SimeonSimeonovIvanov/DC-Servo/README.md

# DC-Servo

![Screen Shot](https://lh3.googleusercontent.com/Xv3BVXqilZLEP8sdvjcjL_cJQlbgq7jir3yXWfOCIcPaj5MP4WAdabvjKhuMbhHNSys4aJBLH0ocGfEHUz21YXoTrse0sBRuv8U6clvefDdncbCatKfYfFrh_Kx5vuFFZ4D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)<br>
![Screen Shot](https://lh3.googleusercontent.com/8H75xgIba8NfEHbxRjB1vH5L4gFnyypGXjzJJ4FnqissgkqRR1jED1oAVVKYW1irBBSW7dX9zWwABgqFDOacOuICHrz5z6lwR_7vQ9Z6tNkFcHOUY45h3Q94_kpth4GqoXR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)<br>
[DC Servo - Pulse Testing](https://www.youtube.com/watch?v=2nZXUcoeyds)<br>
[Images](https://photos.google.com/share/AF1QipMzZ-ynxjgMDZ_RqFM_1IZ0rQbRRlL92HL_IAoDkJfIh321sr6dbftCyruxnr1hNQ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)<br>

http://mcu-bg.com/mcu_site/viewtopic.php?p=176662#p176662:<br>
"Здравейте,

Покрай РОБКО 01 започнах разработка на аналогово DC Servo или по-точно серво усилвател управляващ постояннотоков мотор по скорост. Следващата стъпка е добавяне на Motion Controler. За момента преправям готов код но ще мине доста време до първите тестове.

Сервото се състой от два отделни модула (платки):

1) Токов регулатор (Power Stage.sch) – поддържа тока (въртящия момента) на мотора постоянен спрямо заданието от скоростния регулатор. Предпочетох да избегна аналоговия PI регулатор с по-добрия (според мене) токов ШИМ - на практика P регулатор с голям коефициент на усилване.

2) Скоростен регулатор (Speed Reg.sch) – поддържа ъгловата скорост на мотора постоянна спрямо аналогово задание от ±10V. Самия регулатор има Ramp генератор определящ времето за развъртане на двигателя, цифров вход за реверс удобен при свързване с контролер с еднополярен DAC. Заданието за ток е положително, а посоката се задава от скоростния регулатор през схема генерираща мъртво време за отделните рамена на H-моста. Рзбира и един от най-важните възли – токоограничение. Подходящ в приложения изискващи регулиране на максималния въртящ момент.

Прикачам архив съдържащ две версии на сервото:
1) v.0.0.0 – по нея е изработен прототипа но има множество забележки.
2) v.0.0.1 – в схемата са отстранени голяма част грешките / пропуските от v.0.0.0 но не са довършени платките.

Актуални са EAGLE 5.11 файловете и PDF съдържащи схемите. Архива съдържа и CircuitMaker 2000 симулации на отделните възли.

В показаният playlist се вижда преходната характеристика на скоростния регулатор при различни задания:

DC Servo - Playlist

При проектирането съм ползвал схемни решения от тиристорни регулатори КЕМТОР, КЕМРОС и други. Дължа благодарности на работодателите ми от ЕЛСИ ООД за споделения опит в областта на тиристорните задвижвания.

Поздрави,
Симеон Иванов

РУСЕ,
2014г."

http://mcu-bg.com/mcu_site/viewtopic.php?p=281388#p281388:

"Малко симулации направени по време на разработката / Git: DC-Servo /:
Analog Current PI Loop, FB signal:"

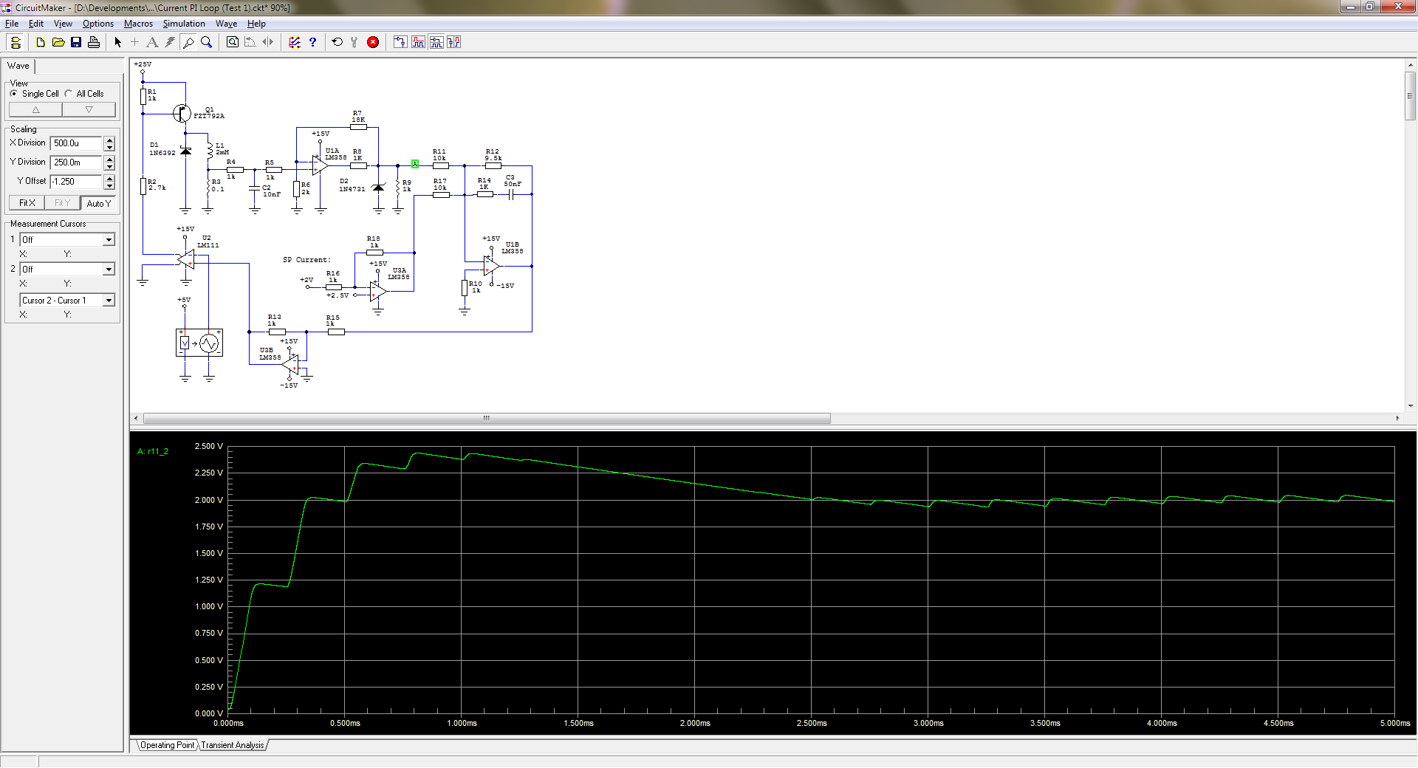
[picture p1: Work/Simulation/Current PI Loop/Current PI Loop (Test 1) - FB.png]
<br>

Current PWM (Digital):
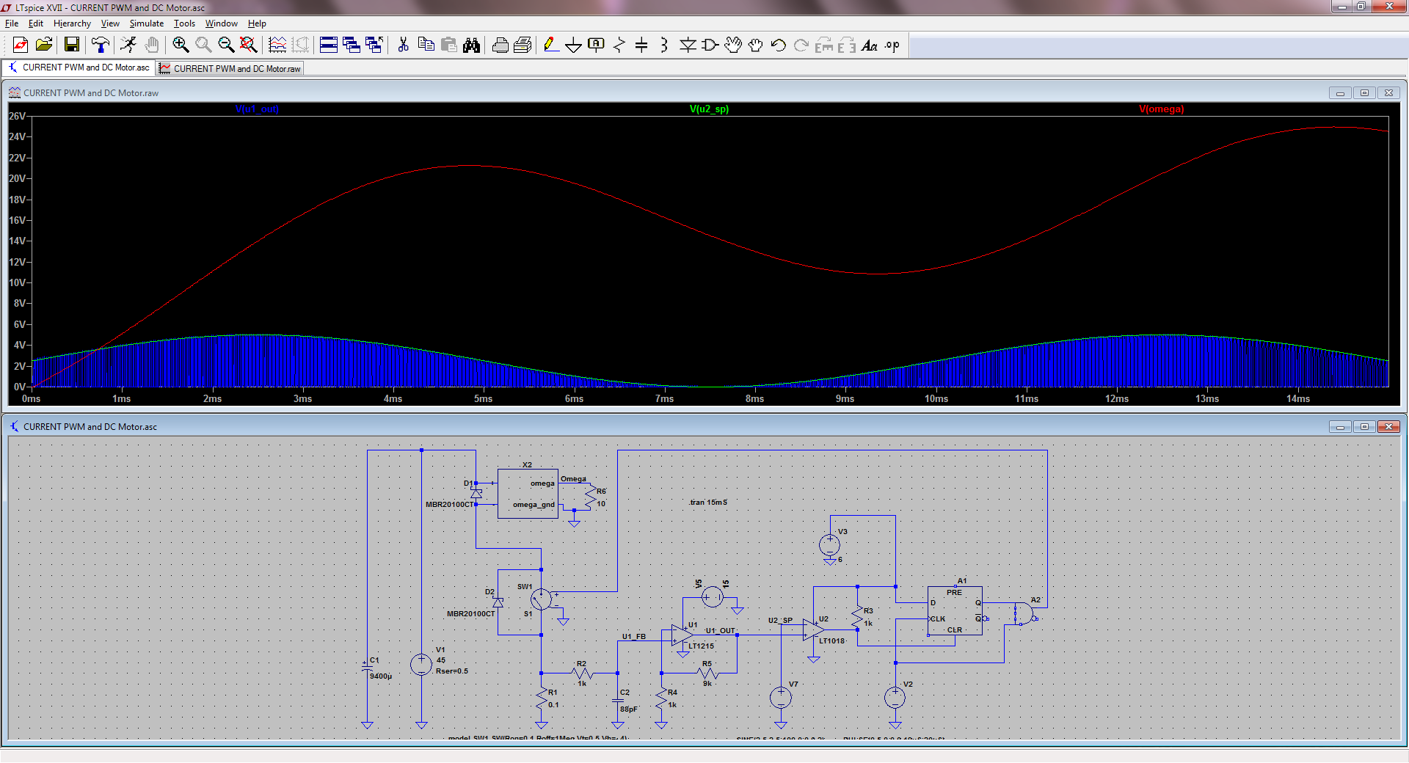
[picture p2: Work/Simulation/CURRENT PWM/CURRENT PWM and DC Motor.png]
<br>
