SimeonSimeonovIvanov/DC-Servo/doc/DC Servo (Power Point)/DC Servo (04.04.2015).pdf

ПРИЛОЖЕН СЕМИНАР ПО ЕЛЕКТРОНИКА И СОФТУЕР
РУСЕНСКИ УНИВЕРСИТЕТ „АНГЕЛ КЪНЧЕВ” 2015 г.

### Серво усилвател и позиционен контролер за DC мотор

гр.Русе, 2015

автор: Симеон Иванов

## Цел

- Управление на постоянотоков мотор по зададен момент, скорост и позиция

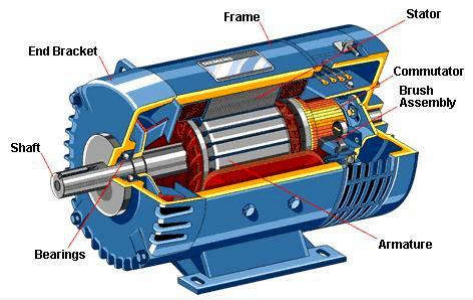
[picture p3: figure]

### Постоянотокови мотор

- Постоянотоковите мотори (DC Motors) се делят на две големи групи:
1. Четкови
2. Безчеткови (BLDC)
- При четковите мотори комутацията на тока през намотките се осъществява механично
- Безчетковите мотори ползват електронен комутатор

### Базов модел на DC motor

- Момента на мотор M [Nm] е пропорционален на тока през мотора I !

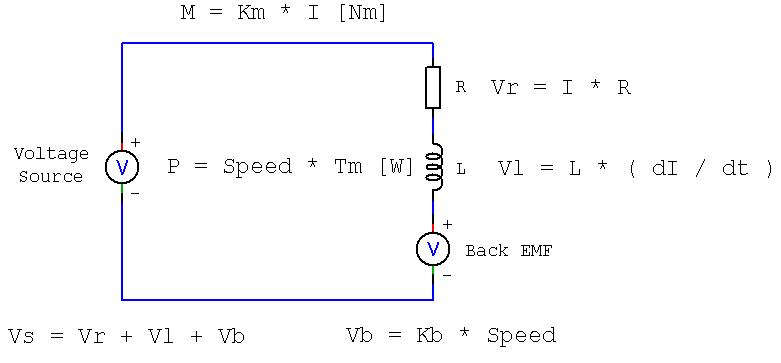
[picture p4: figure]

### Блокова схема на серво усилвател

- Система за автоматично регулиране изградена с два затворени контура (Closed-loop)

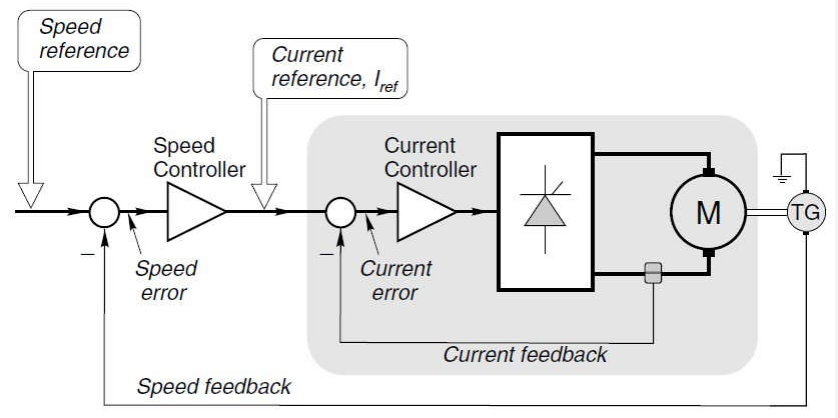
[picture p5: figure]

### Токов регулатор Класически метод

- Пропорционално - интегрален (PI) регулатор
- Напреженов ШИМ (PWM)

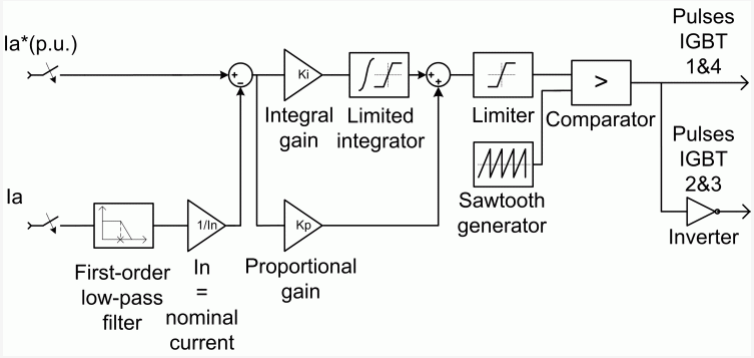
[picture p6: figure]

### Токов регулатор реализиран с токов ШИМ

- Ползва се ШИМ ограничаващ запълването си във всеки период

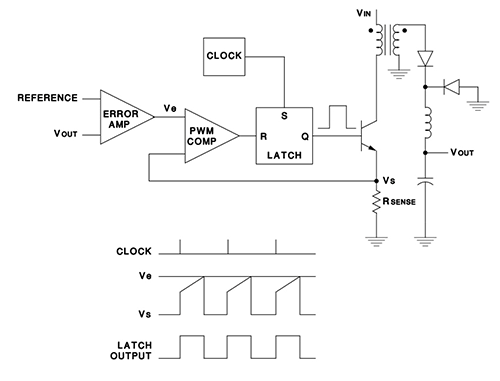
[picture p7: figure]

## Силова част – общ изглед

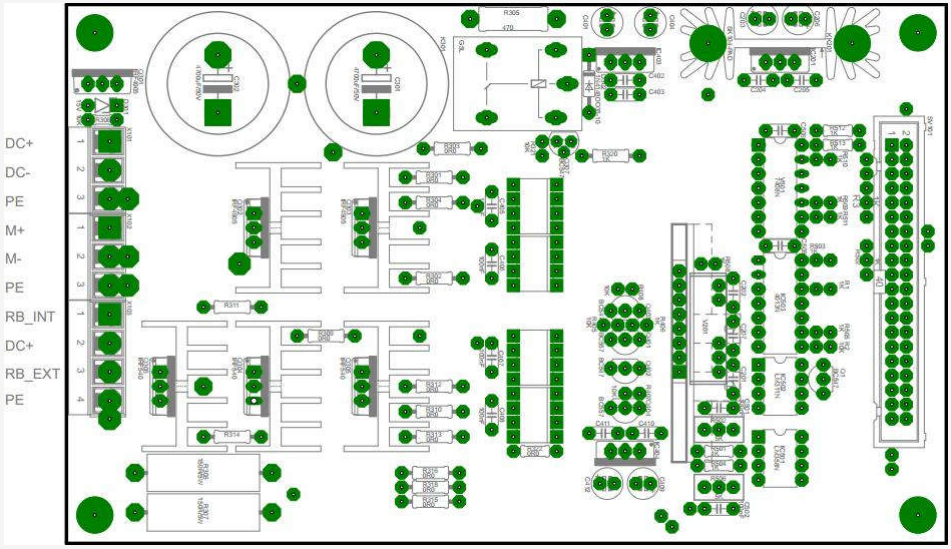
[picture p8: figure]

### Скоростен регулатор

- Аналогов пропорционално - интегрален регулатор

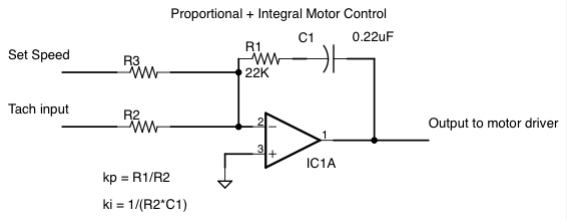
[picture p9: figure]

### Управляваща платка - общ изглед

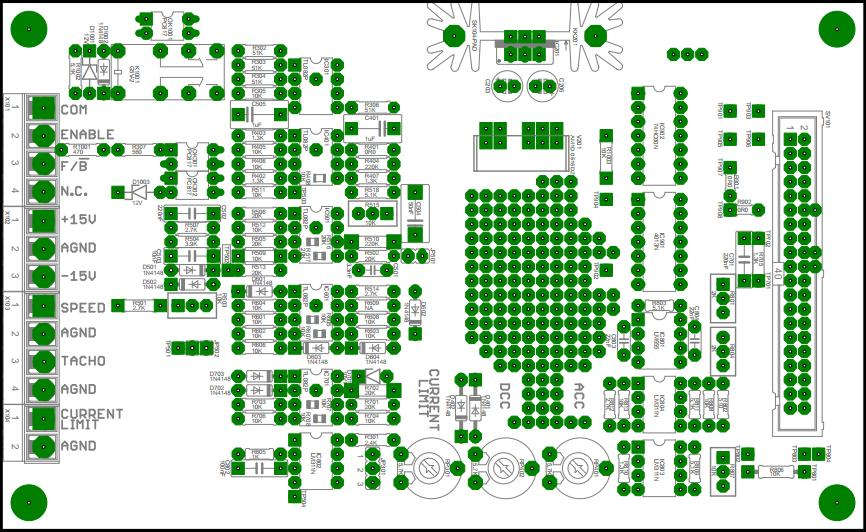
[picture p10: figure]

### Аналогов контрол на позиция

- Добавя се трети управляващ контур – позиционен регулатор

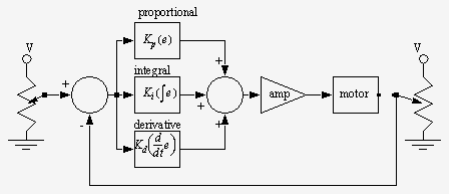
[picture p11: figure]

### Цифров позиционен регулатор

- Замяна на аналоговия PID с цифров регулатор
- Системата става много по-универсална и лесна за настройка
- Добавя се комуникация осигоряваща връзка с други устроиства

### Контролер на движението Motion Controller

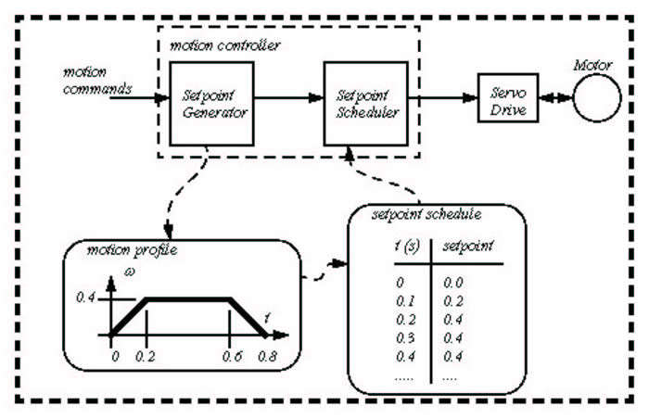
[picture p12: figure]
