SimeonSimeonovIvanov/DC-Servo/Work/Simulation/Brake.pdf

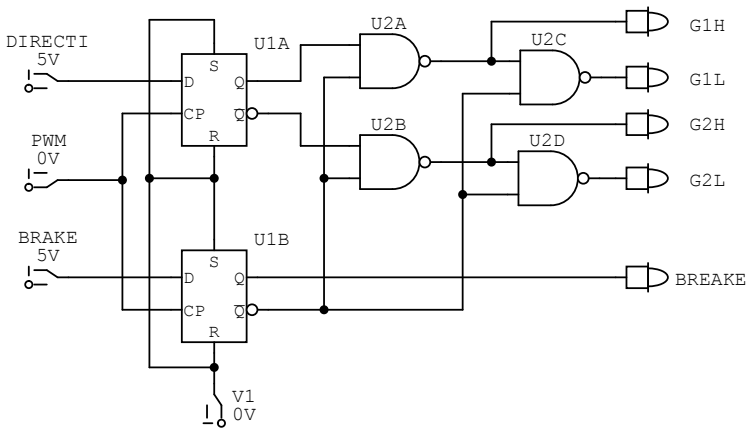
[picture p13: figure]
DIRECTI 5V; PWM 0V; BRAKE 5V; BREAKE
