SimeonSimeonovIvanov/DC-Servo/Work/Simulation/Dead Time.pdf

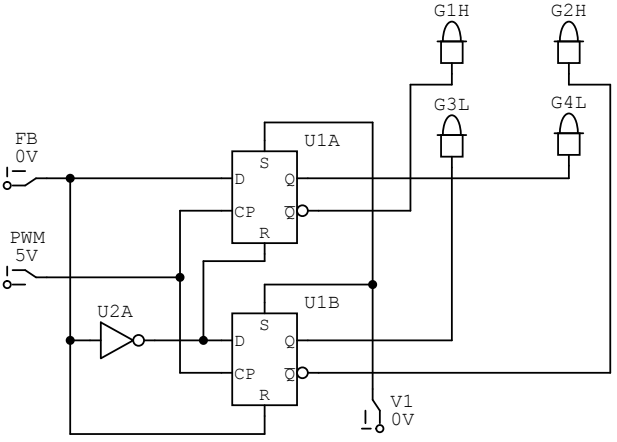
[picture p14: figure]
PWM 5V
