SimeonSimeonovIvanov/DC-Servo/Scheme and Board/v.0.0.1/Speed Reg/Simulation/Dead Time.pdf

PWM 5V
