SimeonSimeonovIvanov/DC-Servo/doc/DC Servo (Power Point)/img/001.JPG

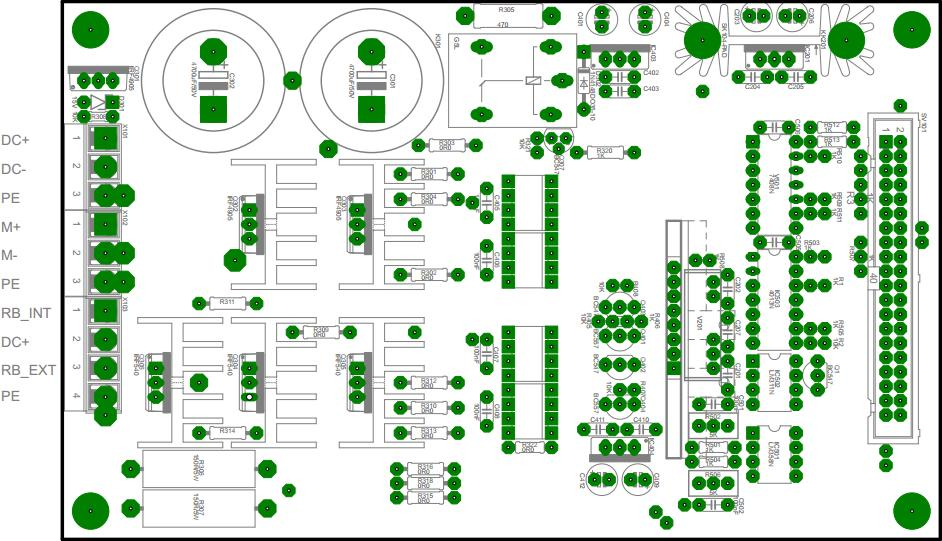
doc/DC Servo (Power Point)/img/001.JPG
