SimeonSimeonovIvanov/DC-Servo/doc/DC Servo (Power Point)/img/CURRENT PWM 2.ckt.JPG

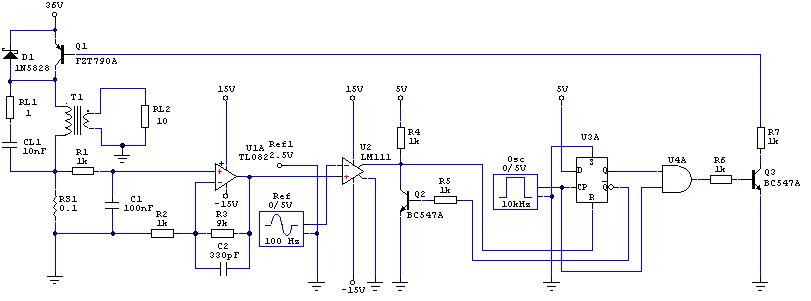
doc/DC Servo (Power Point)/img/CURRENT PWM 2.ckt.JPG
