SimeonSimeonovIvanov/DC-Servo/doc/DC Servo (Power Point)/img/dc_motor_drives_fig4.11.jpg

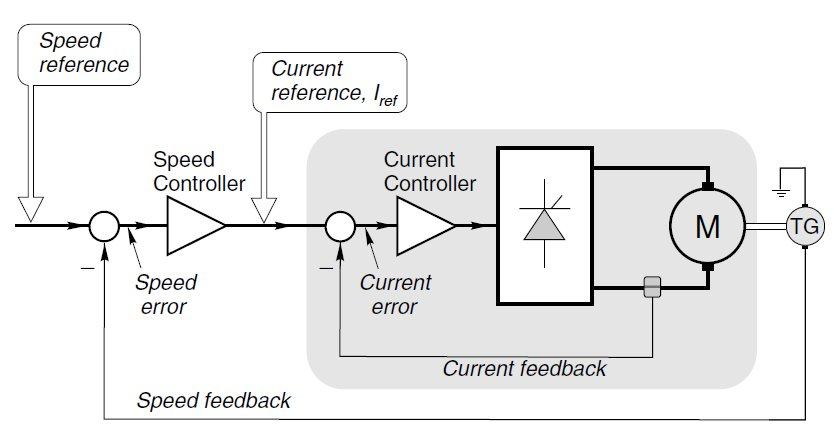
doc/DC Servo (Power Point)/img/dc_motor_drives_fig4.11.jpg
