SimeonSimeonovIvanov/DC-Servo/doc/DC Servo (Power Point)/img/engineeronadisk-56.gif

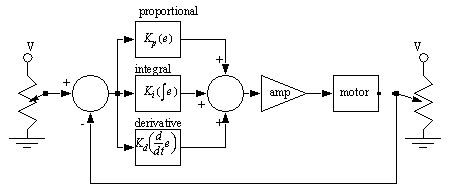
doc/DC Servo (Power Point)/img/engineeronadisk-56.gif
