SimeonSimeonovIvanov/DC-Servo/doc/DC Servo (Power Point)/img/f36f957f72a093559175396d0ab32c18.jpg

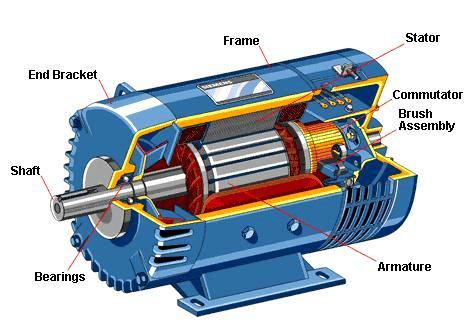
doc/DC Servo (Power Point)/img/f36f957f72a093559175396d0ab32c18.jpg
