SimeonSimeonovIvanov/DC-Servo/Work/Simulation/Current Limit.png

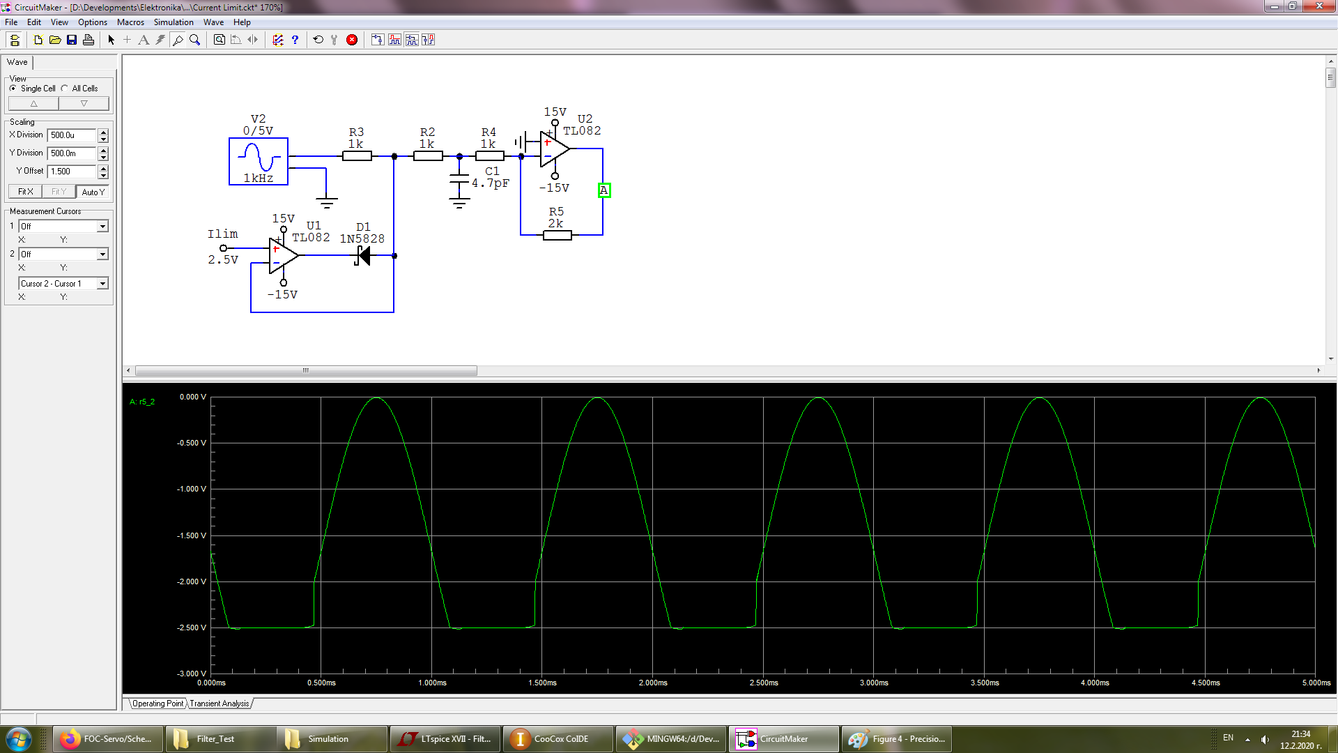
Work/Simulation/Current Limit.png
