SimeonSimeonovIvanov/DC-Servo/Work/Simulation/CURRENT PWM/CURRENT PWM 1.png

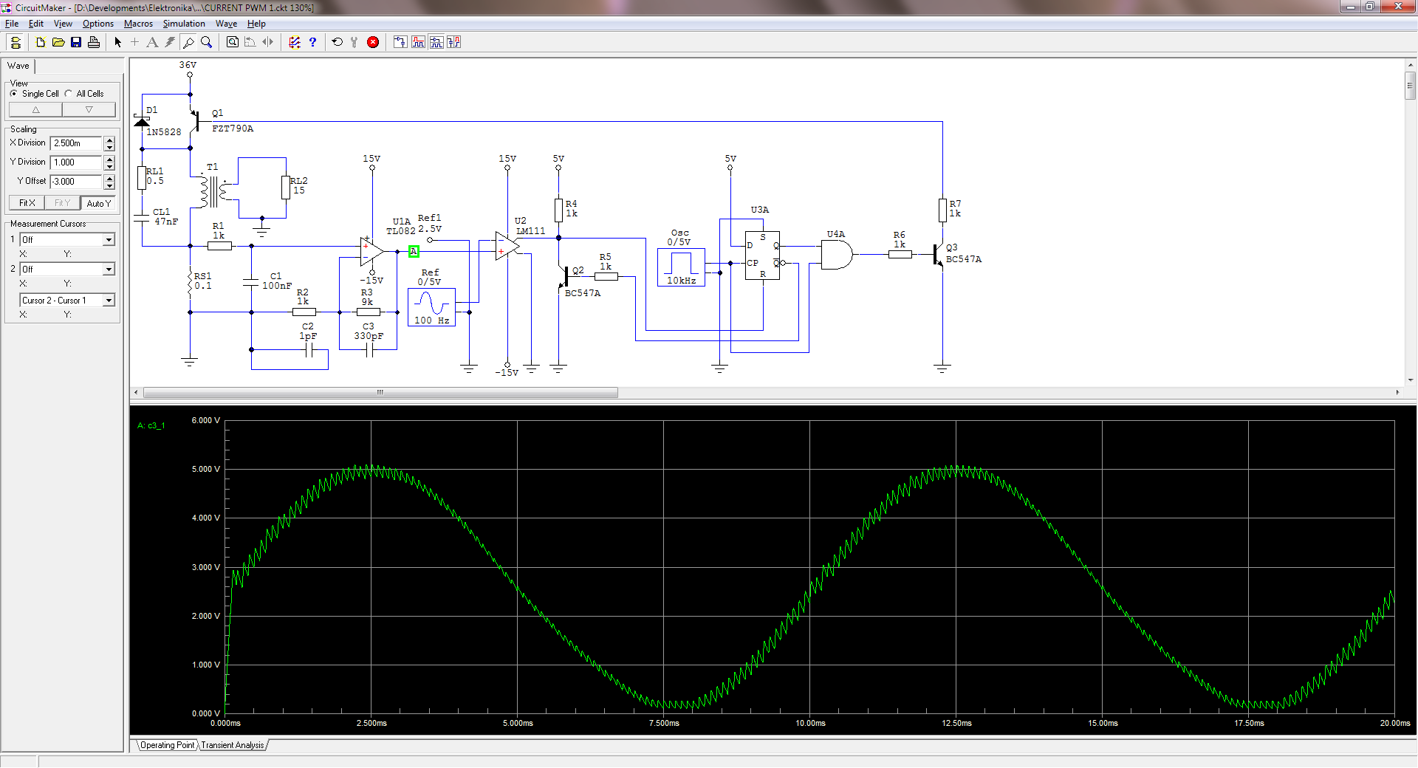
Work/Simulation/CURRENT PWM/CURRENT PWM 1.png
