SimeonSimeonovIvanov/DC-Servo/Work/Simulation/CURRENT PWM/CURRENT PWM 2.png

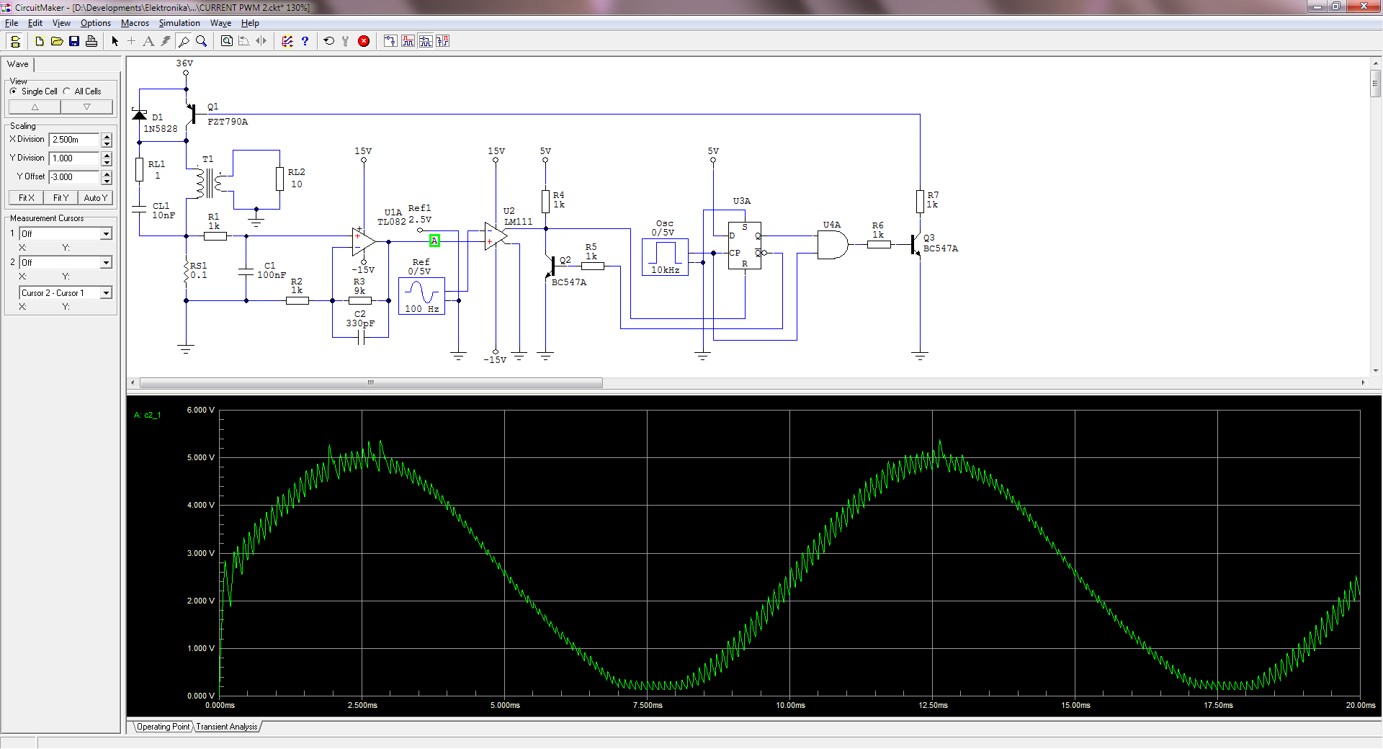
Work/Simulation/CURRENT PWM/CURRENT PWM 2.png
