SimeonSimeonovIvanov/DC-Servo/Work/Simulation/CURRENT PWM/DC_Motor.asc.png

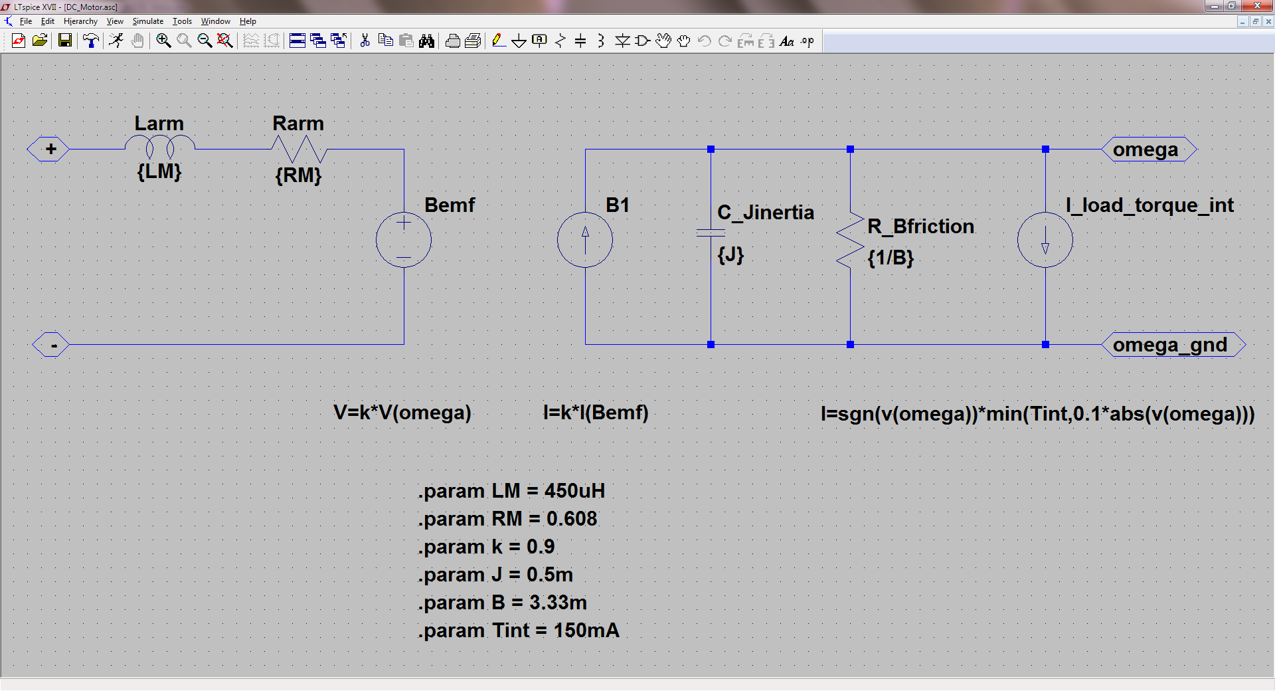
Work/Simulation/CURRENT PWM/DC_Motor.asc.png
