SimeonSimeonovIvanov/DC-Servo/Work/Simulation/Figure 4 - Precision Full Wave Rectifier.png

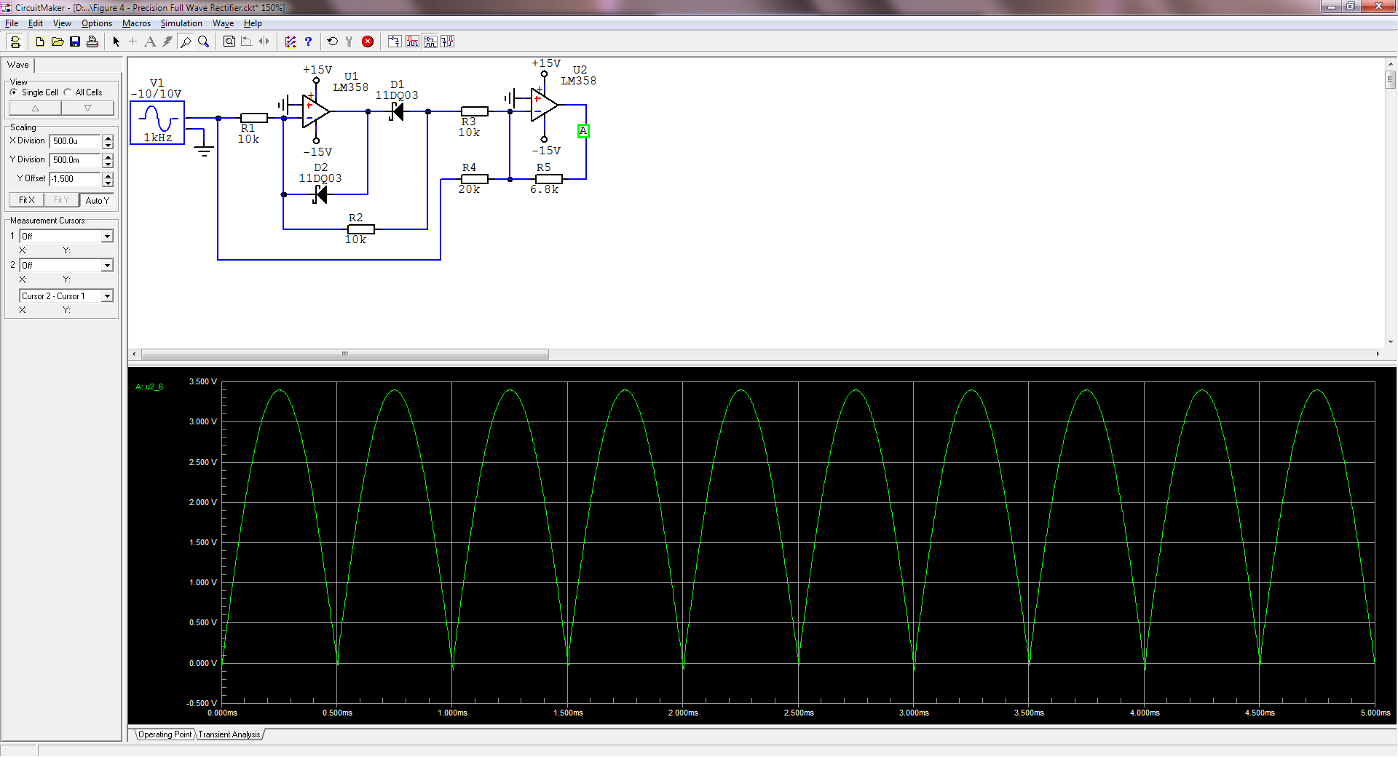
Work/Simulation/Figure 4 - Precision Full Wave Rectifier.png
