SimeonSimeonovIvanov/DC-Servo/Work/Simulation/Forward - Backward.png

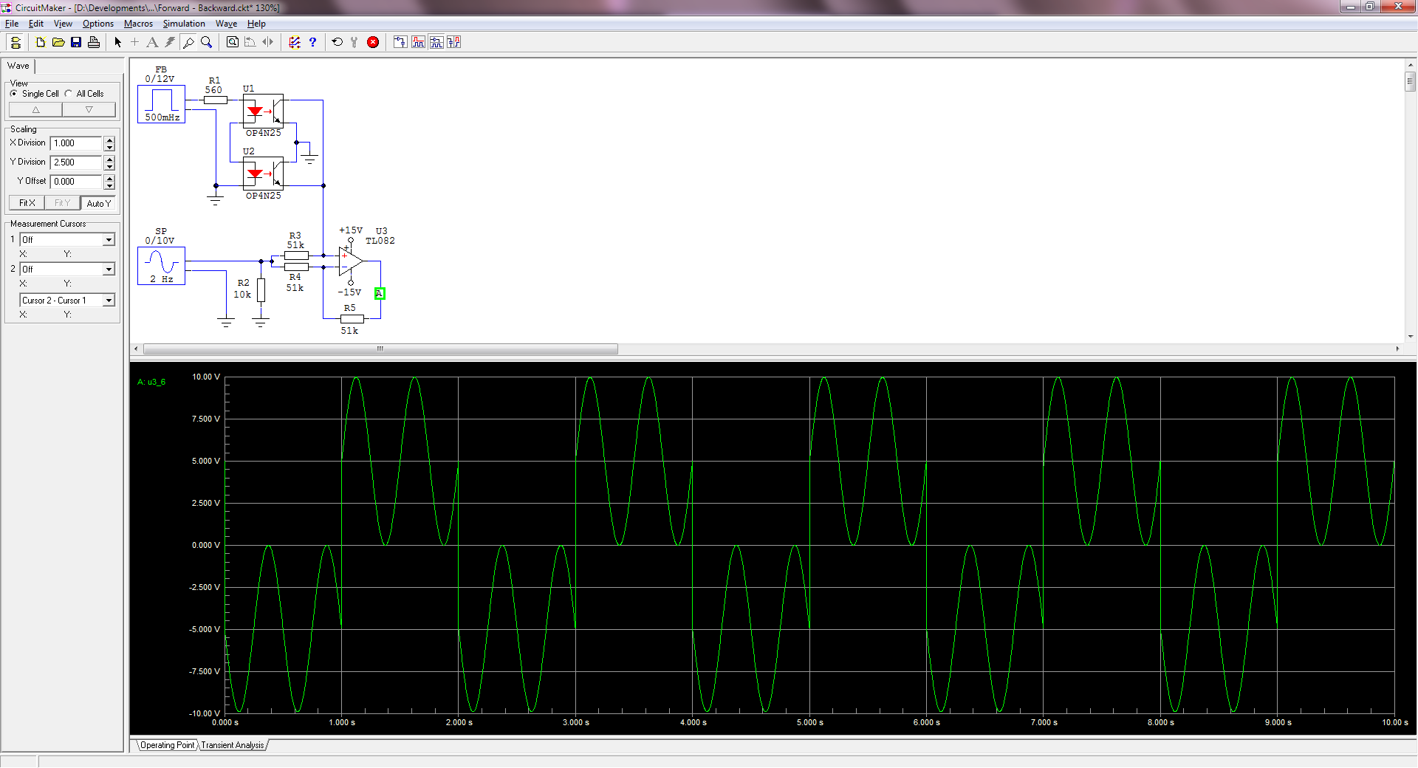
Work/Simulation/Forward - Backward.png
