SimeonSimeonovIvanov/DC-Servo/Work/Simulation/Level Limiter (ELEKTROINVENT).png

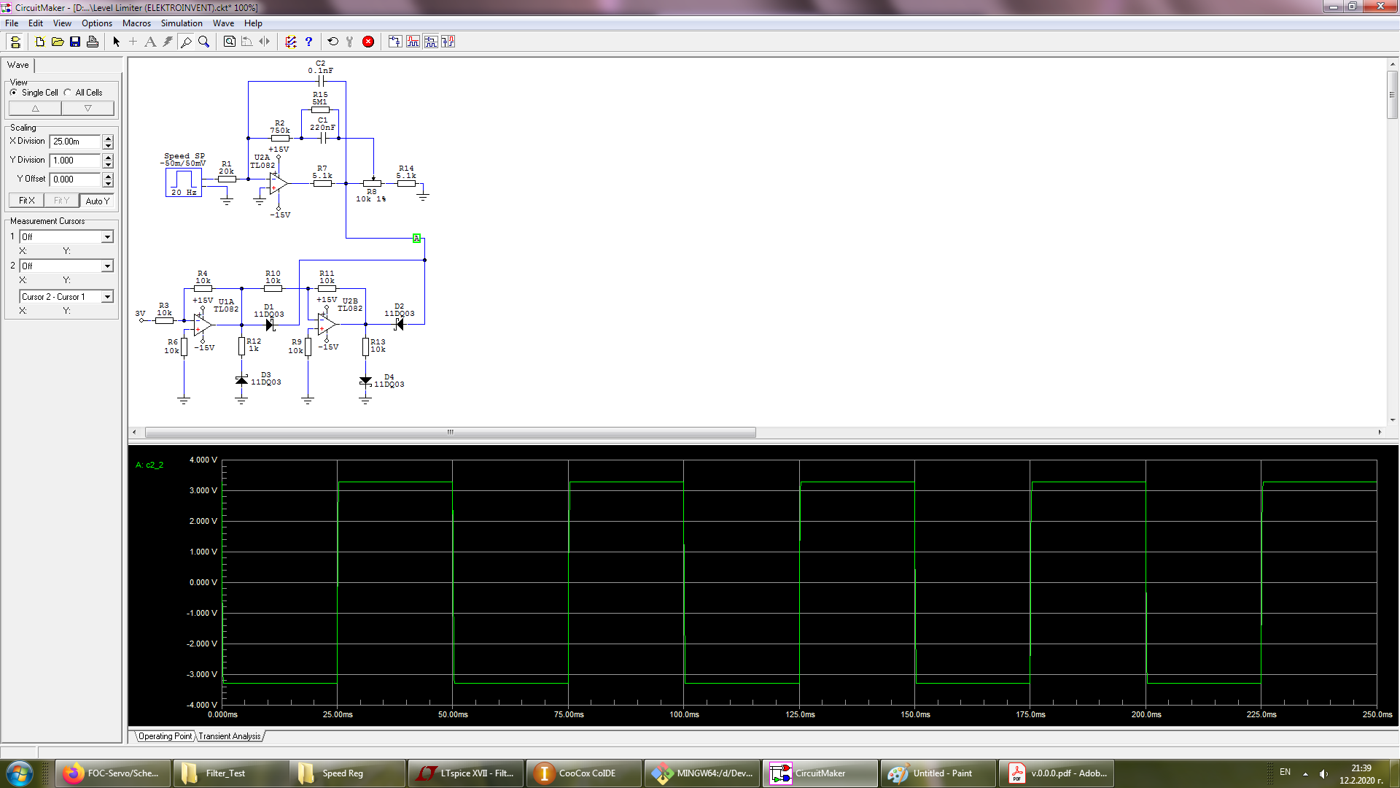
Work/Simulation/Level Limiter (ELEKTROINVENT).png
