SimeonSimeonovIvanov/DC-Servo/Work/Simulation/Ramp Generator.png

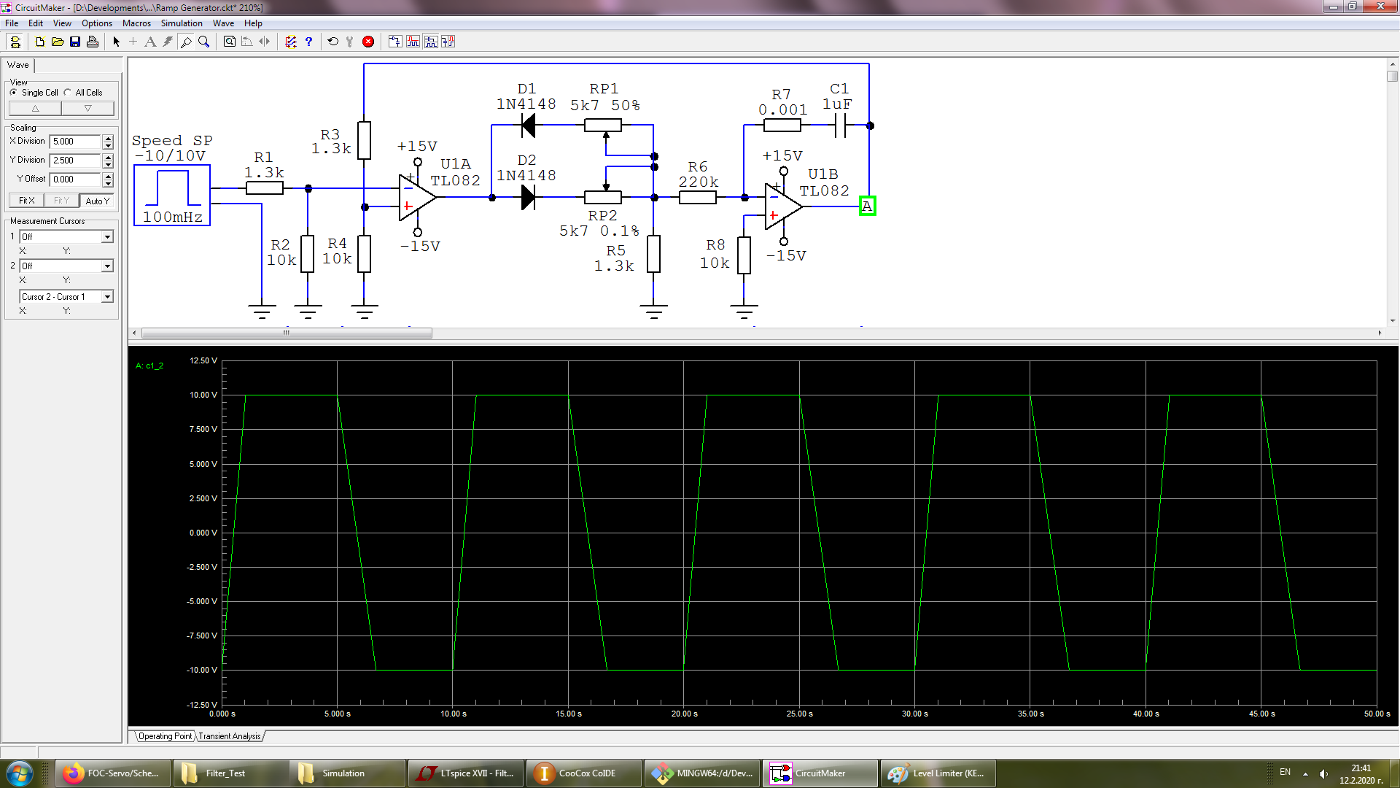
Work/Simulation/Ramp Generator.png
