SimeonSimeonovIvanov/DC-Servo/Work/Simulation/Speed Reg (PI).png

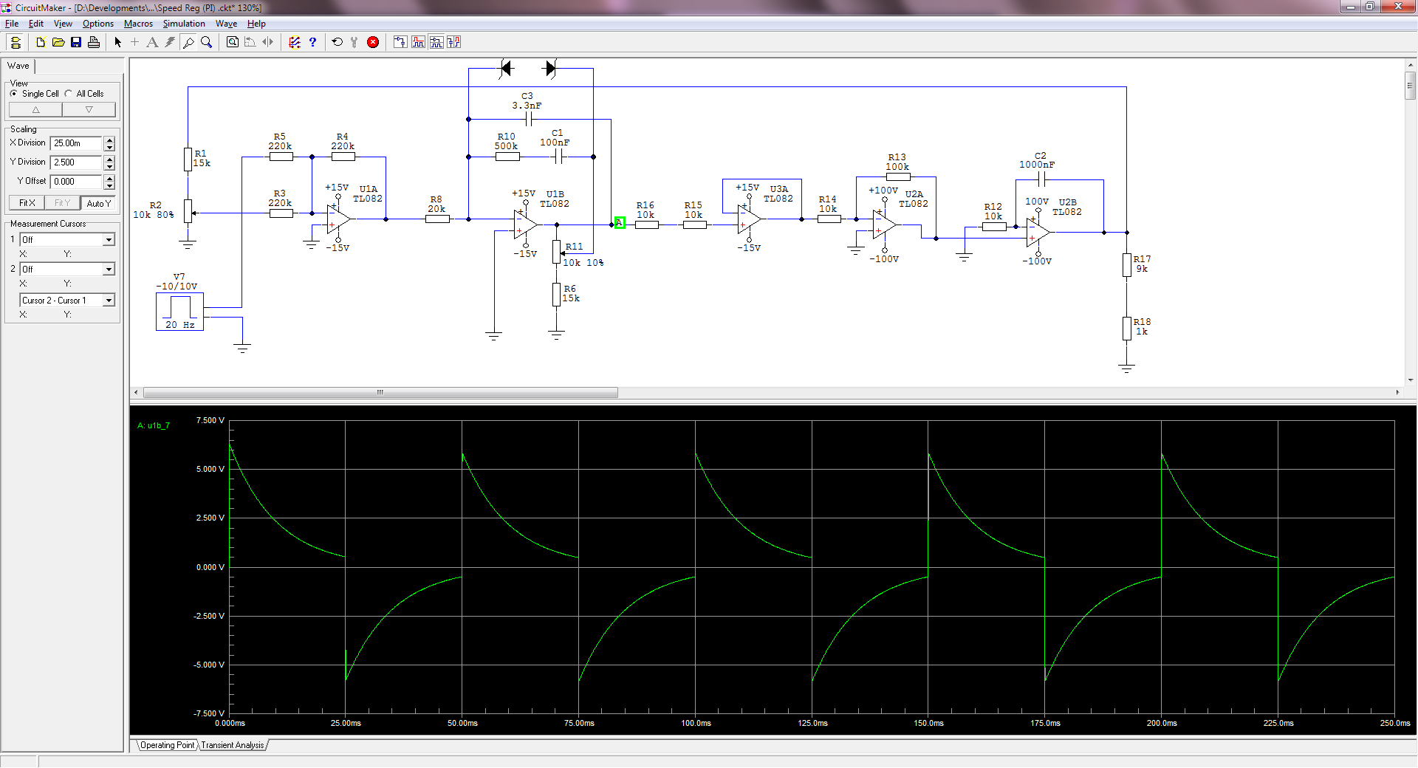
Work/Simulation/Speed Reg (PI).png
