SimeonSimeonovIvanov/DC-Servo/Scheme and Board/v.0.0.1/Speed Reg/Speed Reg.pdf

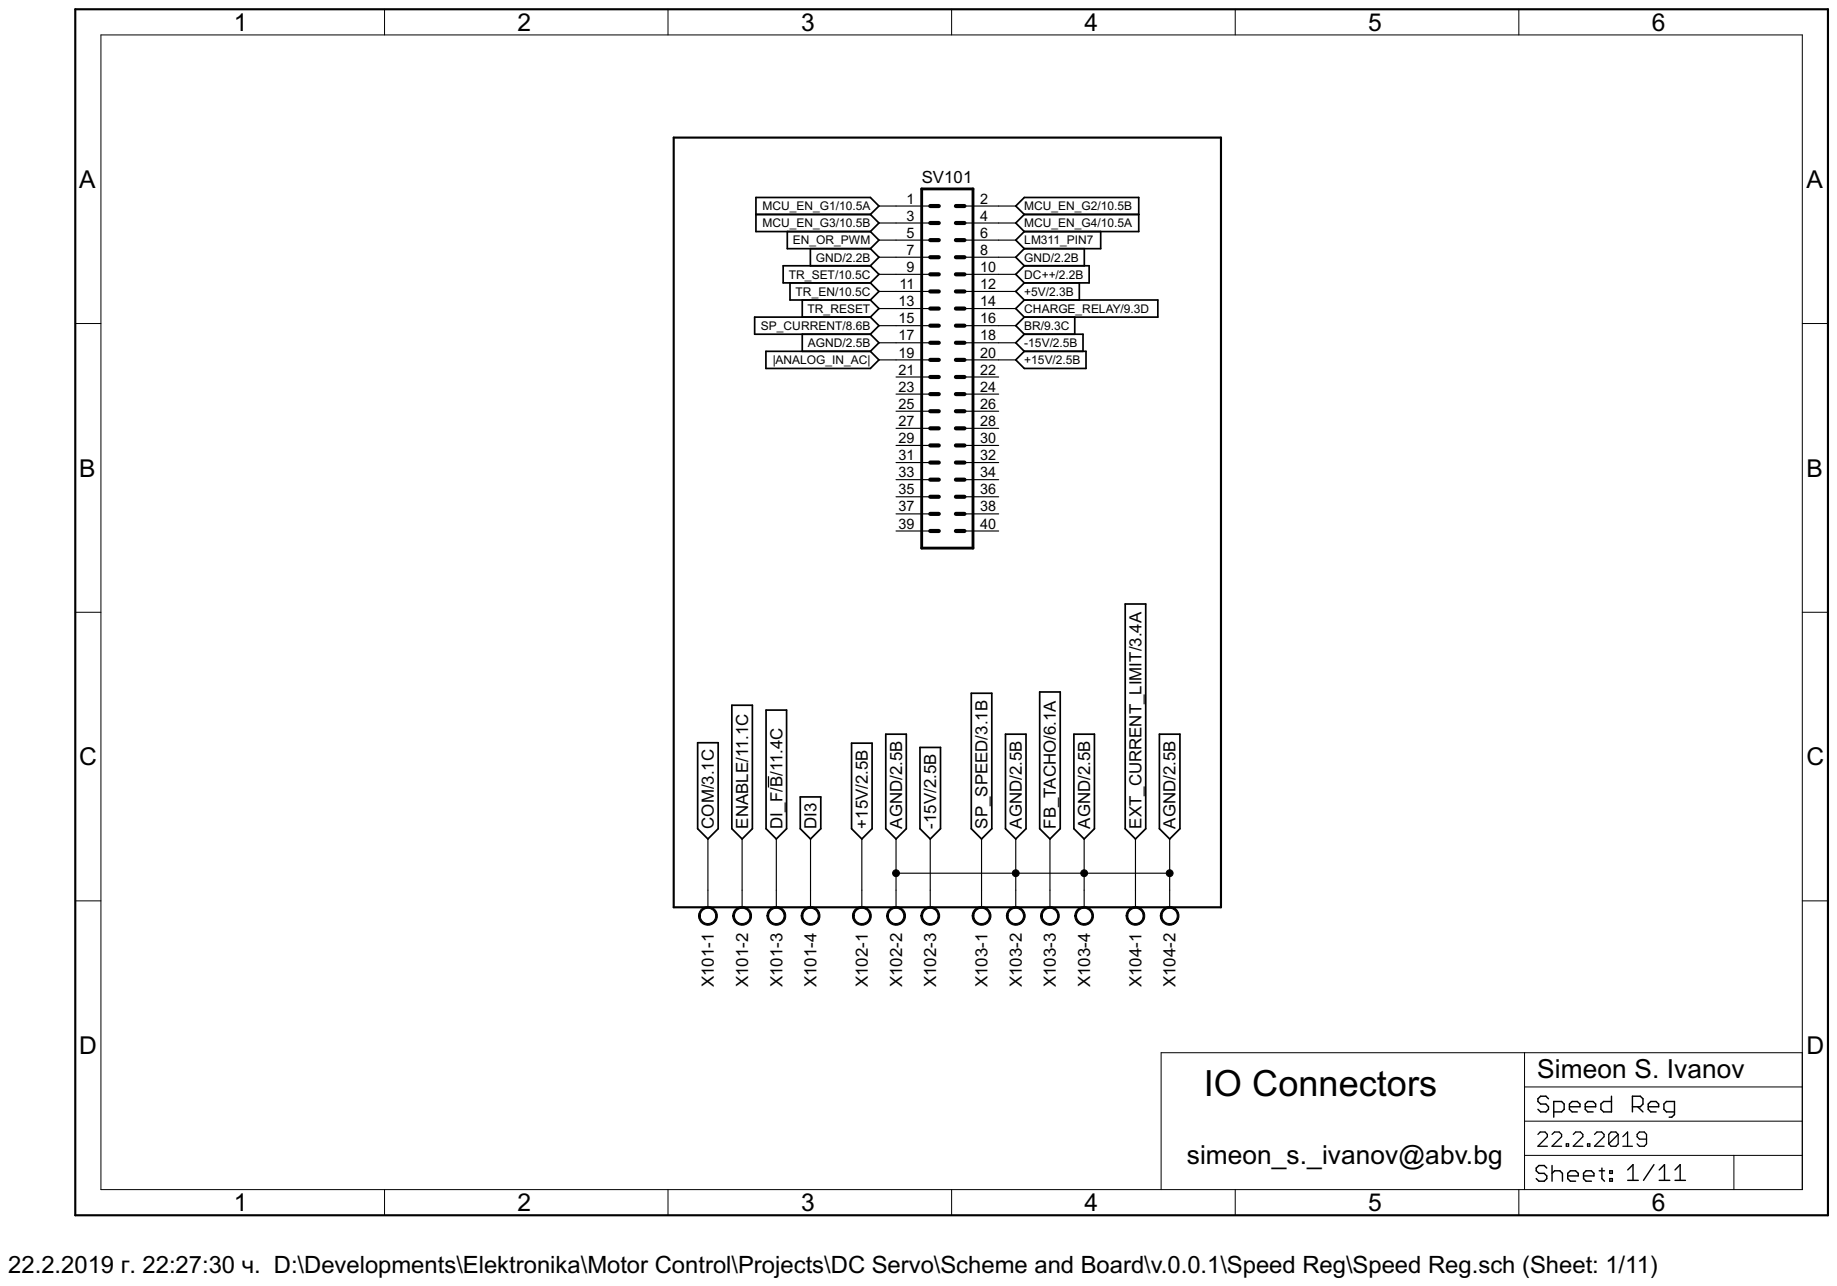
[picture p29: page 1]

AGND/2.5B | -15V/2.5B

ANALOG_IN_AC| | +15V/2.5B

22.2.2019 г. 22:27:30 ч. D:\Developments\Elektronika\Motor Control\Projects\DC Servo\Scheme and Board\v.0.0.1\Speed Reg\Speed Reg.sch (Sheet: 1/11)

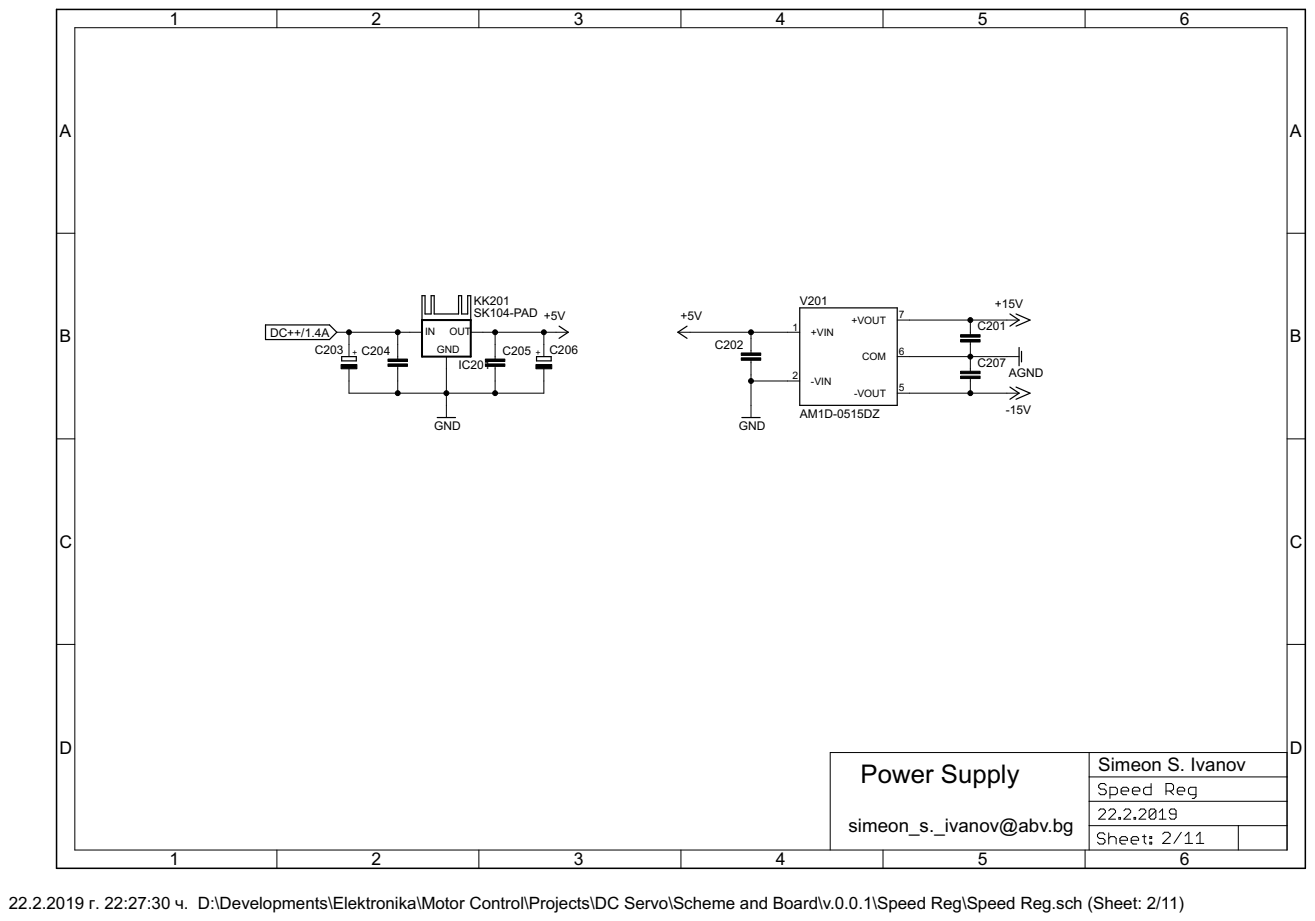
[picture p30: page 2]

Simeon S. Ivanov Power Supply

22.2.2019 г. 22:27:30 ч. D:\Developments\Elektronika\Motor Control\Projects\DC Servo\Scheme and Board\v.0.0.1\Speed Reg\Speed Reg.sch (Sheet: 2/11)

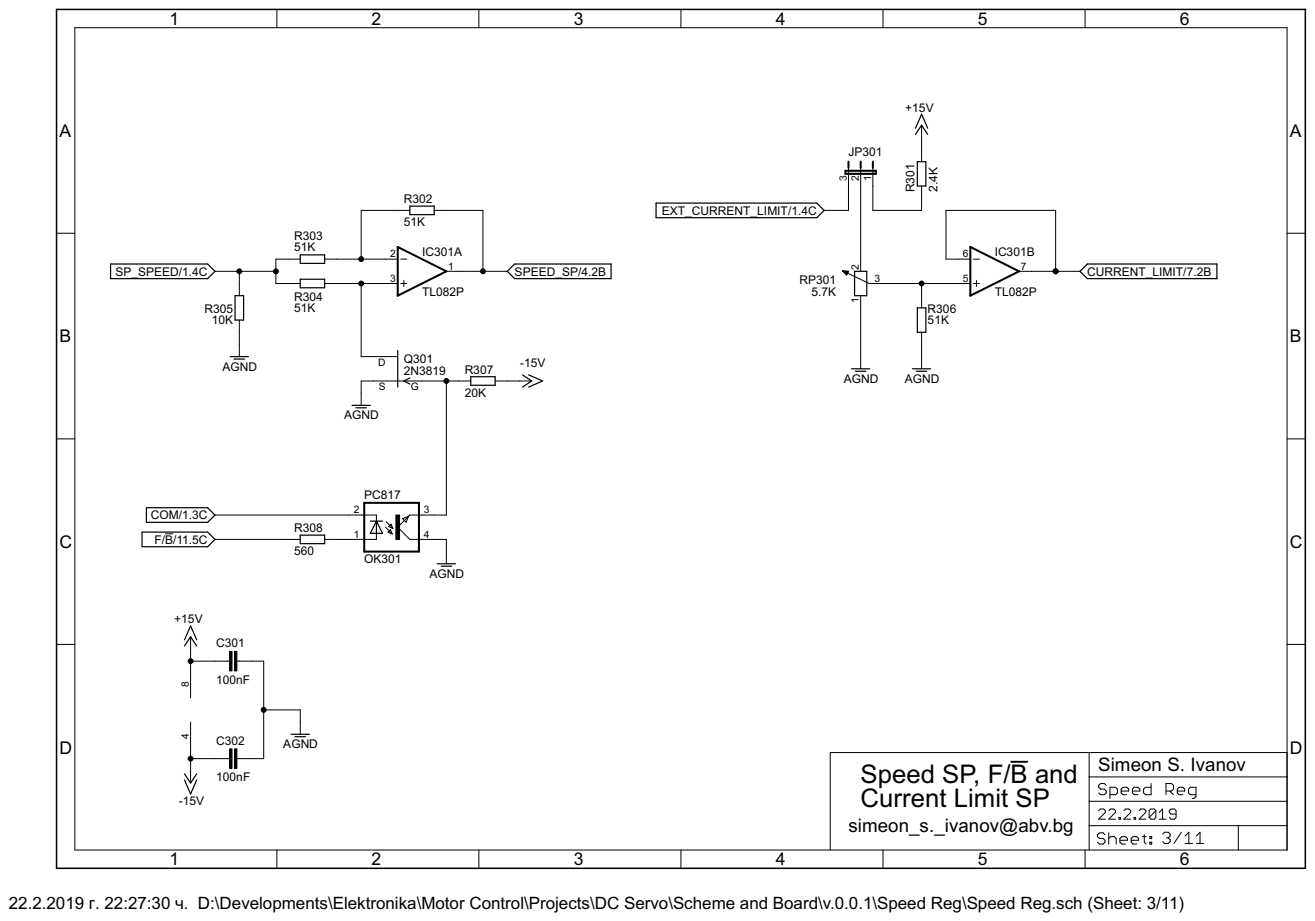
[picture p31: page 3]

Simeon S. Ivanov Speed SP, F/B and
Current Limit SP
simeon_s._ivanov@abv.bg

22.2.2019 г. 22:27:30 ч. D:\Developments\Elektronika\Motor Control\Projects\DC Servo\Scheme and Board\v.0.0.1\Speed Reg\Speed Reg.sch (Sheet: 3/11)

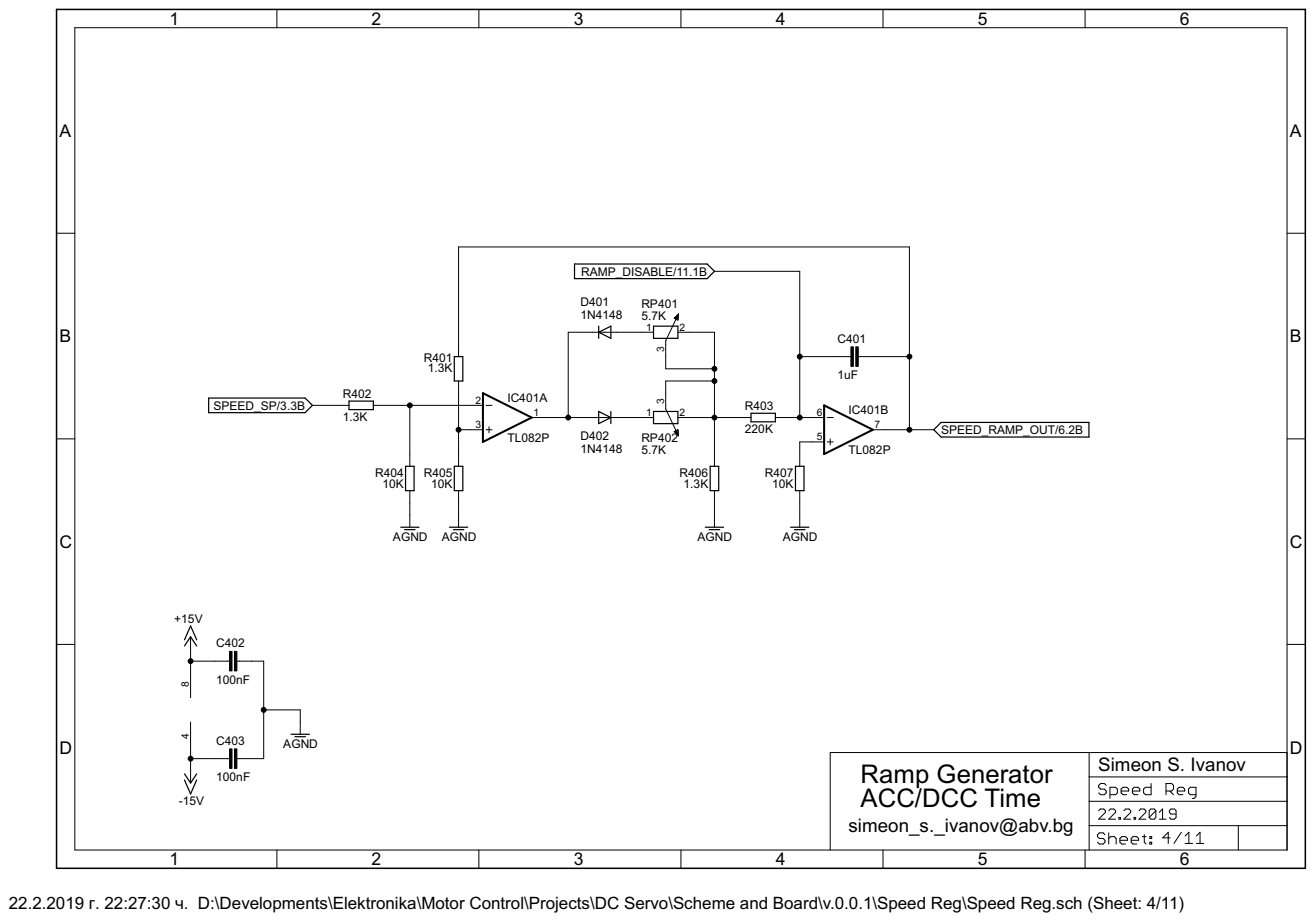
[picture p32: page 4]

Simeon S. Ivanov Ramp Generator
ACC/DCC Time
simeon_s._ivanov@abv.bg

22.2.2019 г. 22:27:30 ч. D:\Developments\Elektronika\Motor Control\Projects\DC Servo\Scheme and Board\v.0.0.1\Speed Reg\Speed Reg.sch (Sheet: 4/11)

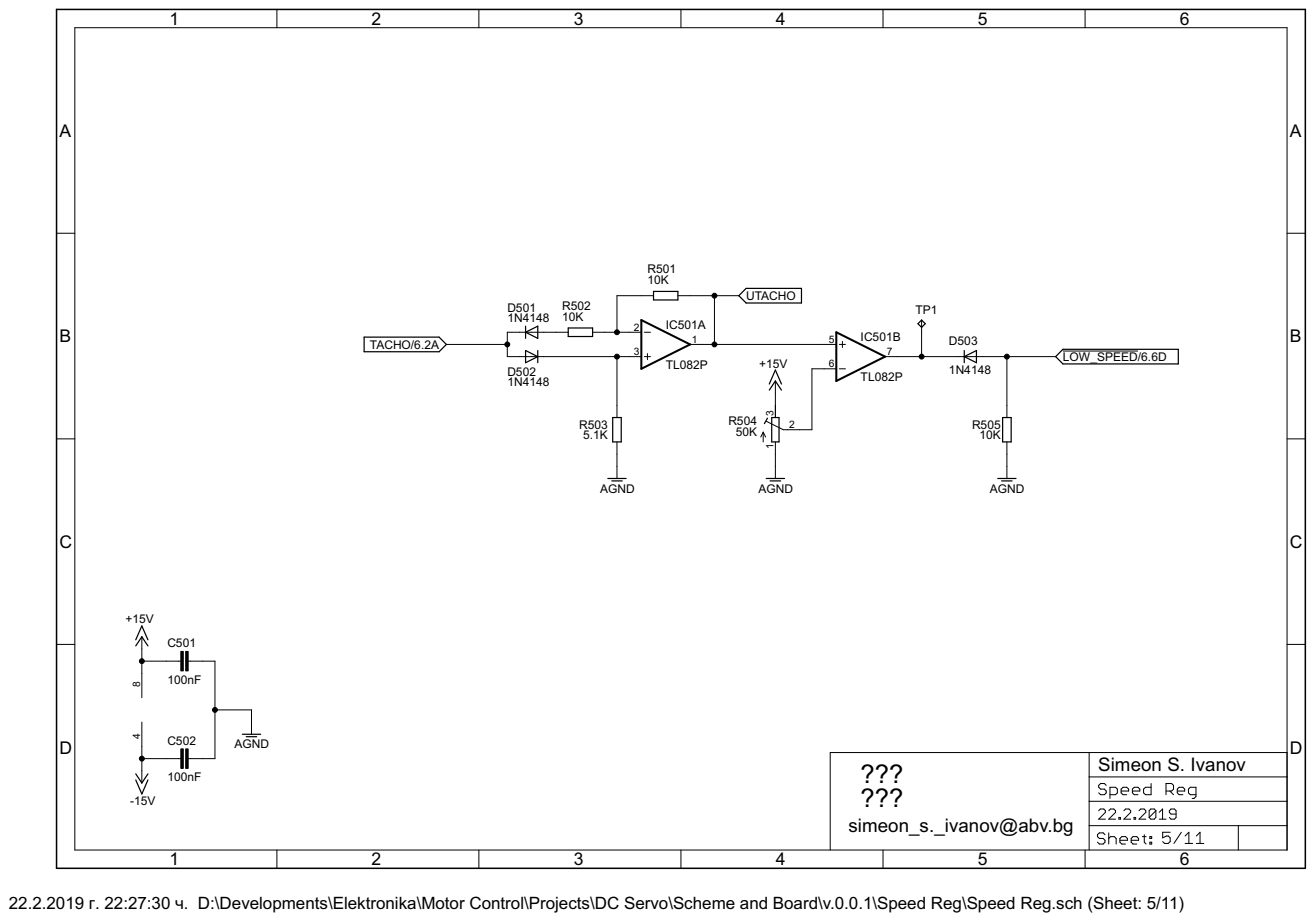
[picture p33: page 5]

22.2.2019 г. 22:27:30 ч. D:\Developments\Elektronika\Motor Control\Projects\DC Servo\Scheme and Board\v.0.0.1\Speed Reg\Speed Reg.sch (Sheet: 5/11)

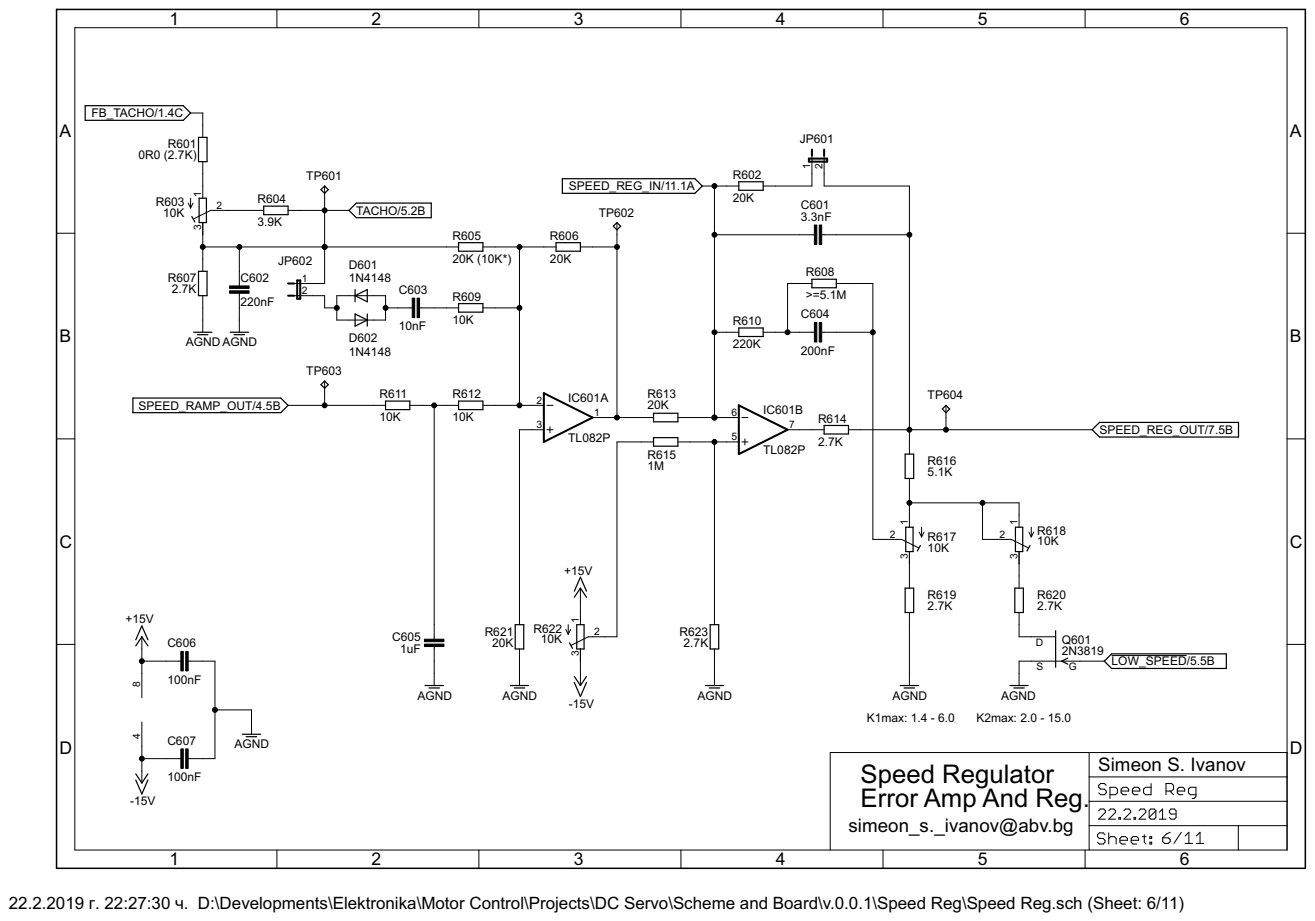
[picture p34: page 6]

Simeon S. Ivanov Speed Regulator
Error Amp And Reg. simeon_s._ivanov@abv.bg

22.2.2019 г. 22:27:30 ч. D:\Developments\Elektronika\Motor Control\Projects\DC Servo\Scheme and Board\v.0.0.1\Speed Reg\Speed Reg.sch (Sheet: 6/11)

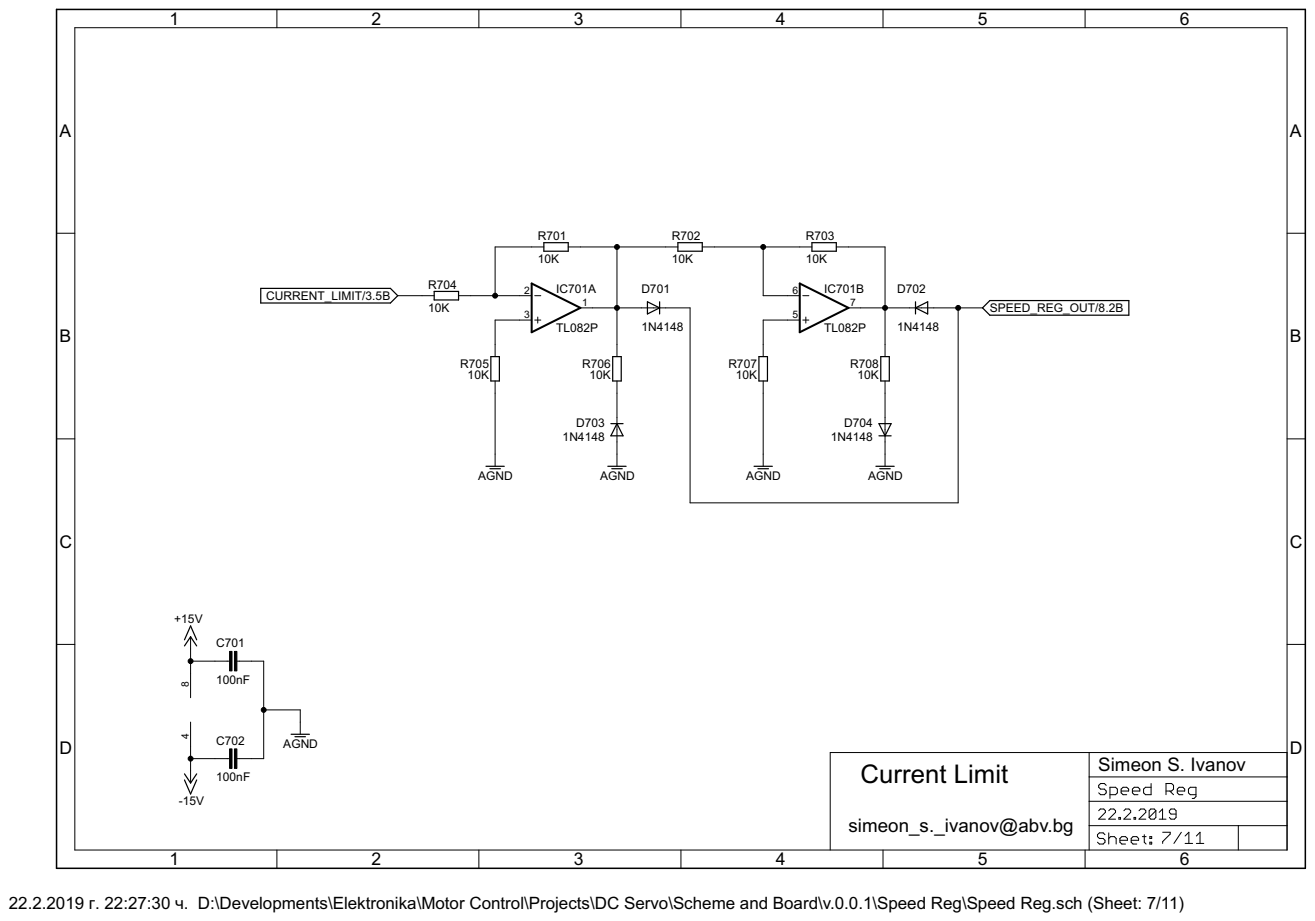
[picture p35: page 7]

Simeon S. Ivanov Current Limit

22.2.2019 г. 22:27:30 ч. D:\Developments\Elektronika\Motor Control\Projects\DC Servo\Scheme and Board\v.0.0.1\Speed Reg\Speed Reg.sch (Sheet: 7/11)

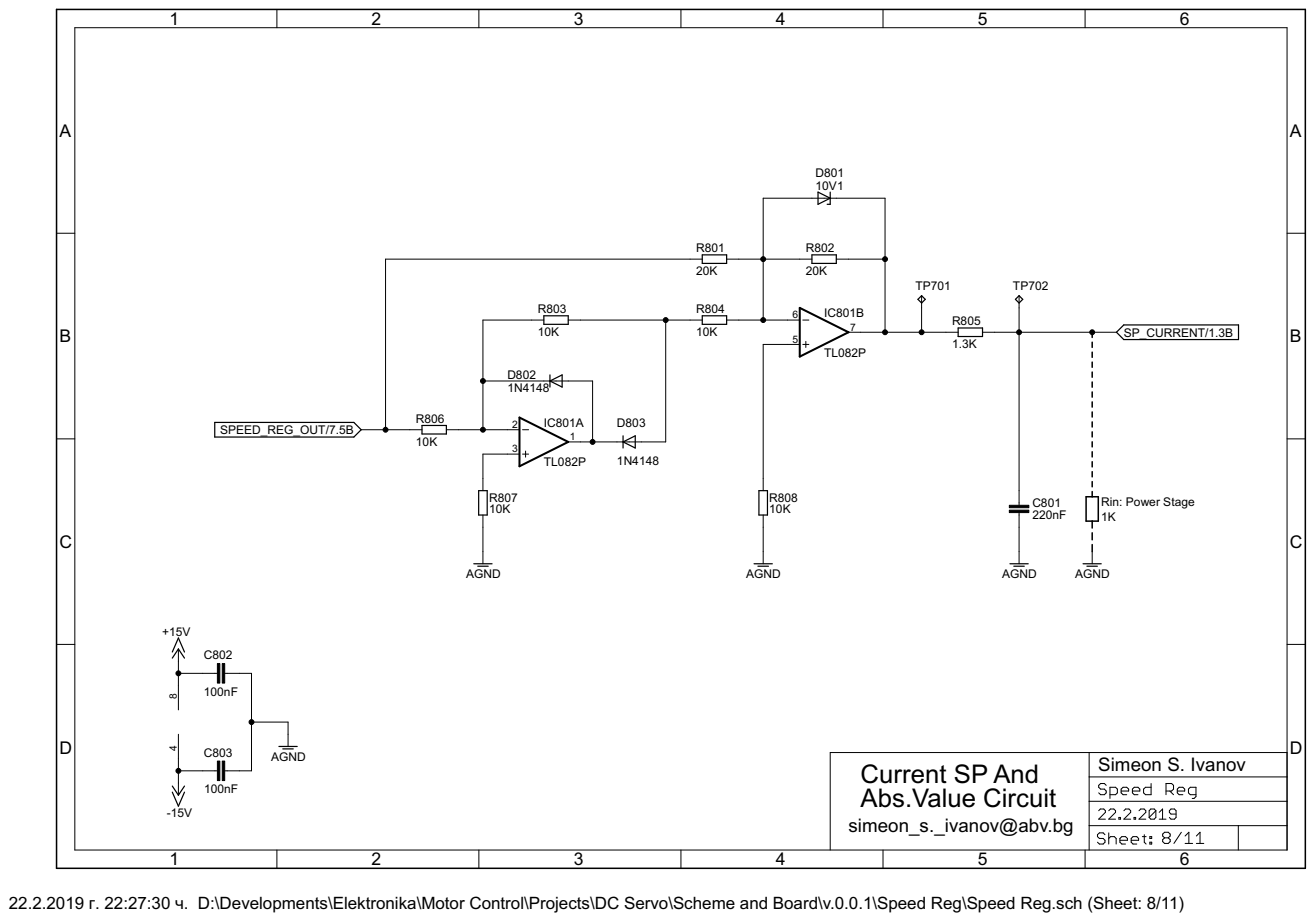
[picture p36: page 8]

Simeon S. Ivanov Current SP And
Abs.Value Circuit
simeon_s._ivanov@abv.bg

22.2.2019 г. 22:27:30 ч. D:\Developments\Elektronika\Motor Control\Projects\DC Servo\Scheme and Board\v.0.0.1\Speed Reg\Speed Reg.sch (Sheet: 8/11)

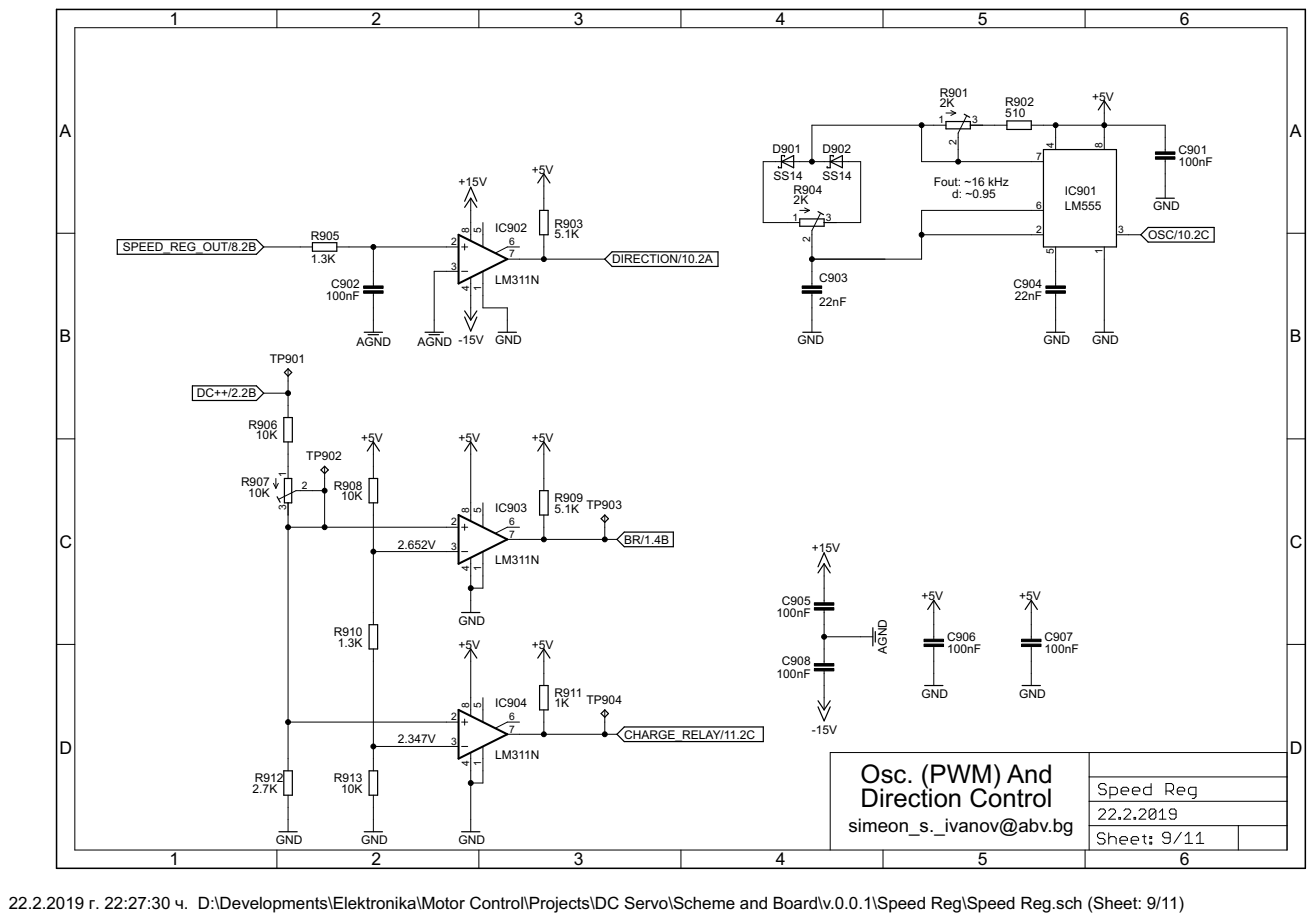
[picture p37: page 9]

Osc. (PWM) And Direction Control simeon_s._ivanov@abv.bg

22.2.2019 г. 22:27:30 ч. D:\Developments\Elektronika\Motor Control\Projects\DC Servo\Scheme and Board\v.0.0.1\Speed Reg\Speed Reg.sch (Sheet: 9/11)

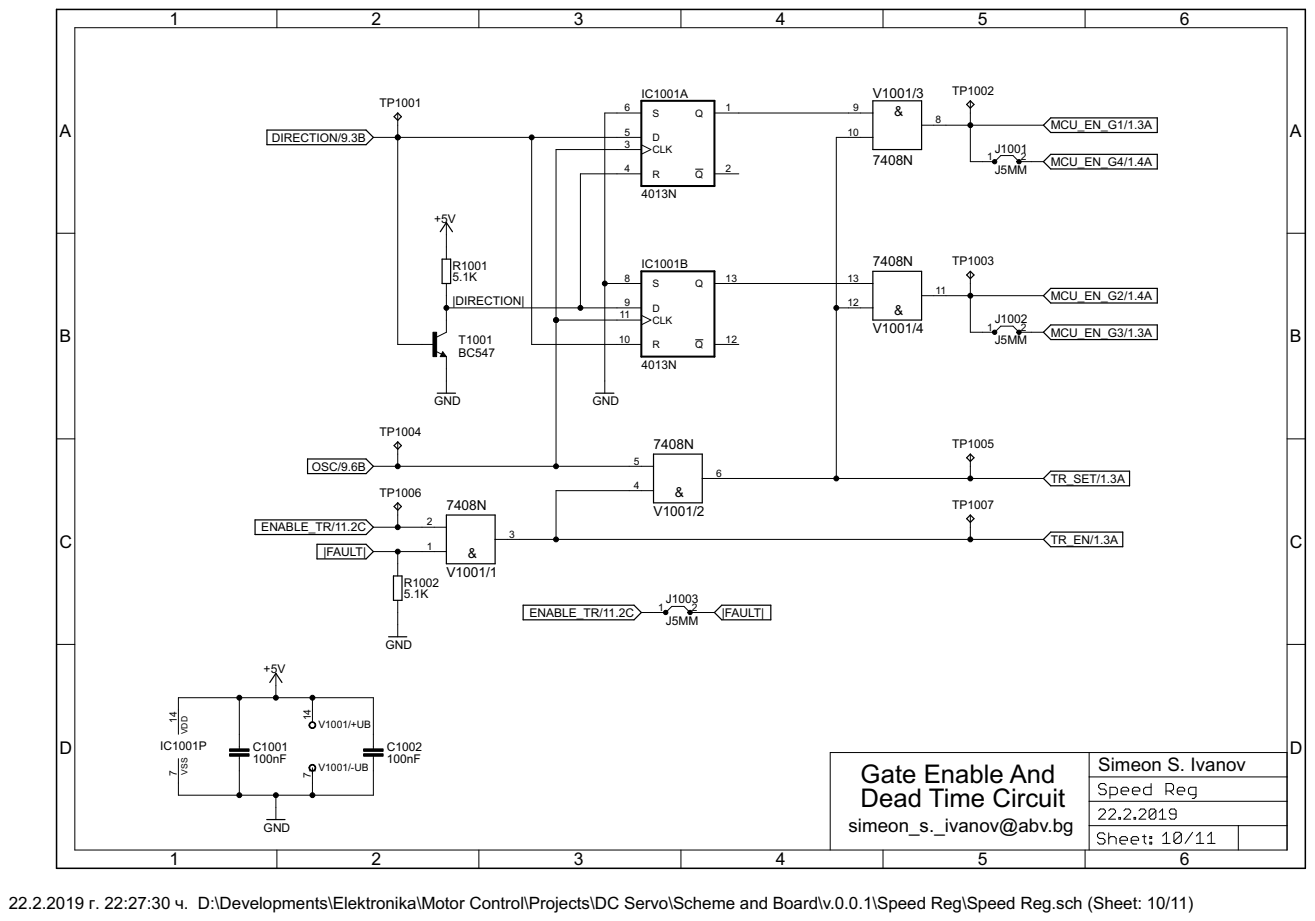
[picture p38: page 10]

22.2.2019 г. 22:27:30 ч. D:\Developments\Elektronika\Motor Control\Projects\DC Servo\Scheme and Board\v.0.0.1\Speed Reg\Speed Reg.sch (Sheet: 10/11)

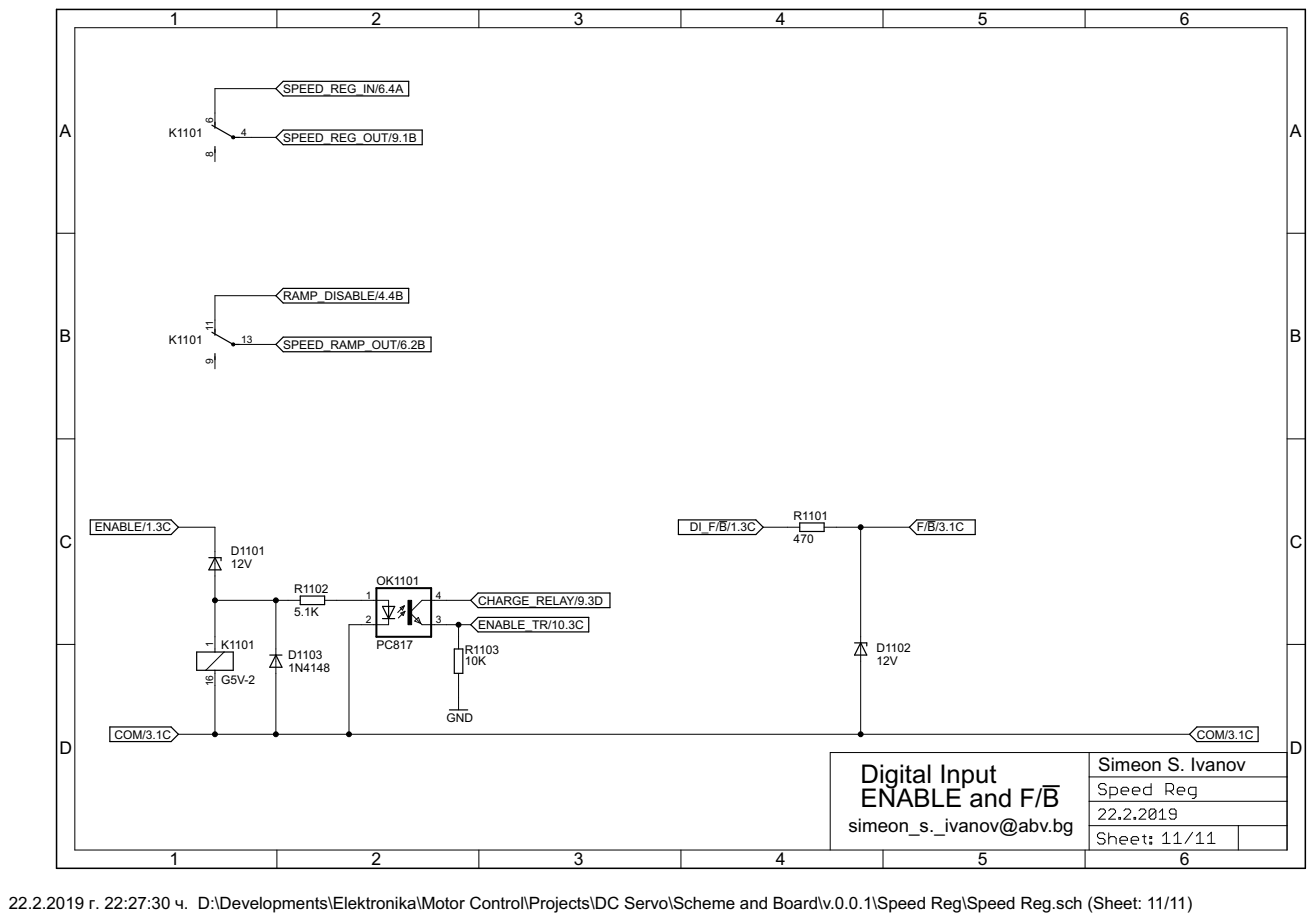
[picture p39: page 11]

Simeon S. Ivanov Digital Input
ENABLE and F/B
simeon_s._ivanov@abv.bg

22.2.2019 г. 22:27:30 ч. D:\Developments\Elektronika\Motor Control\Projects\DC Servo\Scheme and Board\v.0.0.1\Speed Reg\Speed Reg.sch (Sheet: 11/11)
