SimeonSimeonovIvanov/DC-Servo/Scheme and Board/v.0.0.1/Power Stage/Power Stage.pdf

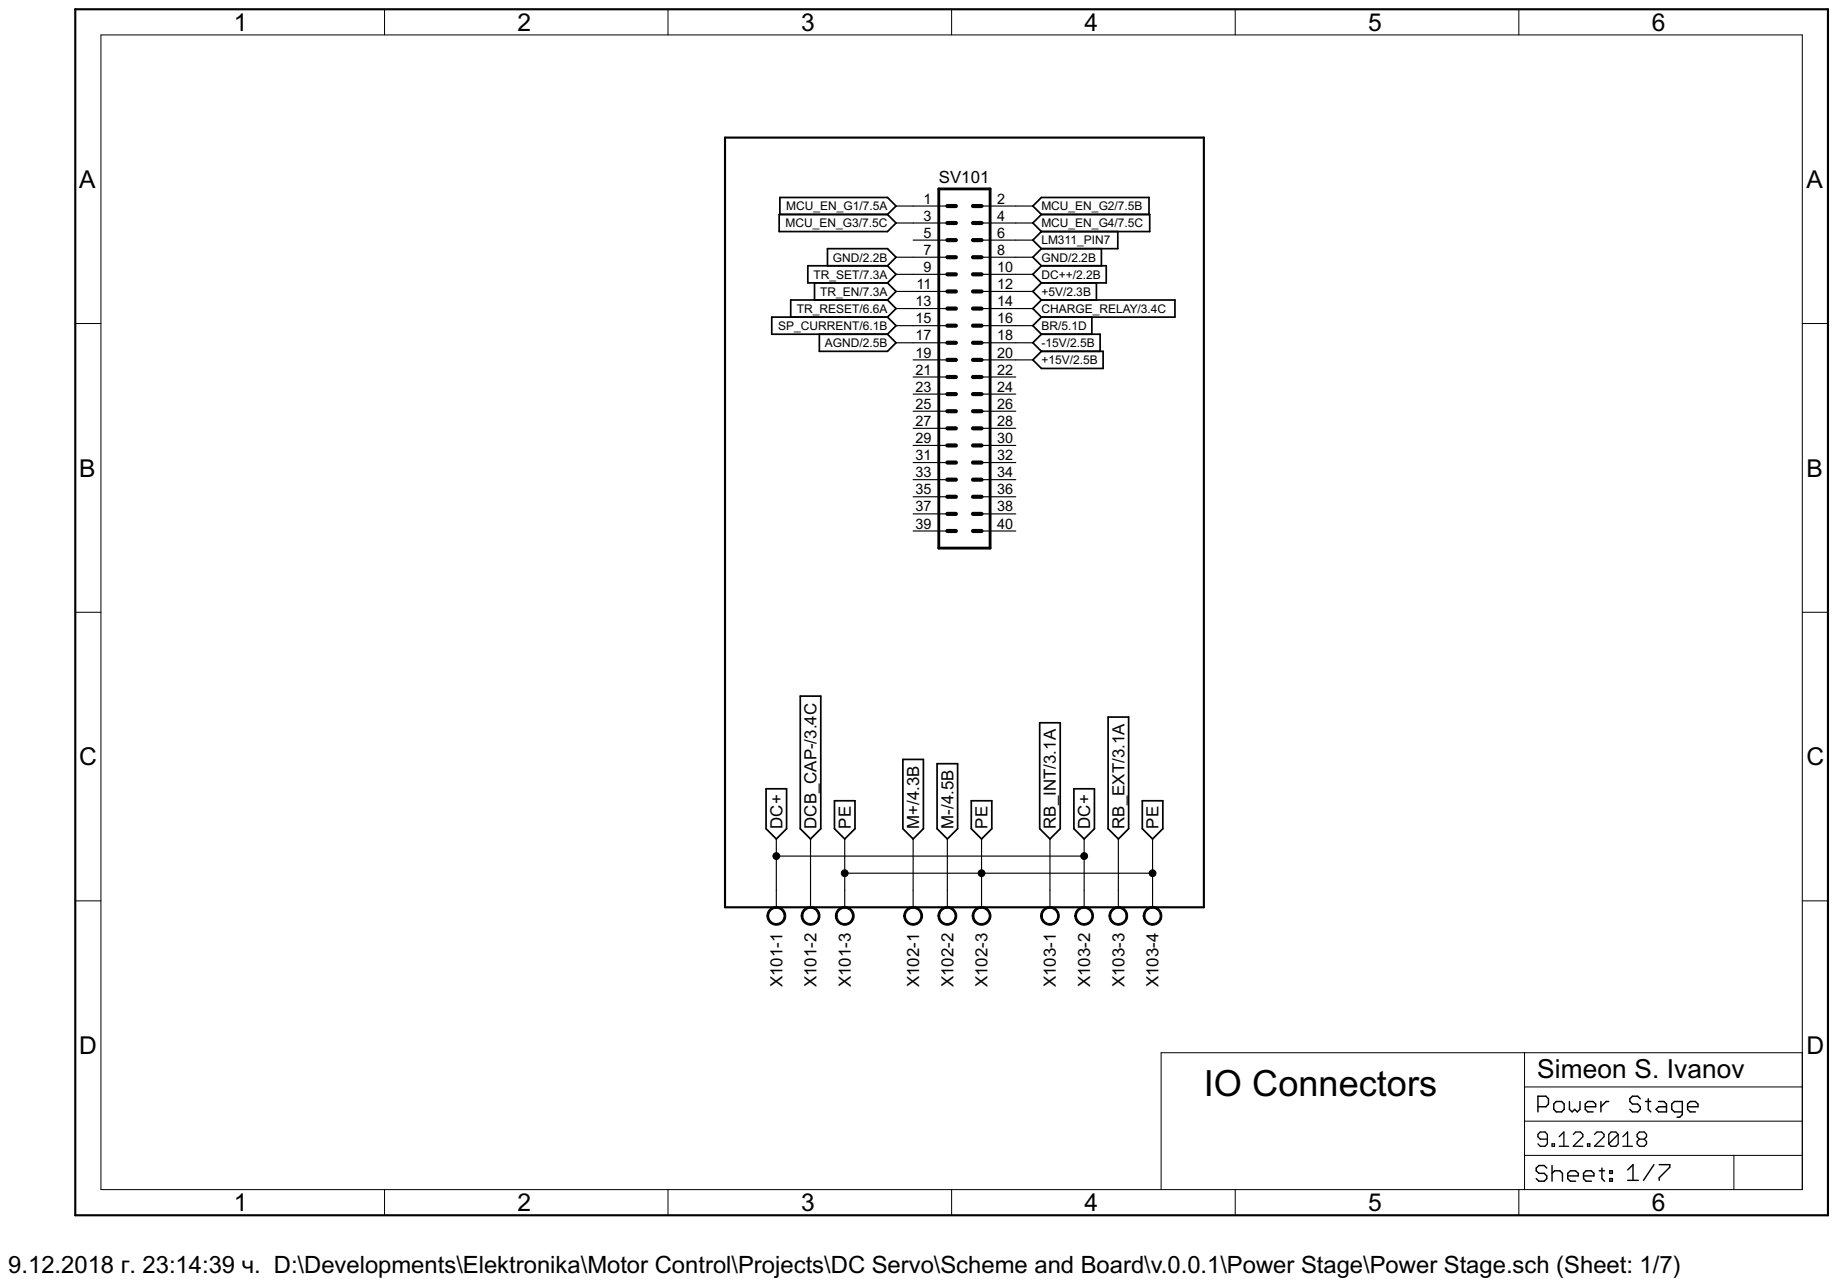
[picture p40: page 1]

9.12.2018 г. 23:14:39 ч. D:\Developments\Elektronika\Motor Control\Projects\DC Servo\Scheme and Board\v.0.0.1\Power Stage\Power Stage.sch (Sheet: 1/7)

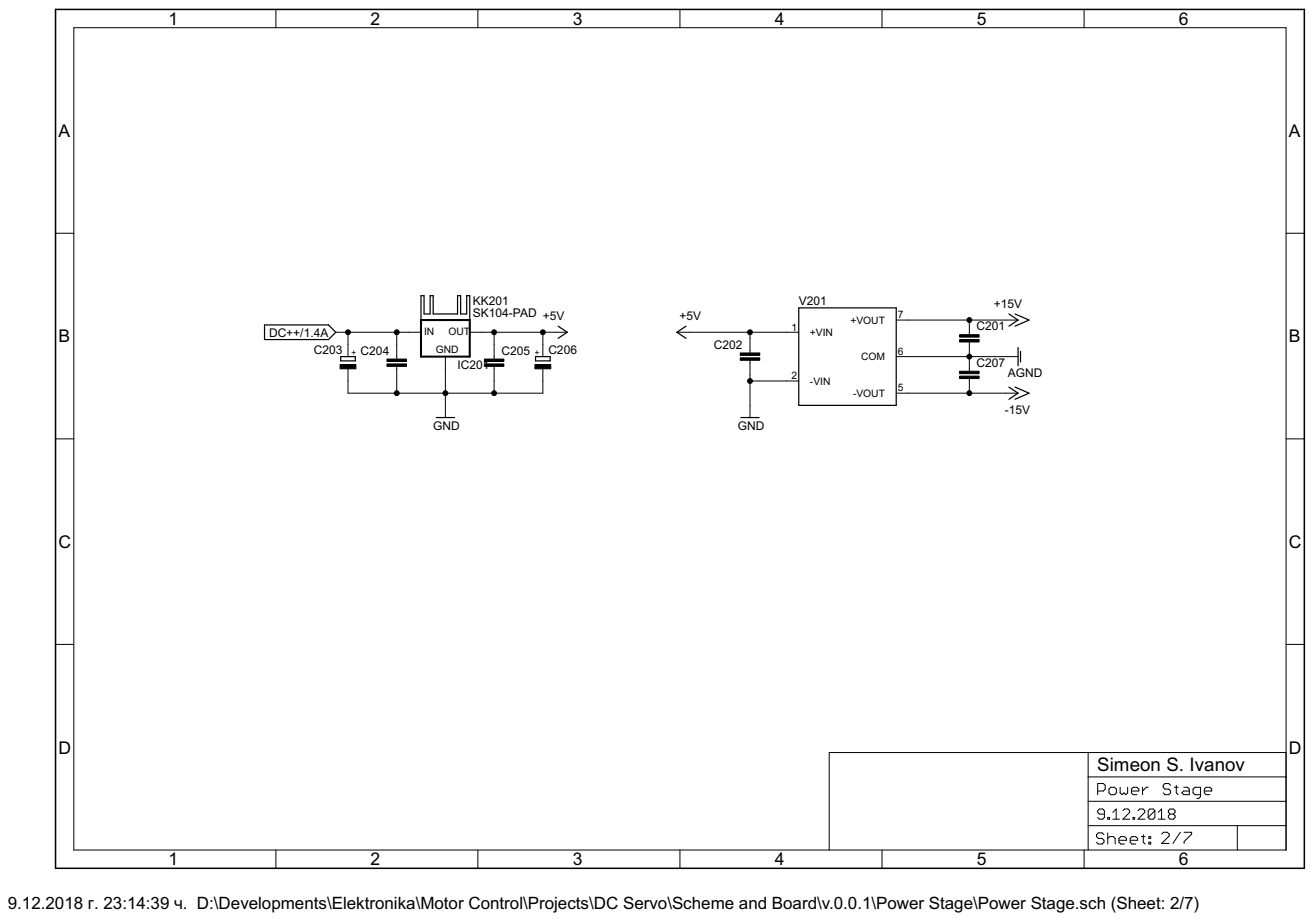
[picture p41: page 2]

9.12.2018 г. 23:14:39 ч. D:\Developments\Elektronika\Motor Control\Projects\DC Servo\Scheme and Board\v.0.0.1\Power Stage\Power Stage.sch (Sheet: 2/7)

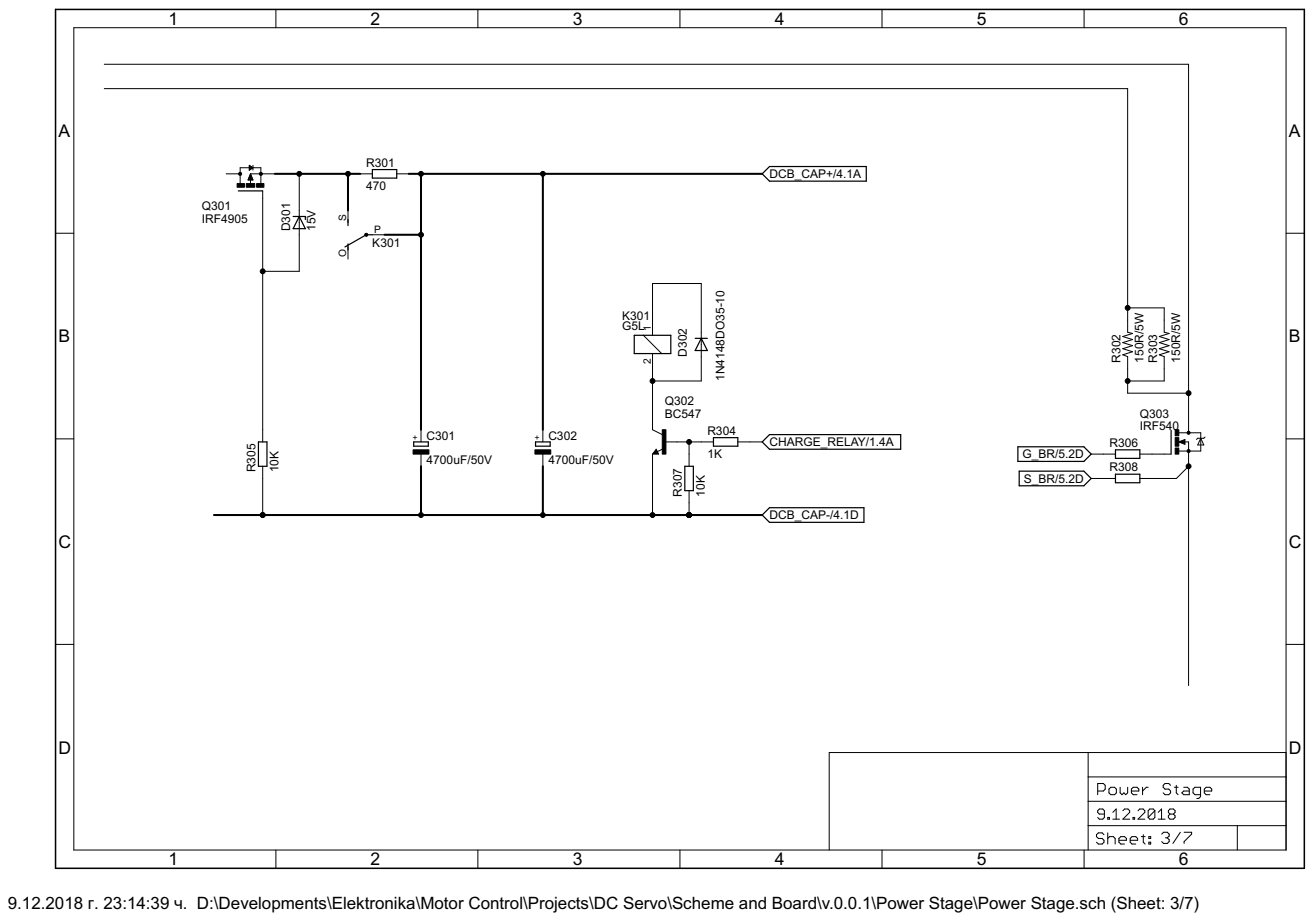
[picture p42: page 3]

9.12.2018 г. 23:14:39 ч. D:\Developments\Elektronika\Motor Control\Projects\DC Servo\Scheme and Board\v.0.0.1\Power Stage\Power Stage.sch (Sheet: 3/7)

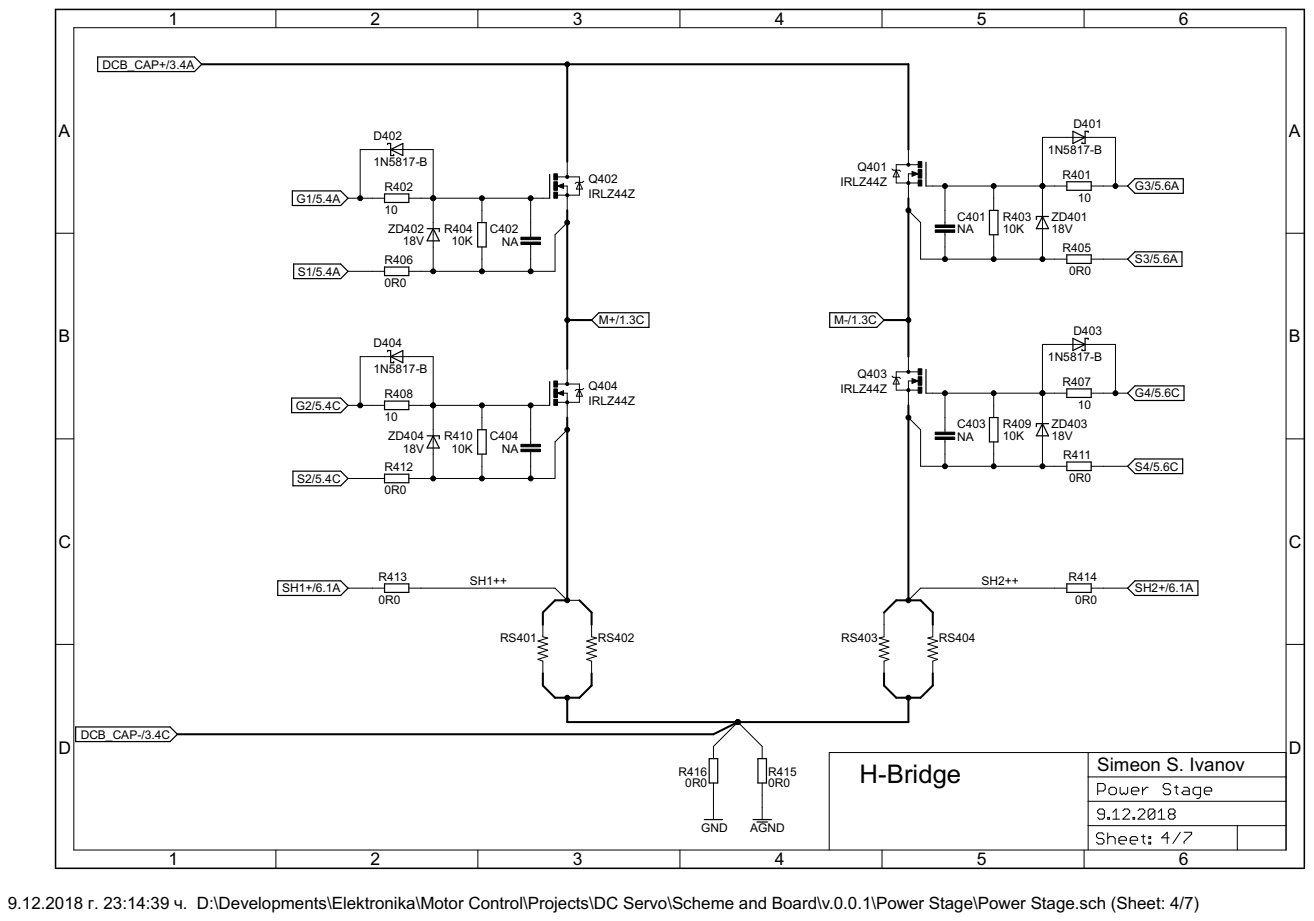
[picture p43: page 4]

9.12.2018 г. 23:14:39 ч. D:\Developments\Elektronika\Motor Control\Projects\DC Servo\Scheme and Board\v.0.0.1\Power Stage\Power Stage.sch (Sheet: 4/7)

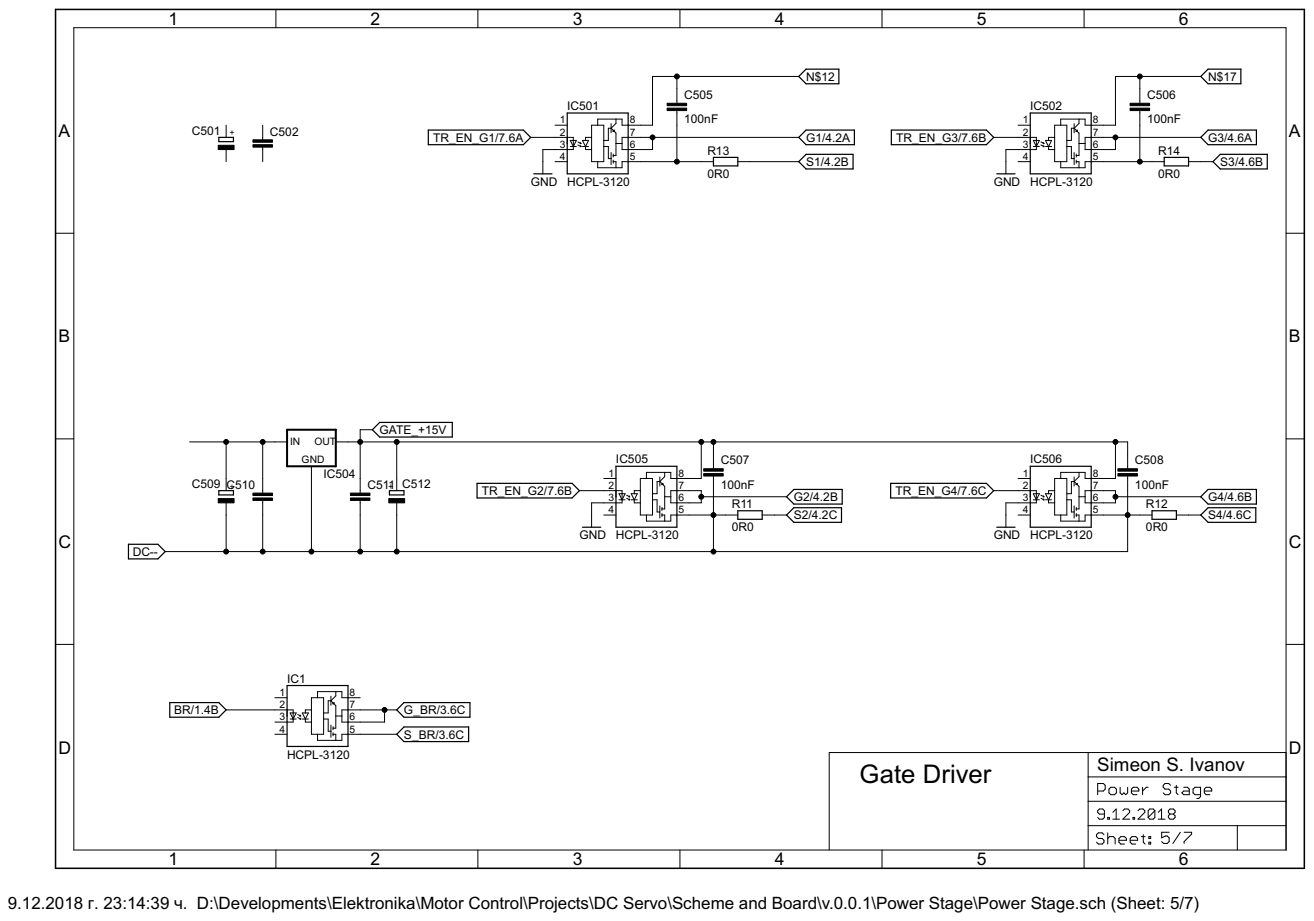
[picture p44: page 5]

9.12.2018 г. 23:14:39 ч. D:\Developments\Elektronika\Motor Control\Projects\DC Servo\Scheme and Board\v.0.0.1\Power Stage\Power Stage.sch (Sheet: 5/7)

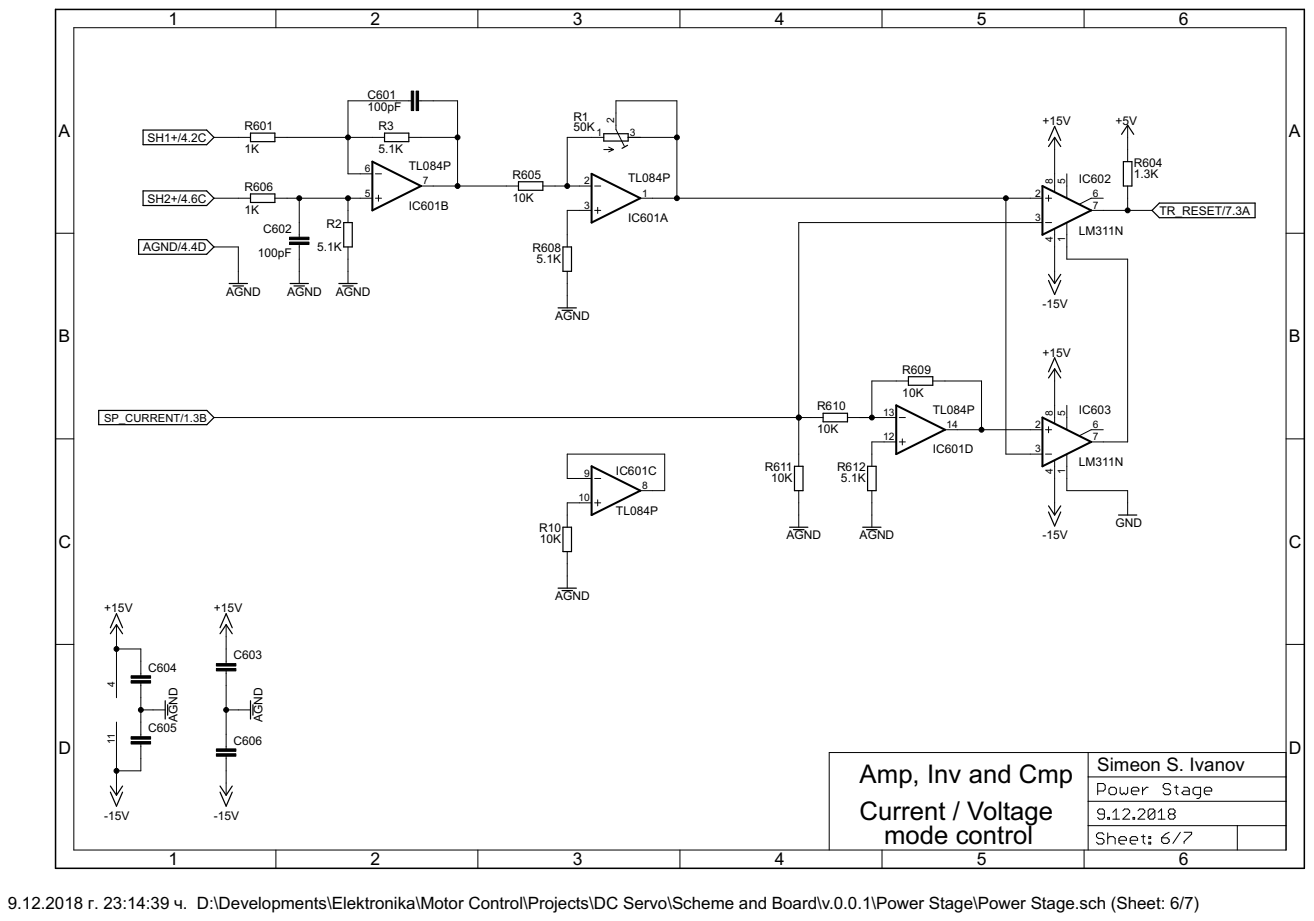
[picture p45: page 6]

Amp, Inv and Cmp
Current / Voltage
mode control

9.12.2018 г. 23:14:39 ч. D:\Developments\Elektronika\Motor Control\Projects\DC Servo\Scheme and Board\v.0.0.1\Power Stage\Power Stage.sch (Sheet: 6/7)

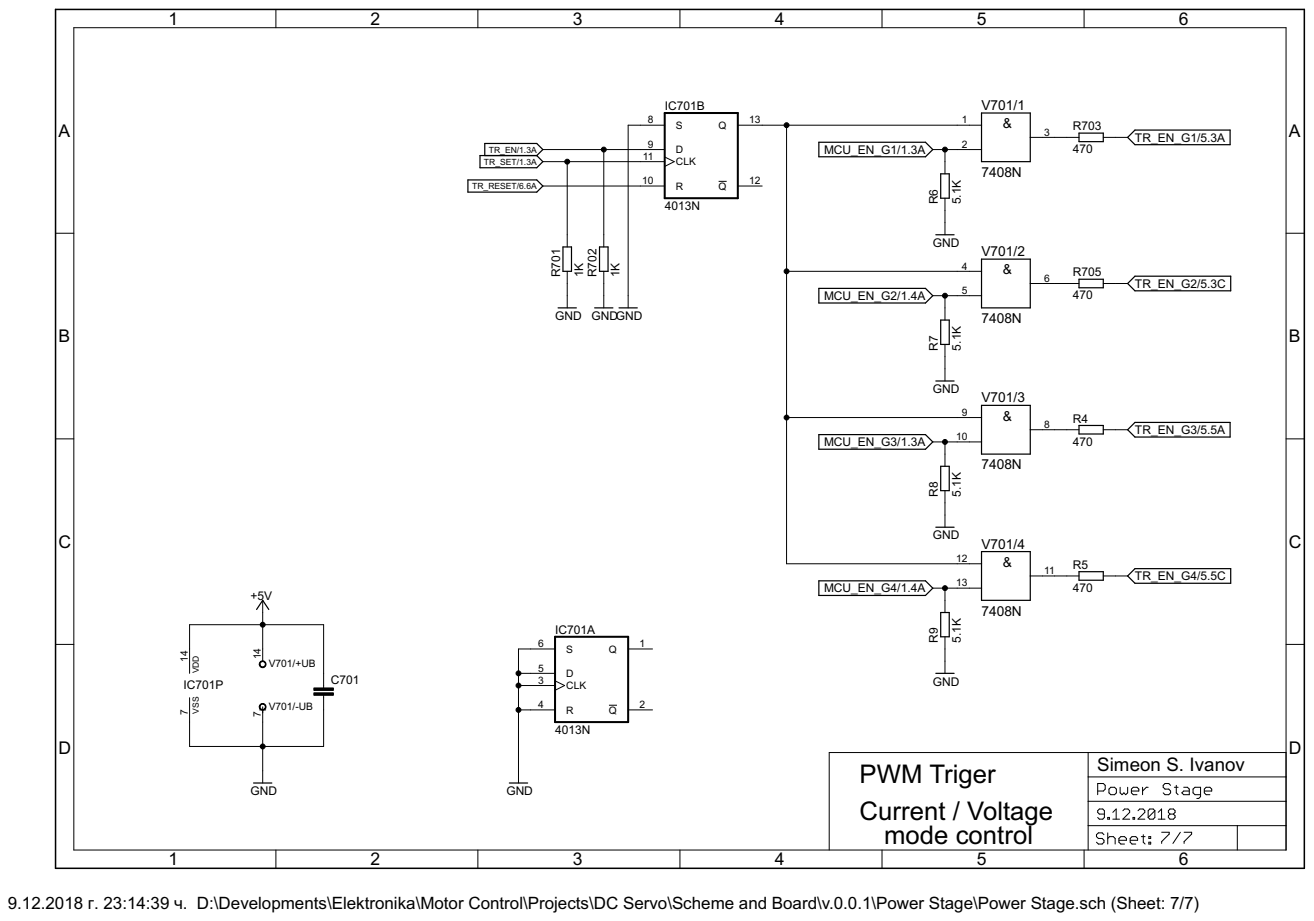
[picture p46: page 7]

9.12.2018 г. 23:14:39 ч. D:\Developments\Elektronika\Motor Control\Projects\DC Servo\Scheme and Board\v.0.0.1\Power Stage\Power Stage.sch (Sheet: 7/7)
