SimeonSimeonovIvanov/DC-Servo/Scheme and Board/v.0.0.1/Speed Reg/Speed Reg (All Side).pdf

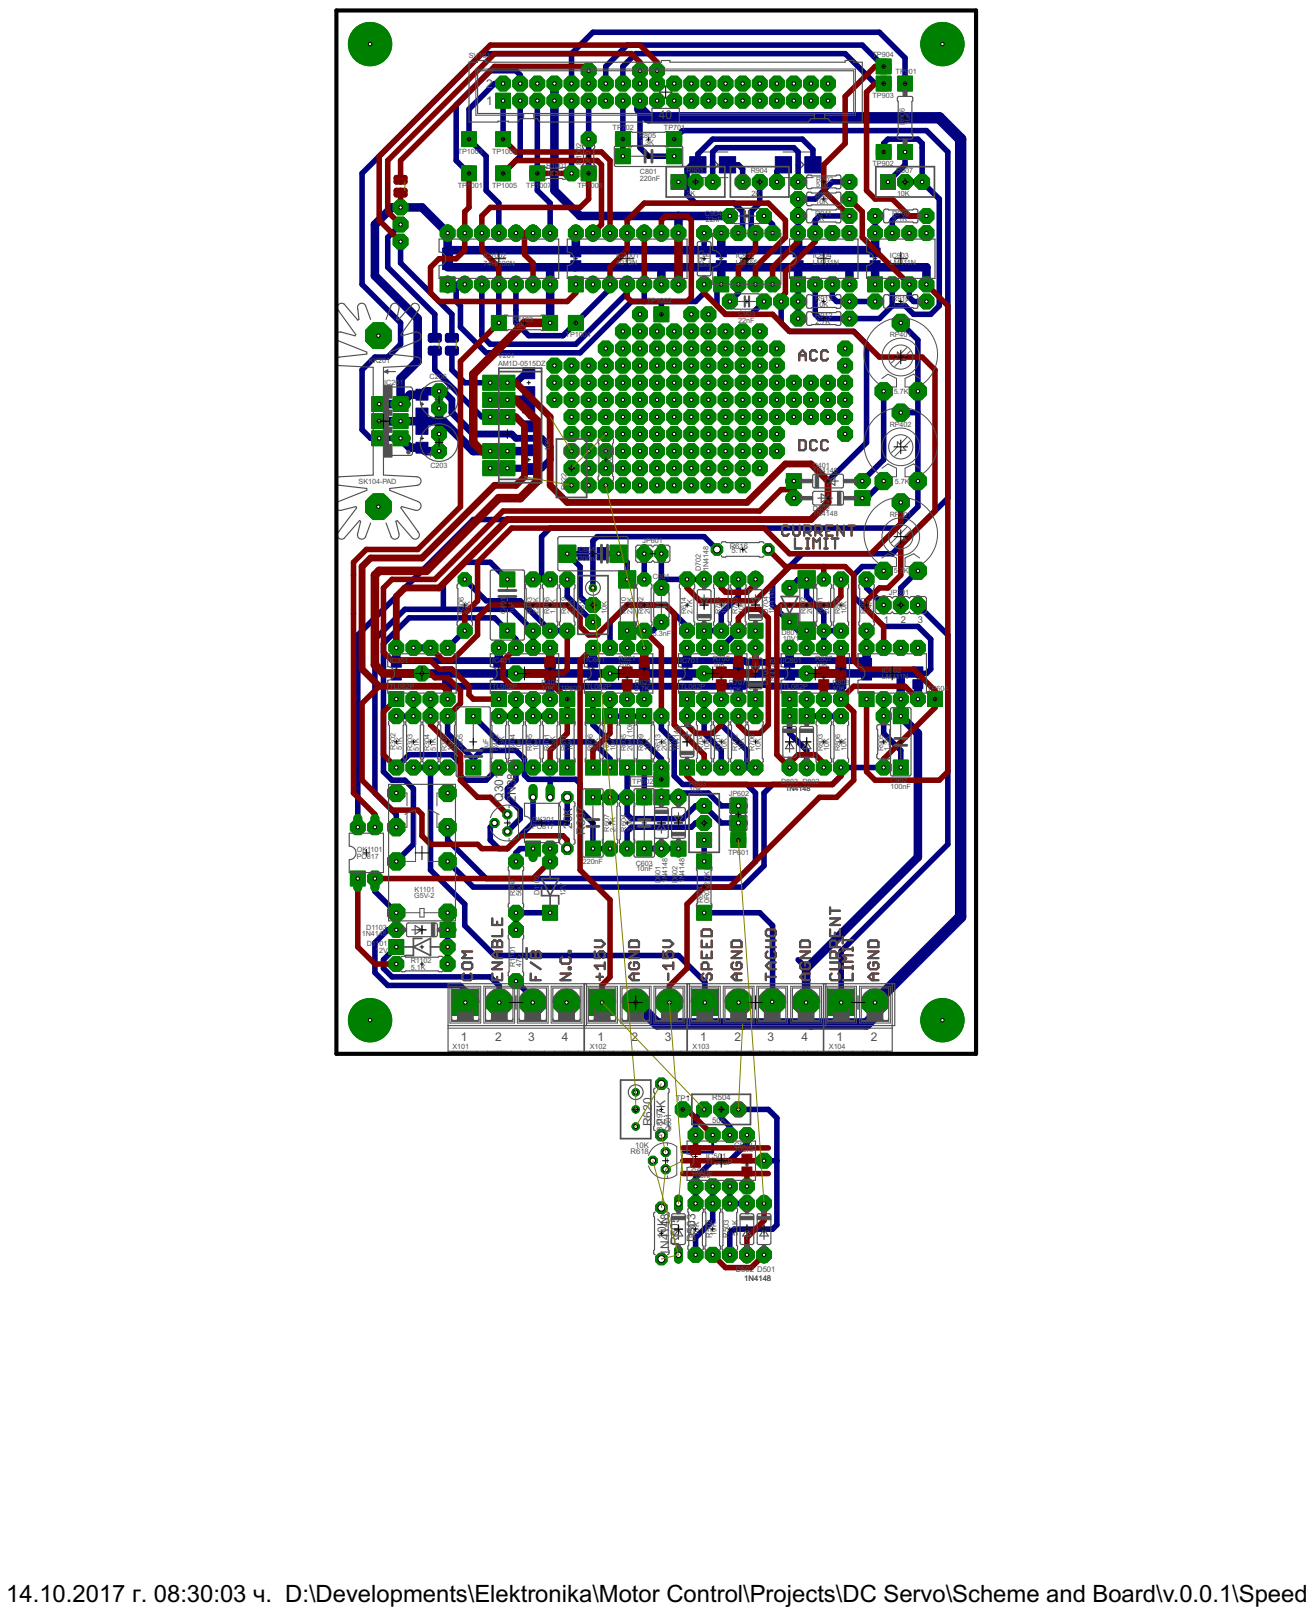
[picture p47: page 1]

14.10.2017 г. 08:30:03 ч. D:\Developments\Elektronika\Motor Control\Projects\DC Servo\Scheme and Board\v.0.0.1\Speed Reg\Speed Reg.brd
