SimeonSimeonovIvanov/DC-Servo/Scheme and Board/v.0.0.1/Power Stage/Power Stage (All Side).pdf

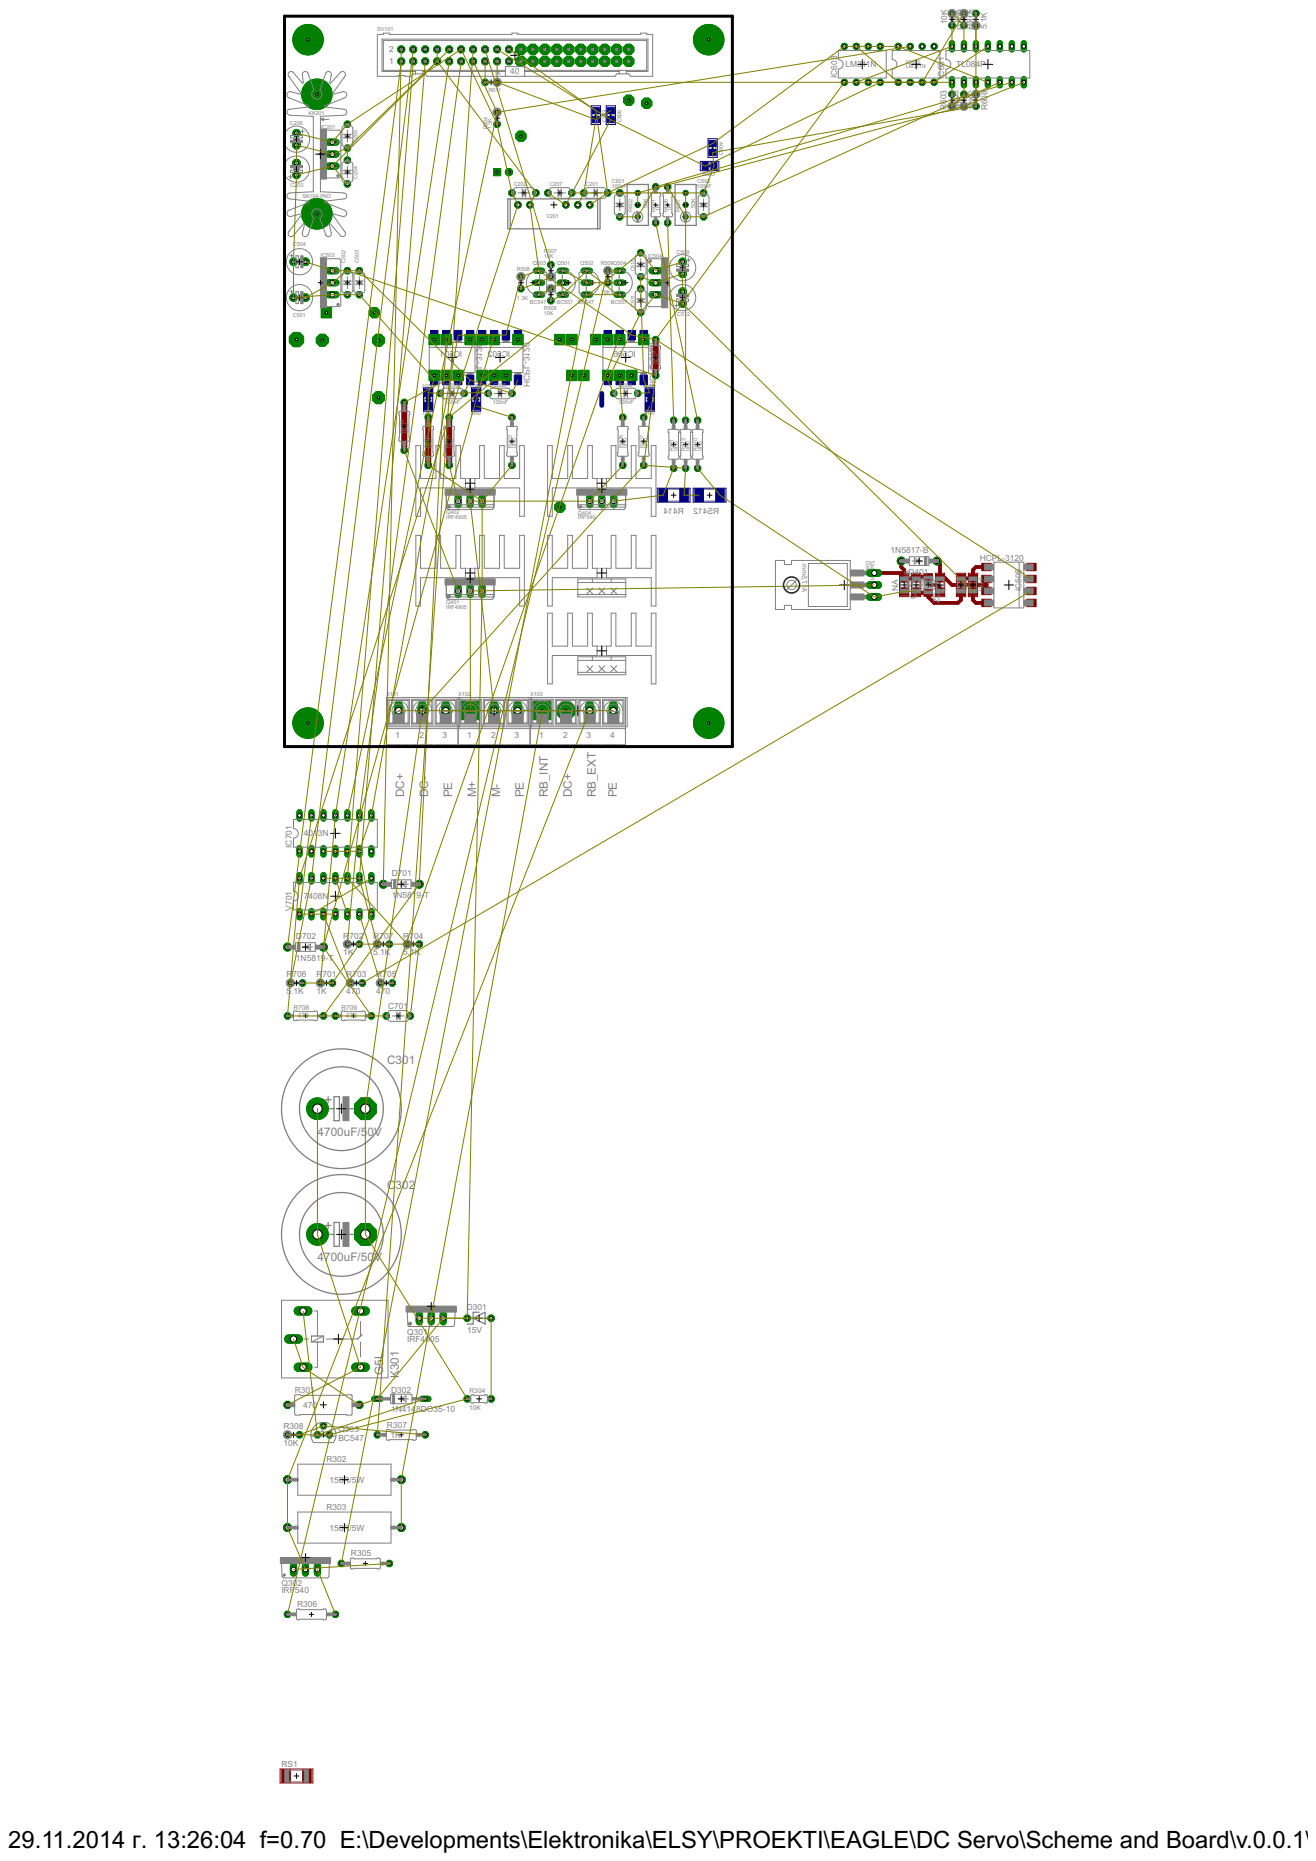
[picture p48: page 1]

29.11.2014 г. 13:26:04 f=0.70 E:\Developments\Elektronika\ELSY\PROEKTI\EAGLE\DC Servo\Scheme and Board\v.0.0.1\Power Stage\Power Stage.brd
