SimeonSimeonovIvanov/DC-Servo/Scheme and Board/v.0.0.1/Power Stage/Power Stage (Bottom Side).pdf

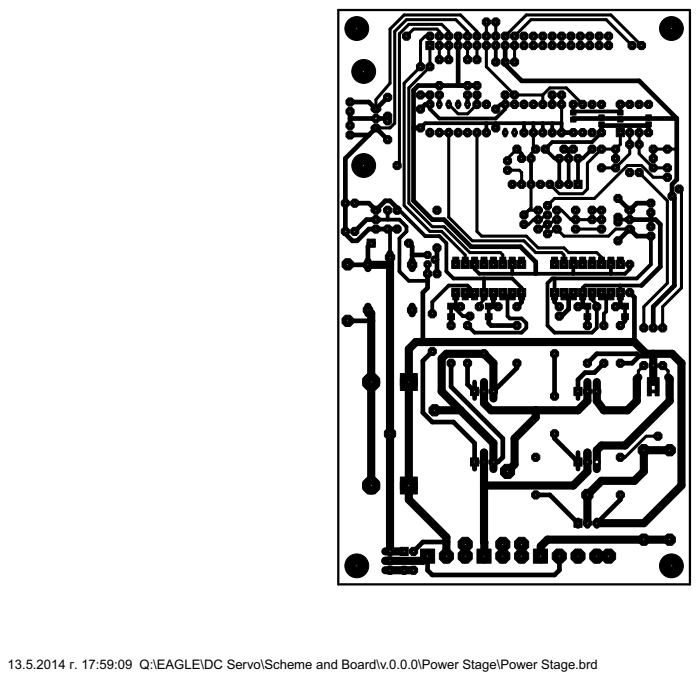
[picture p49: page 1]

13.5.2014 г. 17:59:09 Q:\EAGLE\DC Servo\Scheme and Board\v.0.0.0\Power Stage\Power Stage.brd
