SimeonSimeonovIvanov/DC-Servo/Scheme and Board/v.0.0.1/Power Stage/Power Stage (Top Side - Mirror).pdf

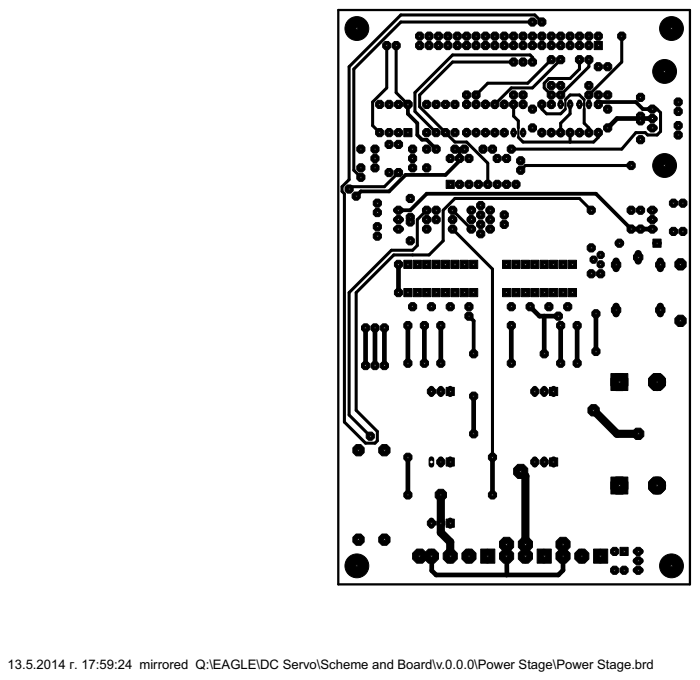
[picture p50: page 1]

13.5.2014 г. 17:59:24 mirrored Q:\EAGLE\DC Servo\Scheme and Board\v.0.0.0\Power Stage\Power Stage.brd
