SimeonSimeonovIvanov/DC-Servo/Scheme and Board/v.0.0.1/Speed Reg/Speed Reg (Bottom Place - Mirror).pdf

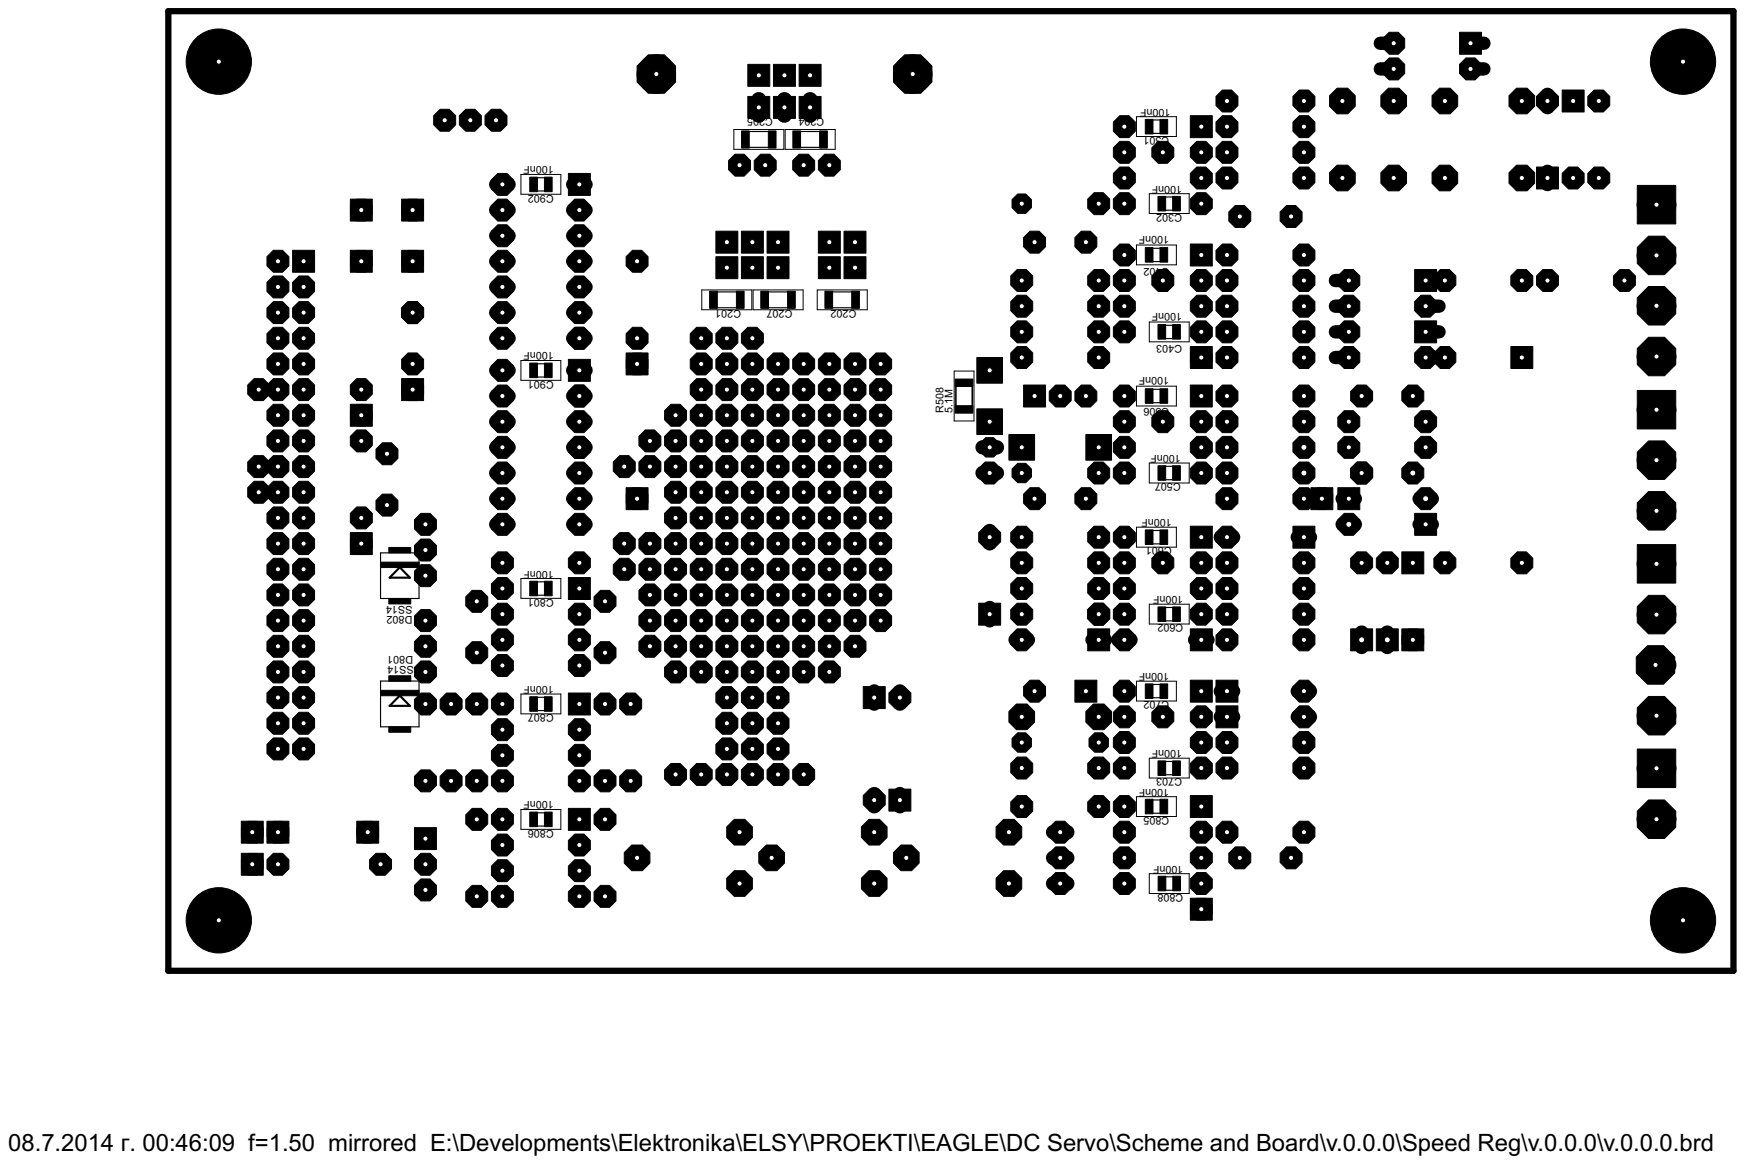
[picture p51: page 1]

08.7.2014 г. 00:46:09 f=1.50 mirrored E:\Developments\Elektronika\ELSY\PROEKTI\EAGLE\DC Servo\Scheme and Board\v.0.0.0\Speed Reg\v.0.0.0\v.0.0.0.brd
