SimeonSimeonovIvanov/DC-Servo/Scheme and Board/v.0.0.1/Speed Reg/Speed Reg (Top Place).pdf

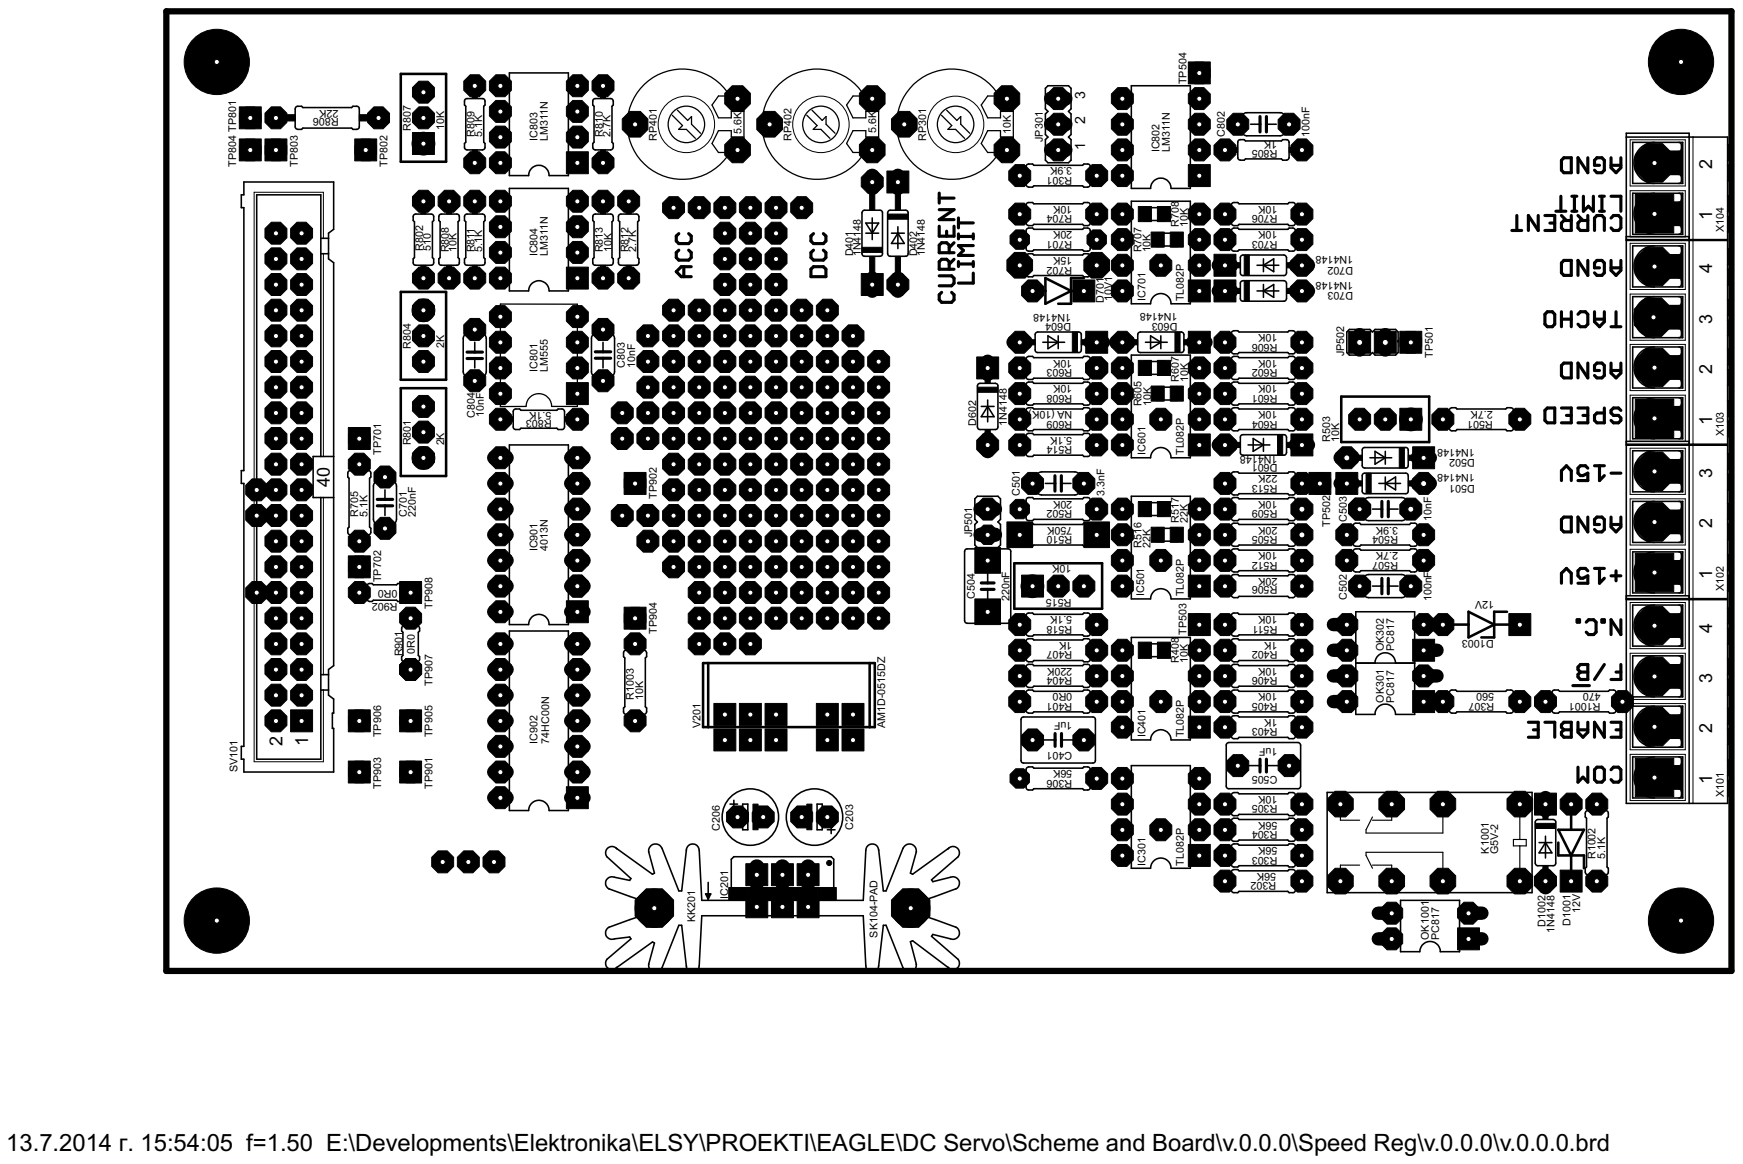
[picture p52: page 1]

13.7.2014 г. 15:54:05 f=1.50 E:\Developments\Elektronika\ELSY\PROEKTI\EAGLE\DC Servo\Scheme and Board\v.0.0.0\Speed Reg\v.0.0.0\v.0.0.0.brd
