SimeonSimeonovIvanov/DC-Servo/Scheme and Board/Work/ENCODER/AS5047D/main (All Side).pdf

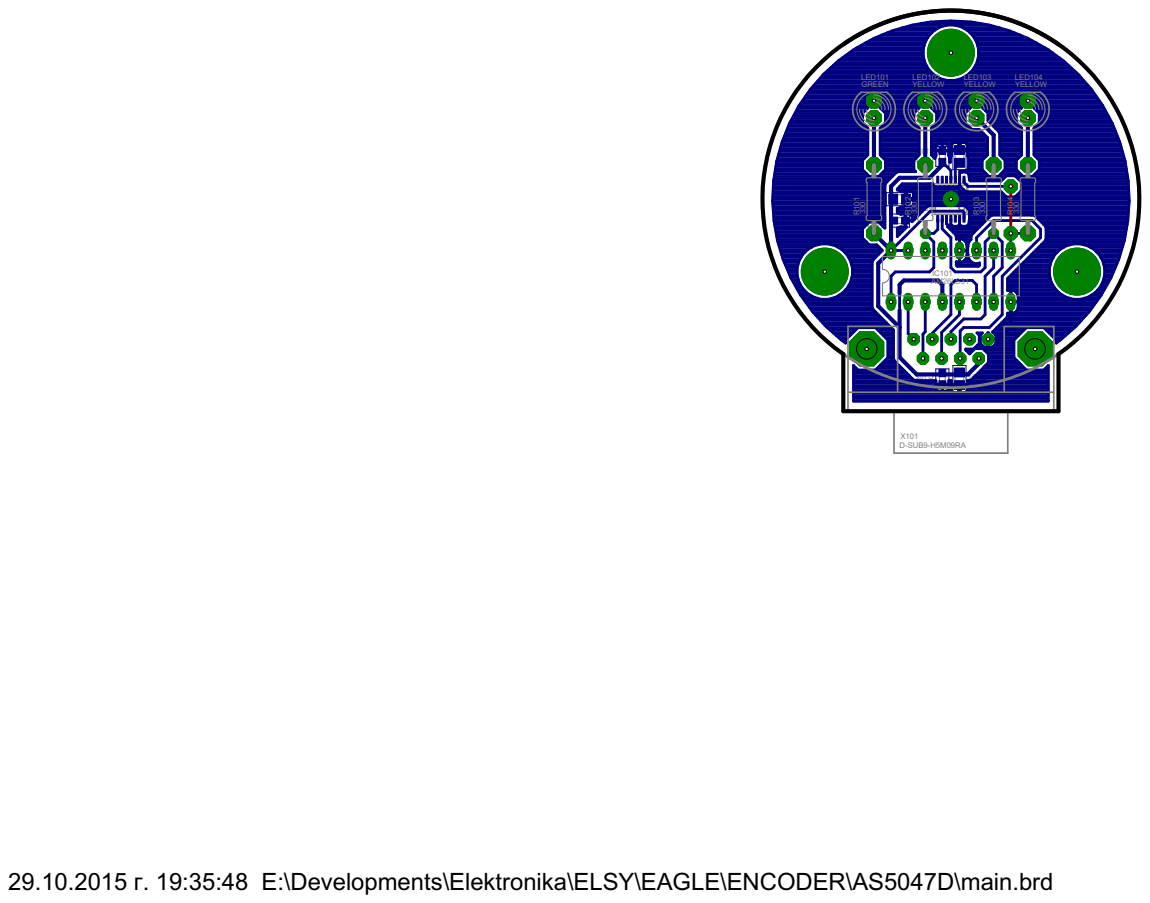
[picture p53: page 1]

29.10.2015 г. 19:35:48 E:\Developments\Elektronika\ELSY\EAGLE\ENCODER\AS5047D\main.brd
