SimeonSimeonovIvanov/DC-Servo/Scheme and Board/Work/ENCODER/AS5047D/main (Bottom Side).pdf

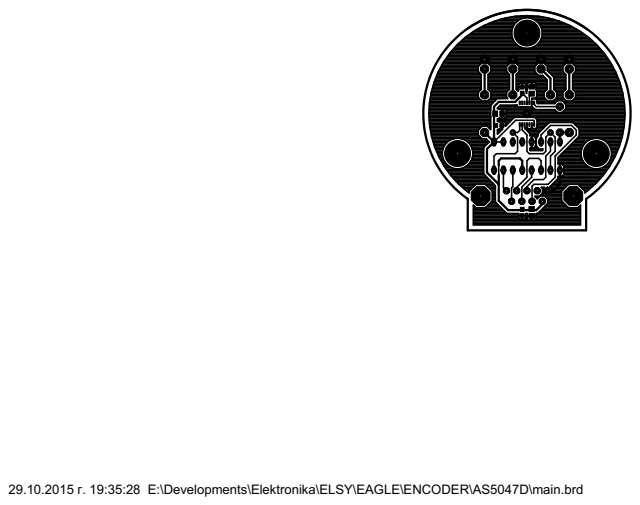
[picture p54: page 1]

29.10.2015 г. 19:35:28 E:\Developments\Elektronika\ELSY\EAGLE\ENCODER\AS5047D\main.brd
