SimeonSimeonovIvanov/DC-Servo/Scheme and Board/Work/ENCODER/AS5047D/main.pdf

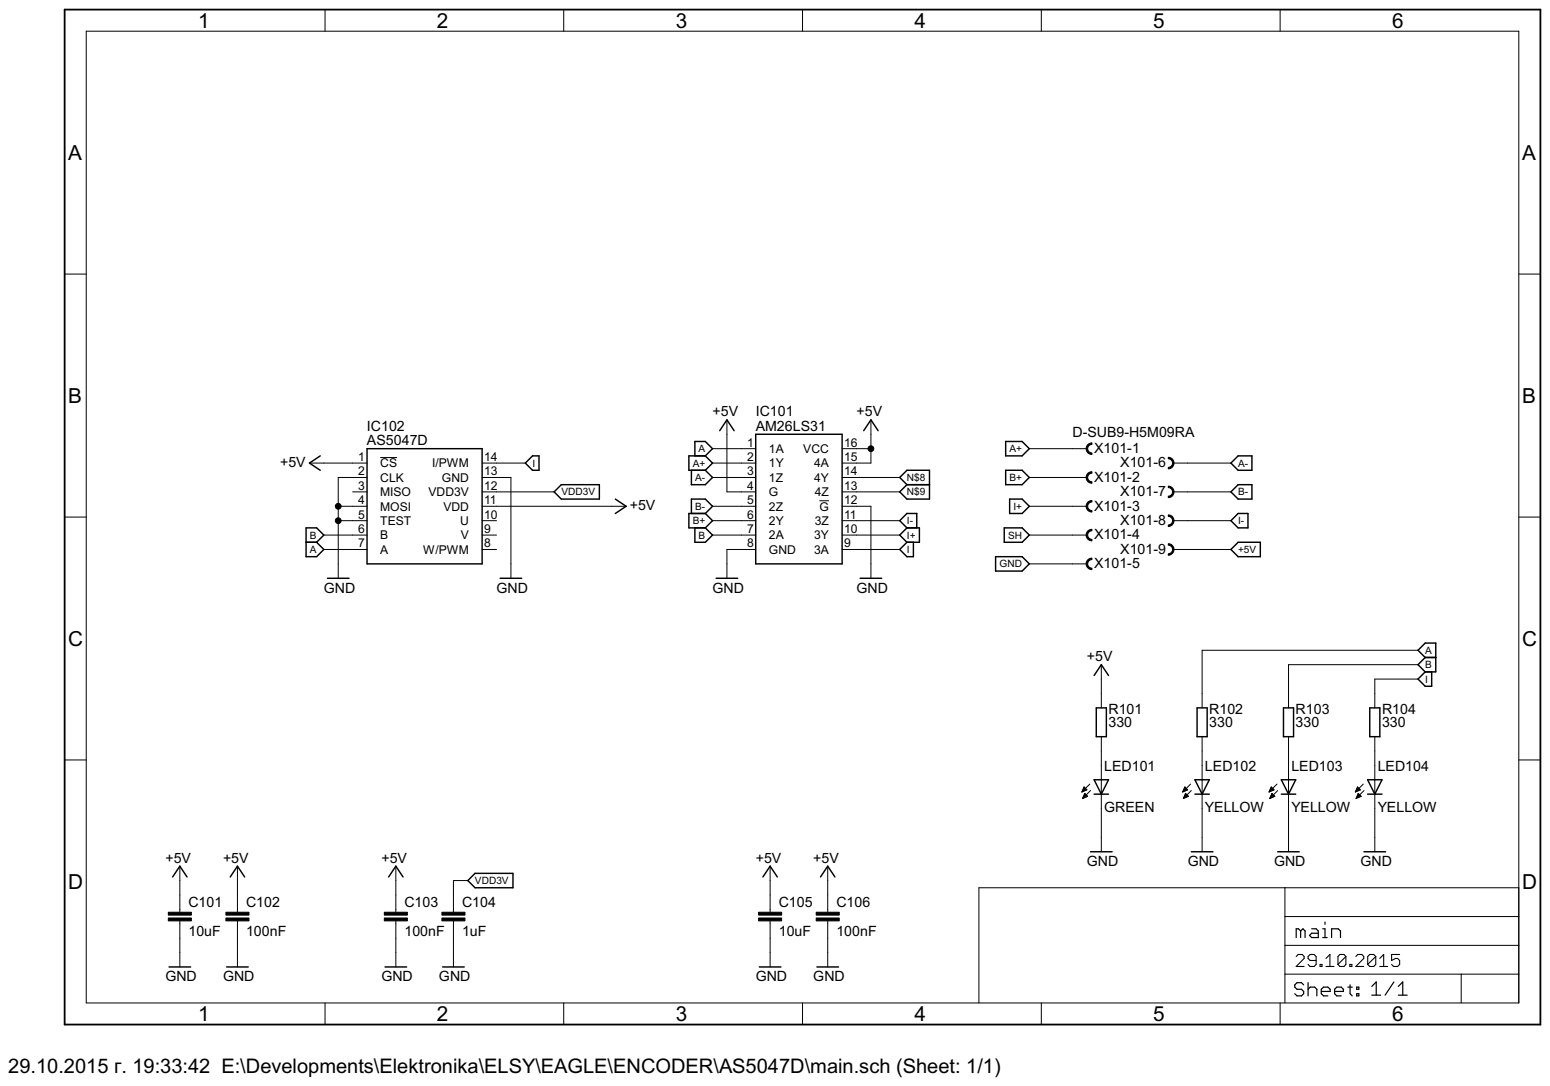
[picture p55: page 1]

29.10.2015 г. 19:33:42 E:\Developments\Elektronika\ELSY\EAGLE\ENCODER\AS5047D\main.sch (Sheet: 1/1)
