SimeonSimeonovIvanov/DC-Servo/Scheme and Board/Work/MOSFET Driver/v.0.0.1/main (All Side).pdf

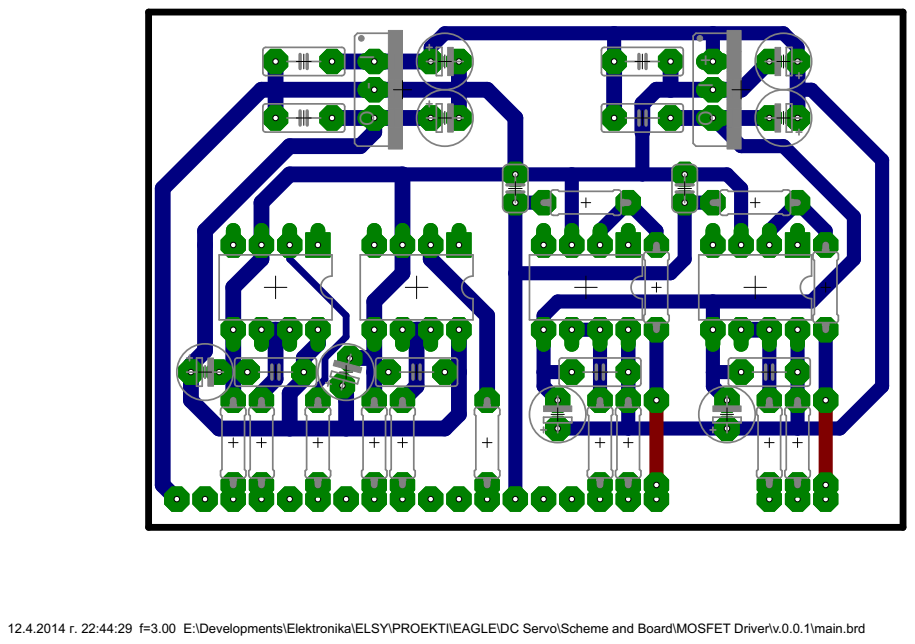
[picture p56: page 1]

12.4.2014 г. 22:44:29 f=3.00 E:\Developments\Elektronika\ELSY\PROEKTI\EAGLE\DC Servo\Scheme and Board\MOSFET Driver\v.0.0.1\main.brd
