SimeonSimeonovIvanov/DC-Servo/Scheme and Board/Work/MOSFET Driver/v.0.0.1/main.pdf

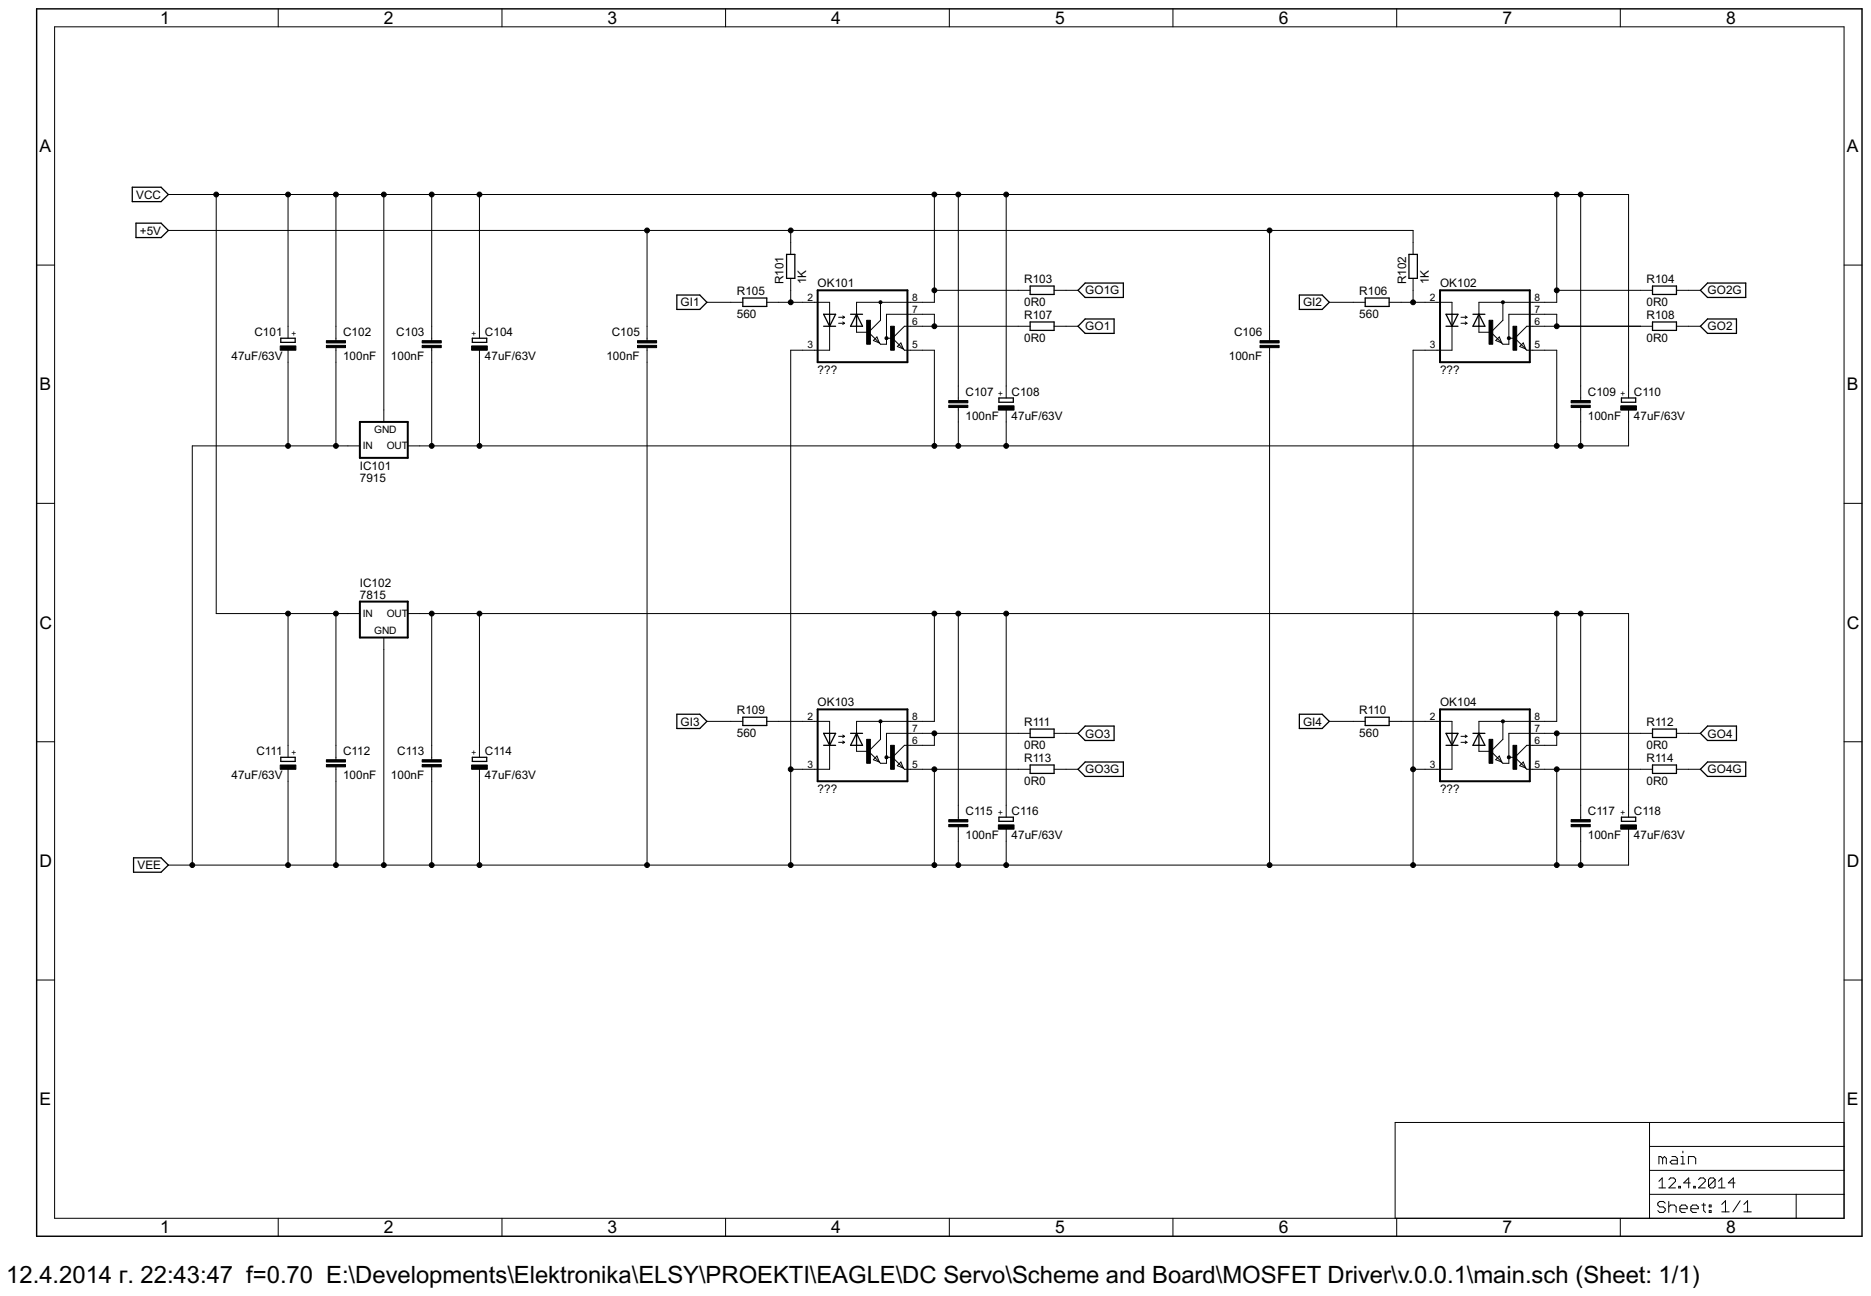
[picture p57: page 1]

12.4.2014 г. 22:43:47 f=0.70 E:\Developments\Elektronika\ELSY\PROEKTI\EAGLE\DC Servo\Scheme and Board\MOSFET Driver\v.0.0.1\main.sch (Sheet: 1/1)
