SimeonSimeonovIvanov/DC-Servo/Scheme and Board/Work/ENCODER/UP And DOWN Counter Signals/v.0.0.1/main (All Side).pdf

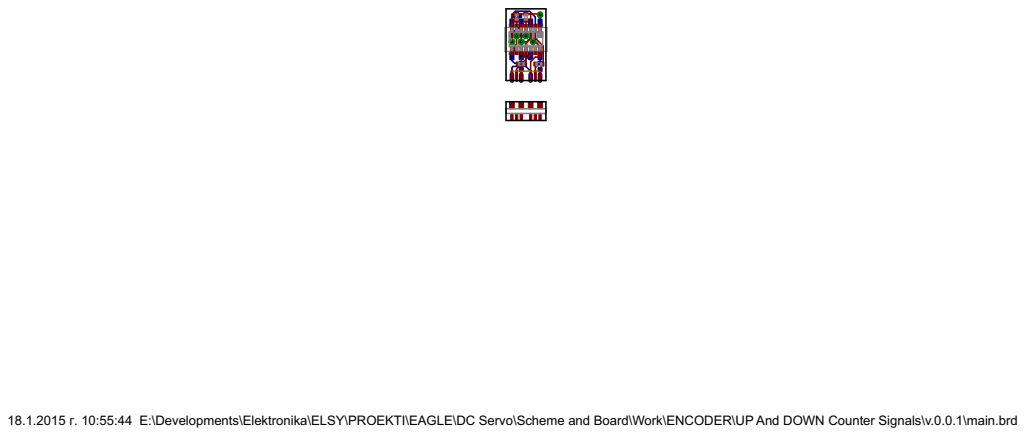
[picture p58: page 1]

18.1.2015 г. 10:55:44 E:\Developments\Elektronika\ELSY\PROEKTI\EAGLE\DC Servo\Scheme and Board\Work\ENCODER\UP And DOWN Counter Signals\v.0.0.1\main.brd
