SimeonSimeonovIvanov/DC-Servo/Scheme and Board/Work/ENCODER/UP And DOWN Counter Signals/v.0.0.1/main.pdf

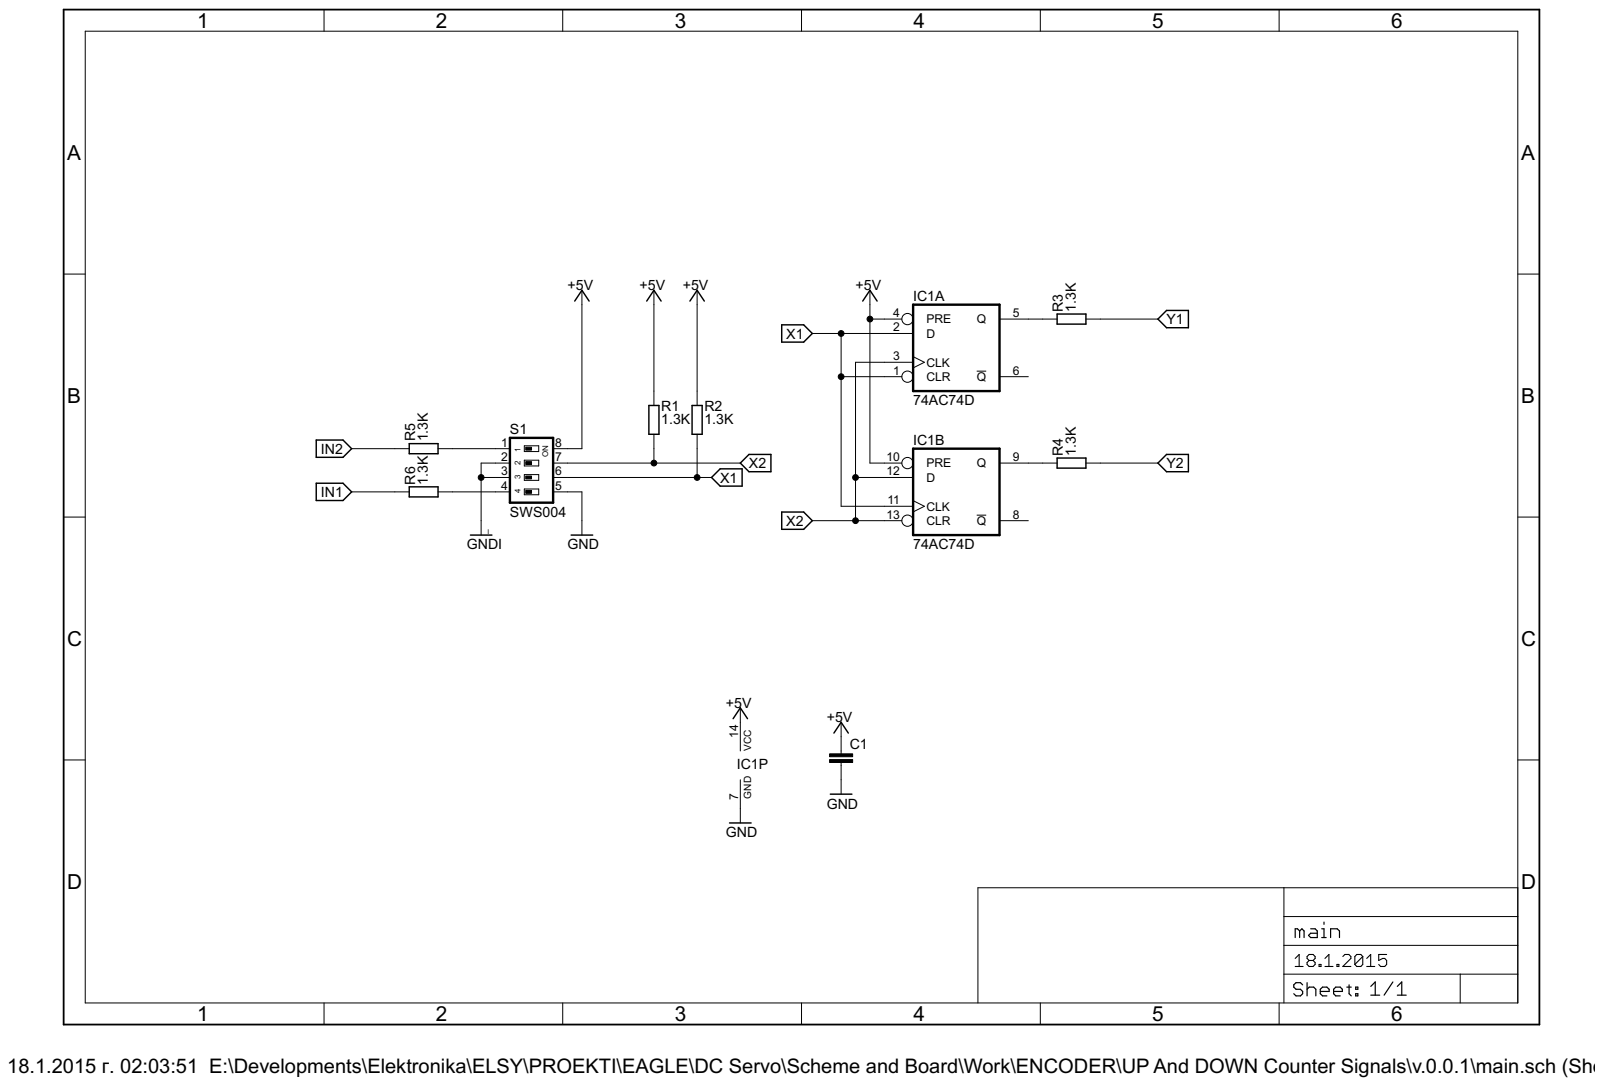
[picture p59: page 1]

18.1.2015 г. 02:03:51 E:\Developments\Elektronika\ELSY\PROEKTI\EAGLE\DC Servo\Scheme and Board\Work\ENCODER\UP And DOWN Counter Signals\v.0.0.1\main.sch (Sheet: 1/1)
