SimeonSimeonovIvanov/DC-Servo/Work/Simulation/Current Limit.pdf

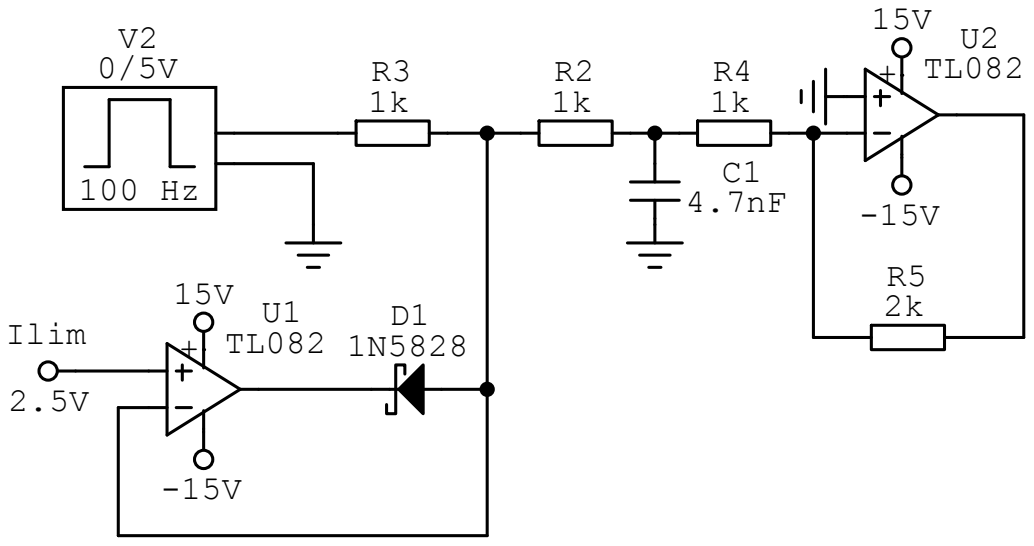
[picture p60: page 1]
