SimeonSimeonovIvanov/DC-Servo/Work/Simulation/Level Limiter (KEMTOR).pdf

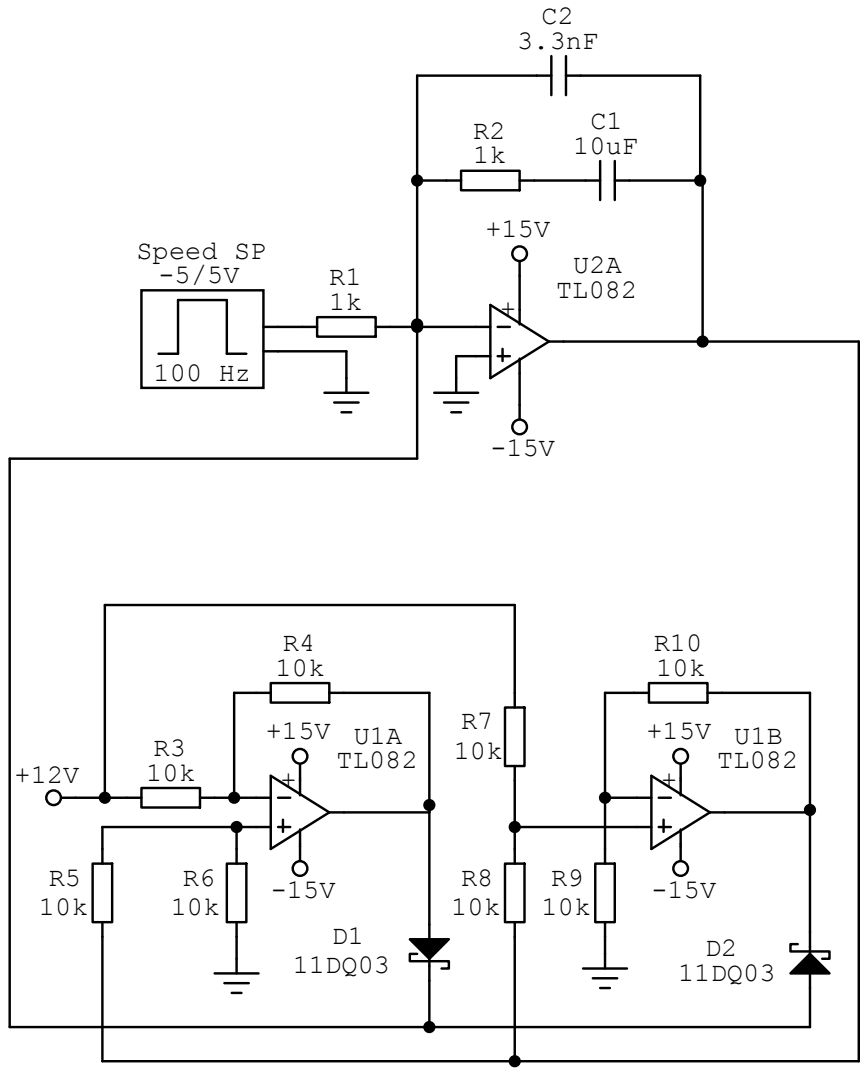
[picture p61: page 1]
