SimeonSimeonovIvanov/DC-Servo/Work/Simulation/CURRENT PWM/Simulation.pdf

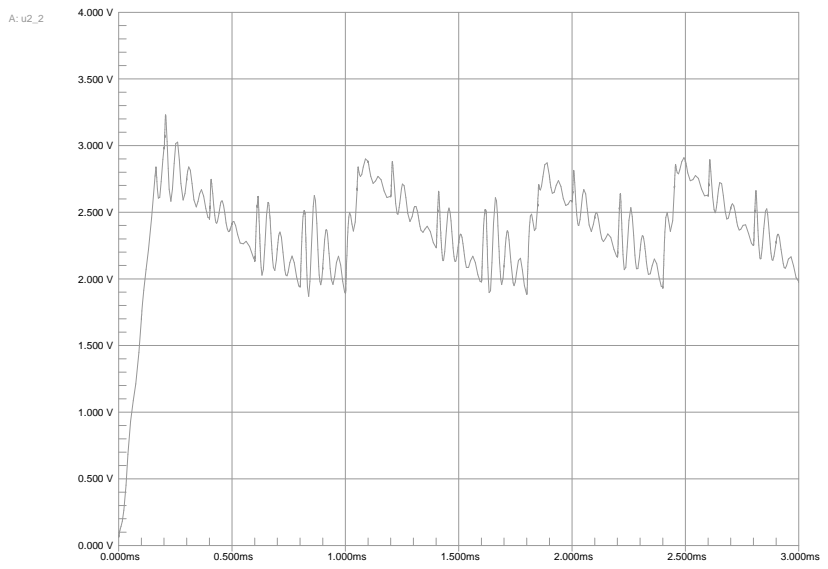
[picture p62: page 1]
