SimeonSimeonovIvanov/DC-Servo/Scheme and Board/v.0.0.1/Power Stage/Cmp and Inv.pdf

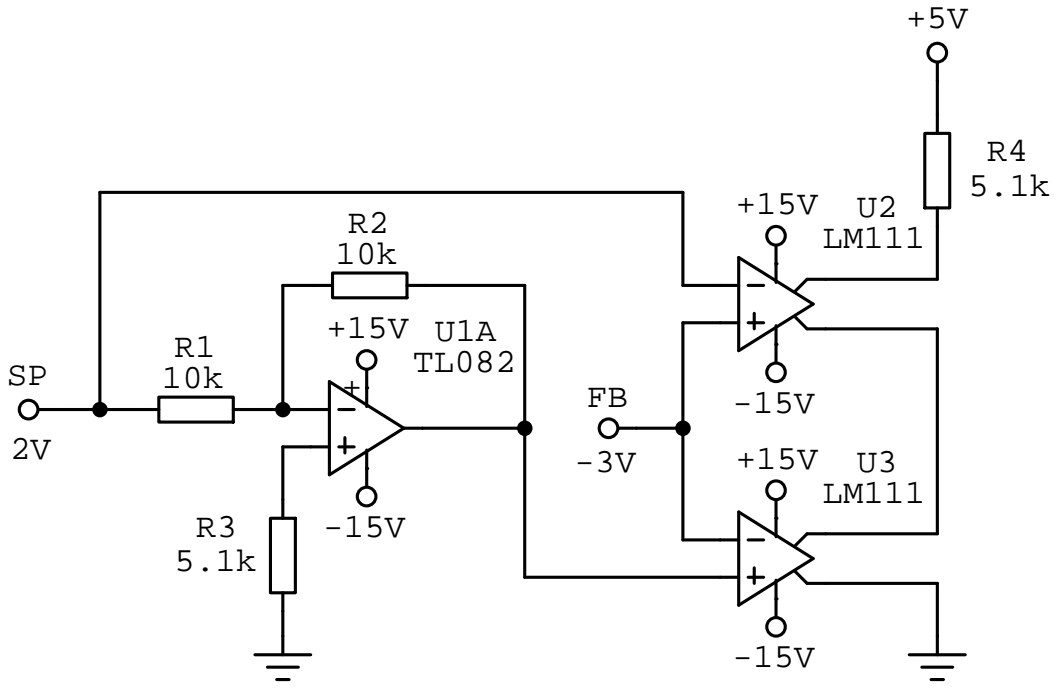
[picture p63: page 1]
