SimeonSimeonovIvanov/DC-Servo/Scheme and Board/v.0.0.1/Speed Reg/Simulation/Cmp and Inv 2.pdf

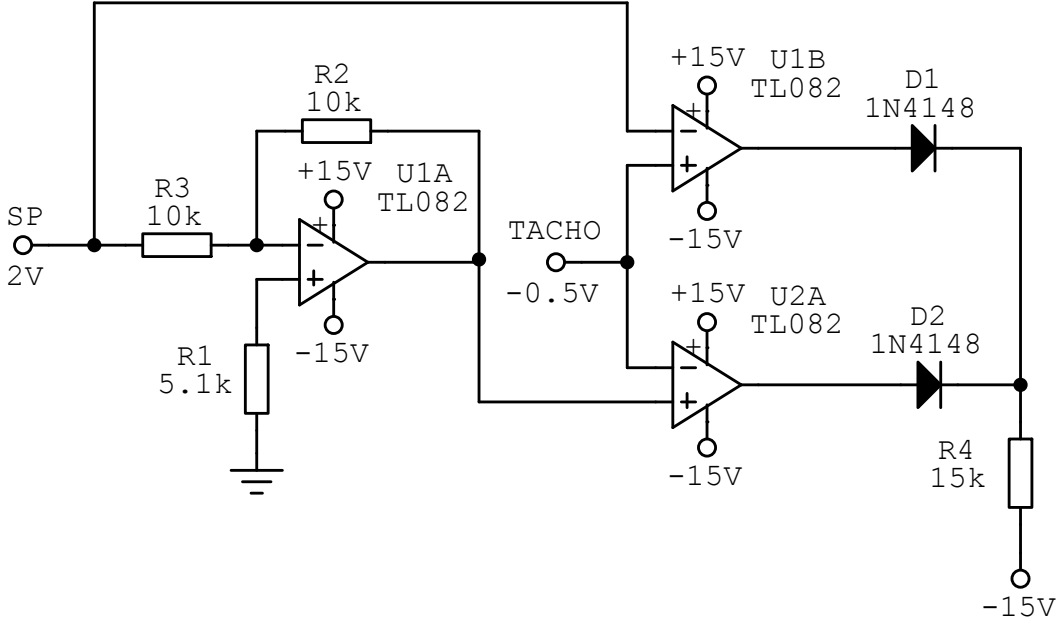
[picture p64: page 1]
