SimeonSimeonovIvanov/DC-Servo/Scheme and Board/v.0.0.1/Speed Reg/Simulation/Forward - Backward.pdf

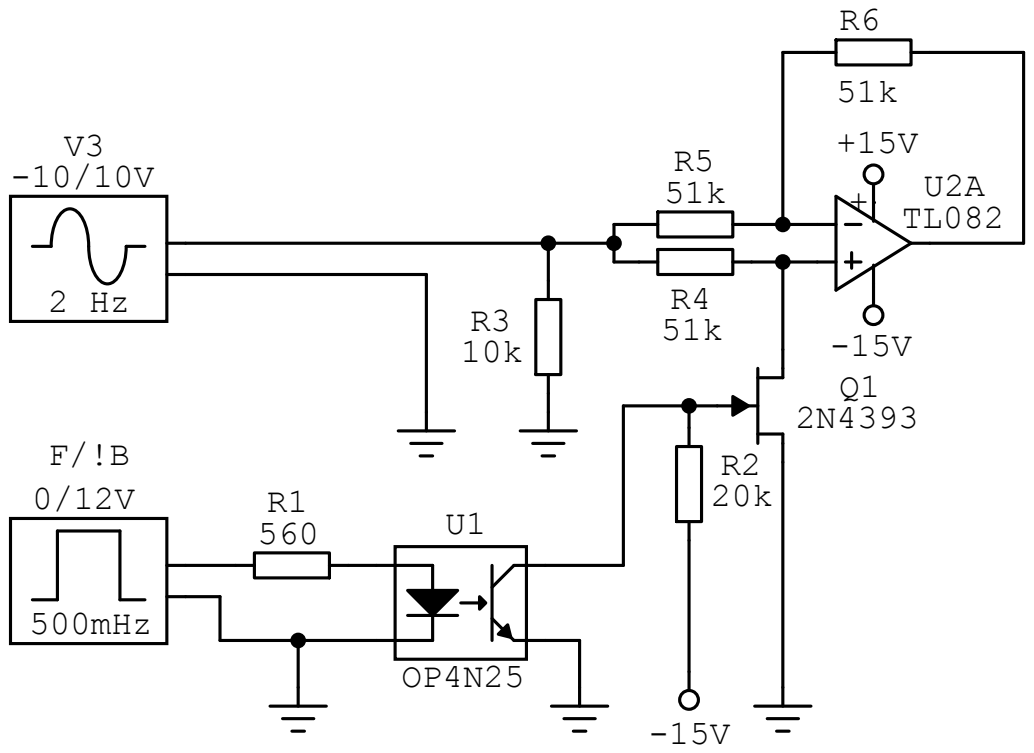
[picture p65: page 1]
