SimeonSimeonovIvanov/DC-Servo/Scheme and Board/v.0.0.1/Speed Reg/Simulation/Level Limiter (ELEKTROINVENT).pdf

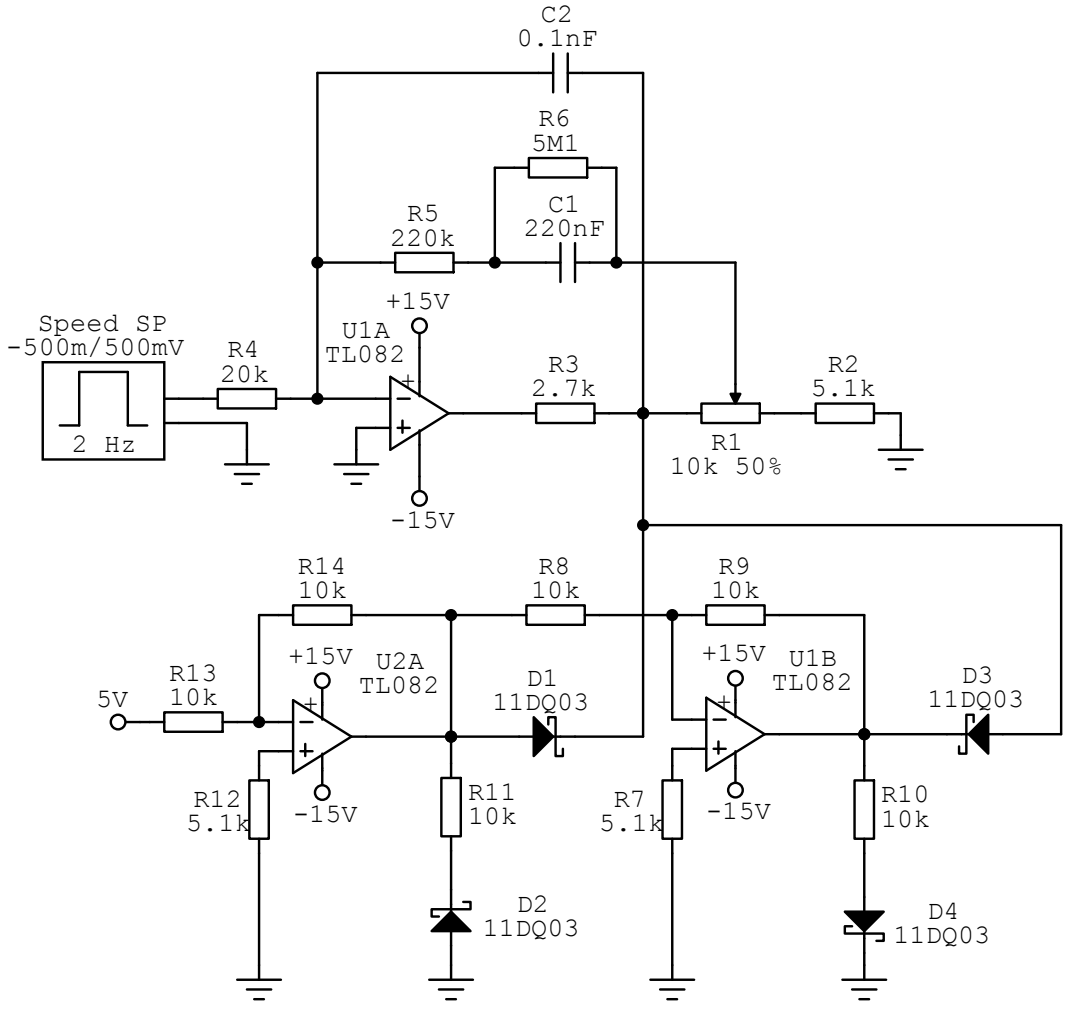
[picture p66: page 1]
