SimeonSimeonovIvanov/DC-Servo/Scheme and Board/v.0.0.1/Speed Reg/Simulation/Low Speed.pdf

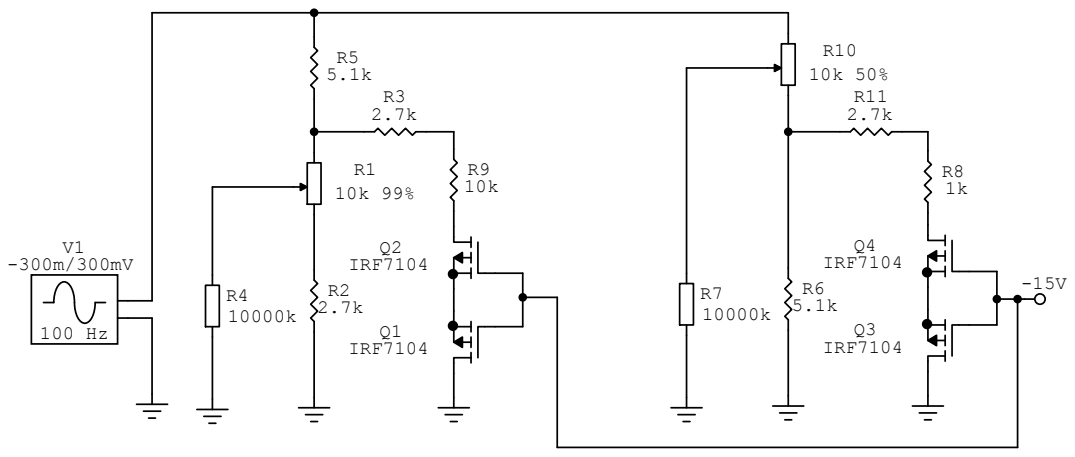
[picture p67: page 1]
