SimeonSimeonovIvanov/DC-Servo/Scheme and Board/v.0.0.1/Speed Reg/Simulation/Ramp Generator.pdf

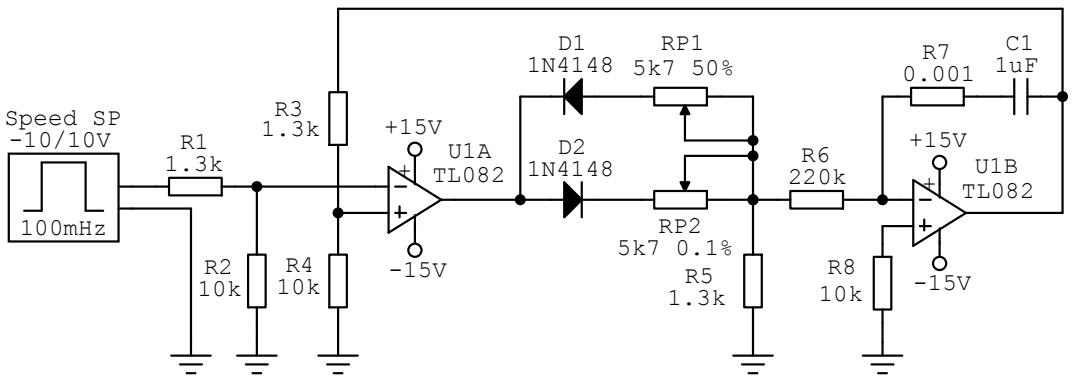
[picture p68: page 1]
