SimeonSimeonovIvanov/DC-Servo/Scheme and Board/v.0.0.1/Speed Reg/Simulation/Speed Reg (PI) .pdf

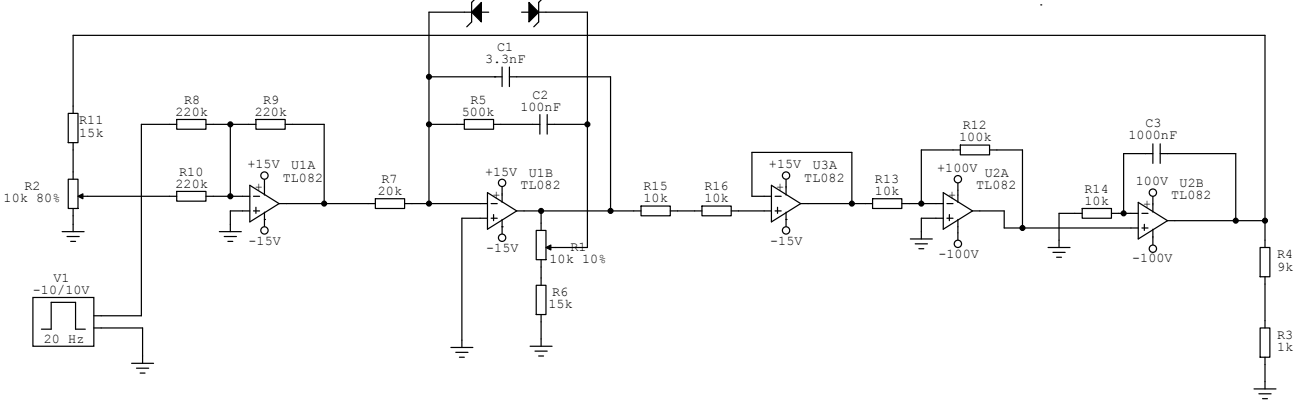
[picture p69: page 1]
