SimeonSimeonovIvanov/DC-Servo/Scheme and Board/v.0.0.0/Speed Reg/v.0.0.0.pdf

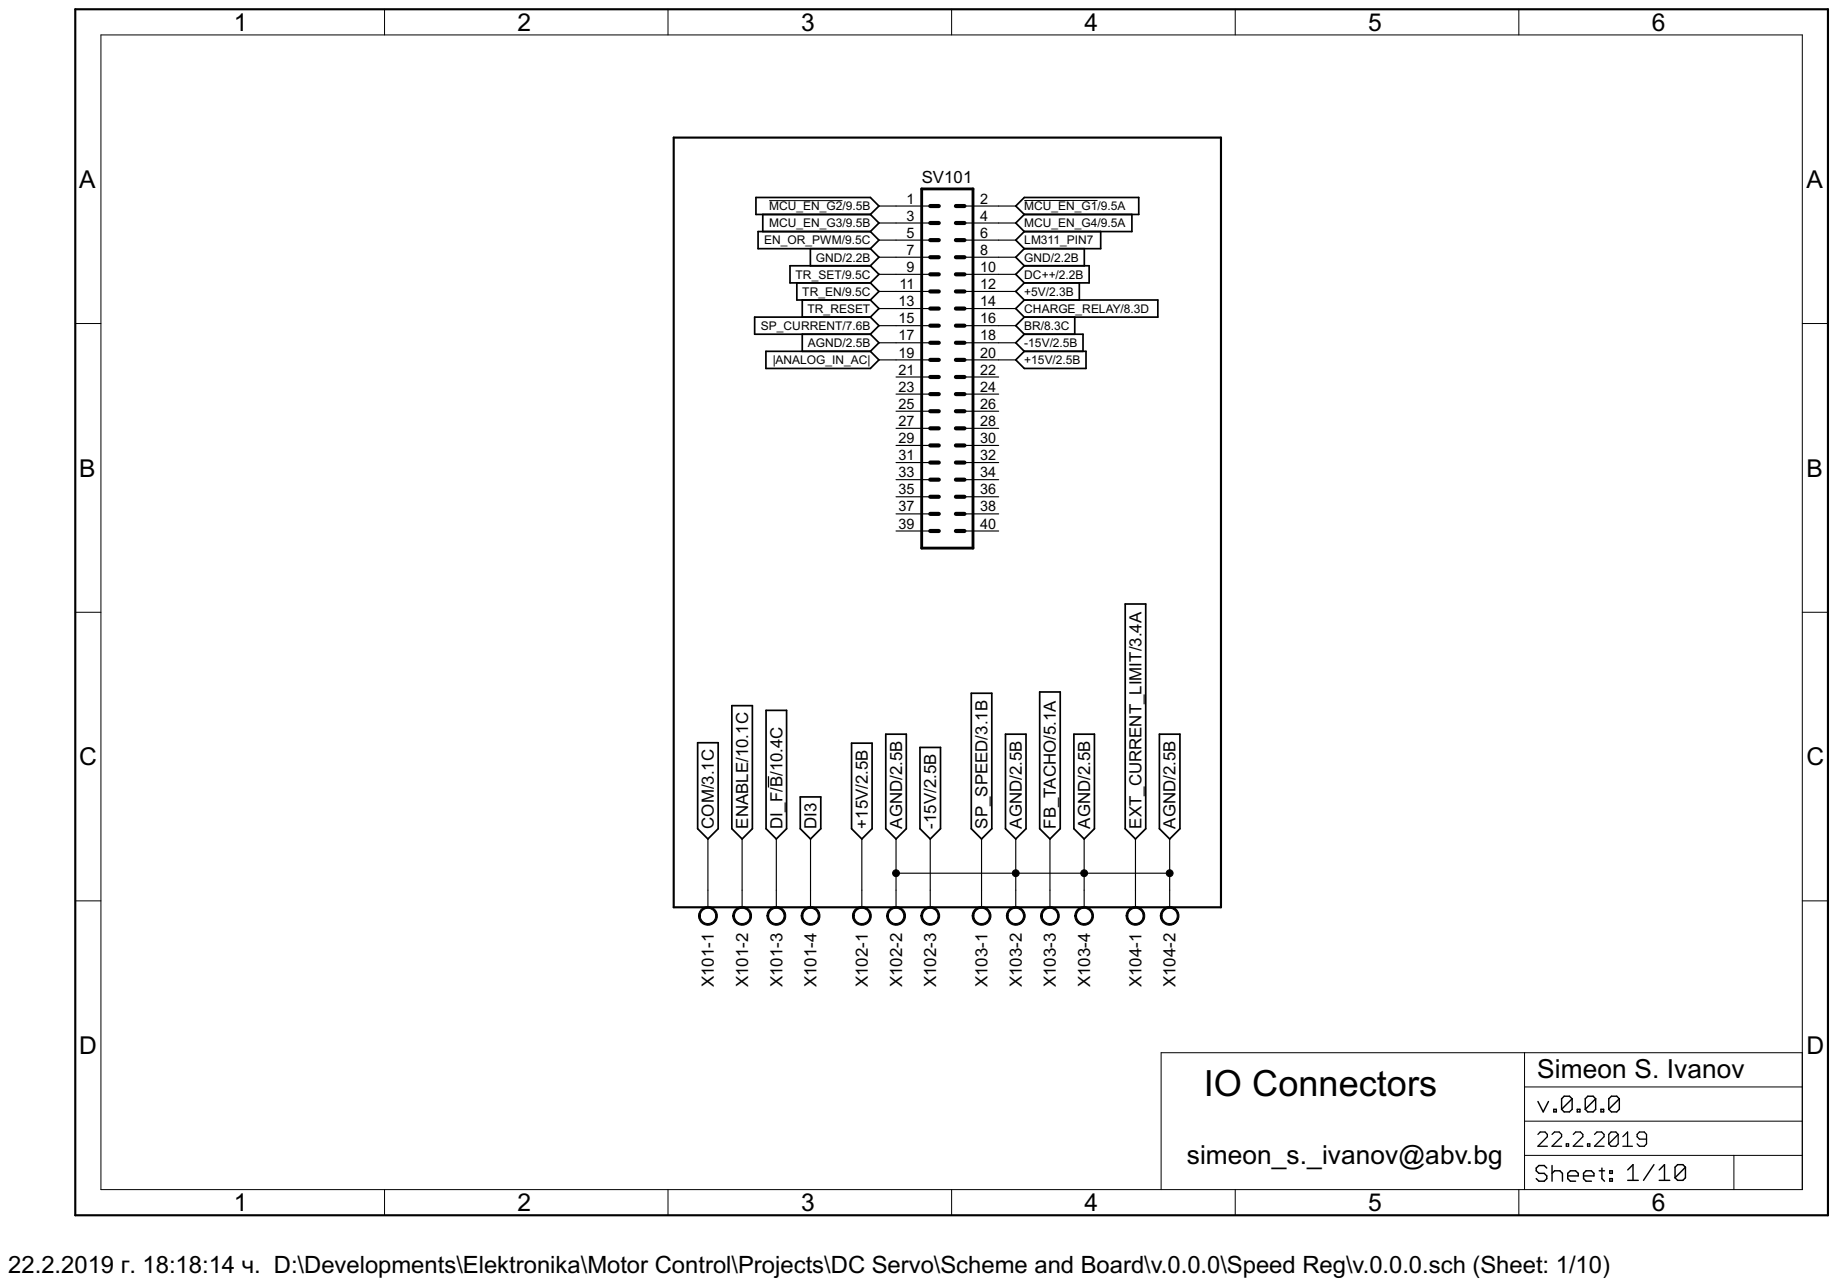
[picture p70: page 1]

AGND/2.5B | -15V/2.5B

ANALOG_IN_AC| | +15V/2.5B

22.2.2019 г. 18:18:14 ч. D:\Developments\Elektronika\Motor Control\Projects\DC Servo\Scheme and Board\v.0.0.0\Speed Reg\v.0.0.0.sch (Sheet: 1/10)

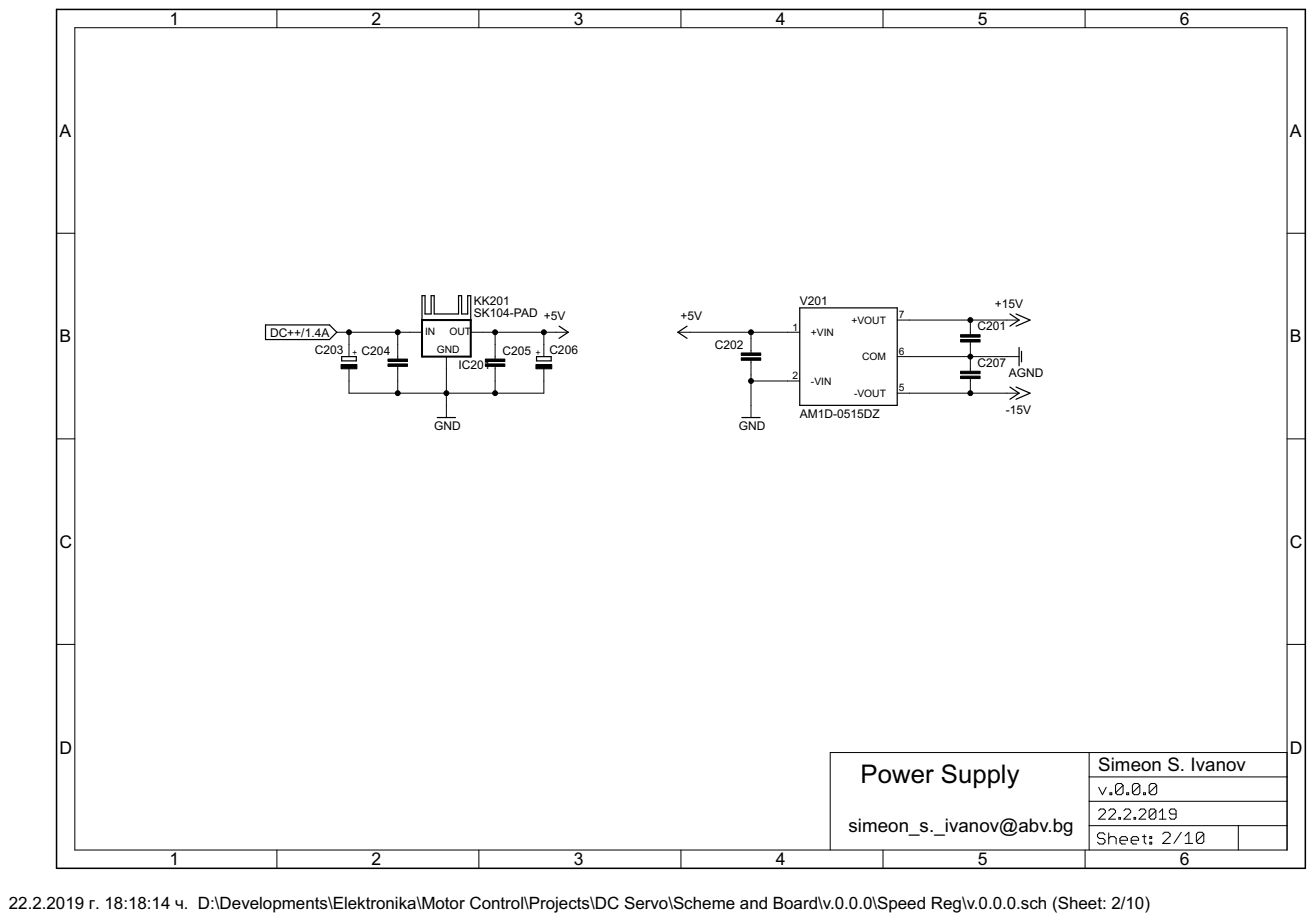
[picture p71: page 2]

Simeon S. Ivanov Power Supply

22.2.2019 г. 18:18:14 ч. D:\Developments\Elektronika\Motor Control\Projects\DC Servo\Scheme and Board\v.0.0.0\Speed Reg\v.0.0.0.sch (Sheet: 2/10)

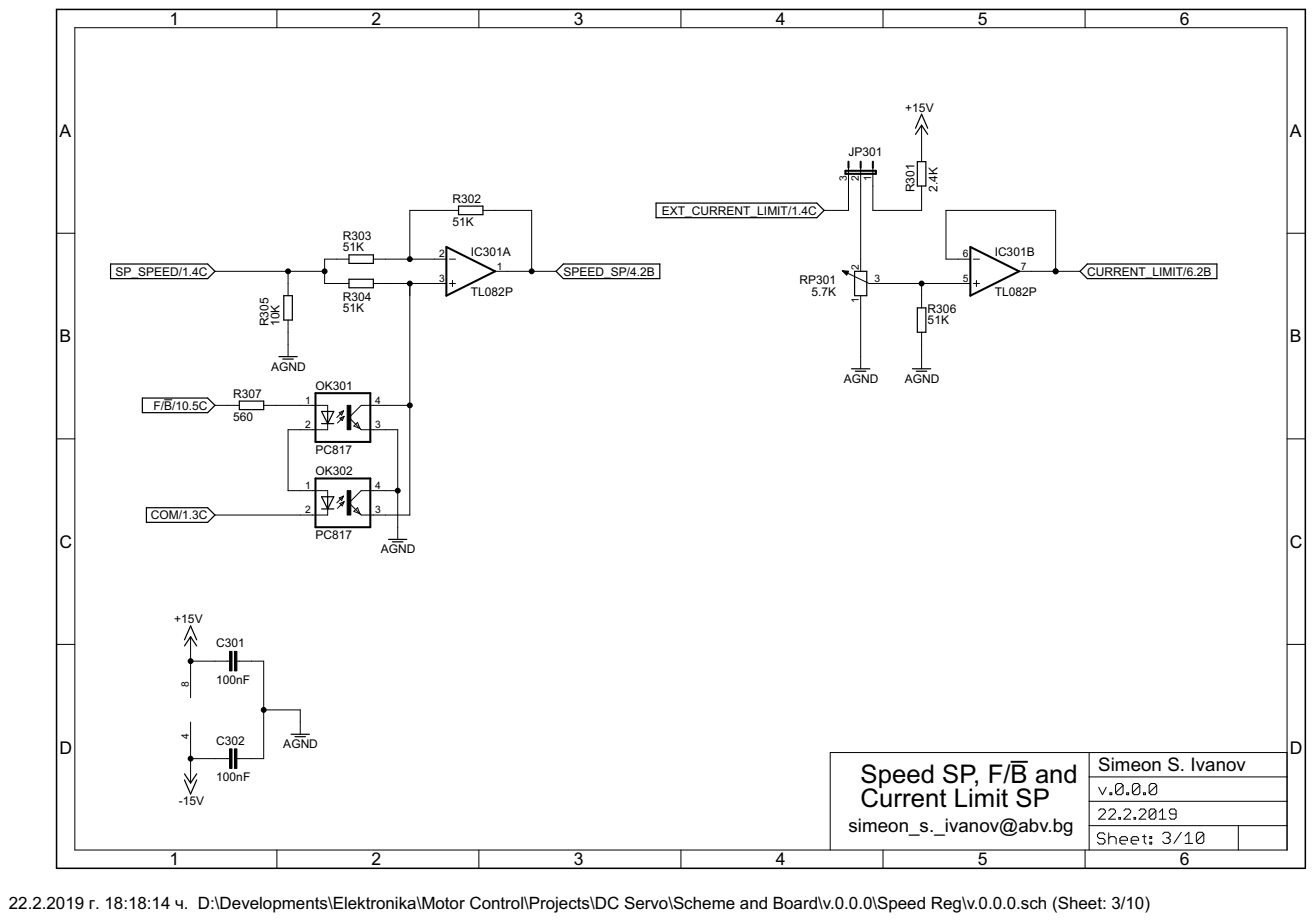
[picture p72: page 3]

Simeon S. Ivanov Speed SP, F/B and
Current Limit SP
simeon_s._ivanov@abv.bg

22.2.2019 г. 18:18:14 ч. D:\Developments\Elektronika\Motor Control\Projects\DC Servo\Scheme and Board\v.0.0.0\Speed Reg\v.0.0.0.sch (Sheet: 3/10)

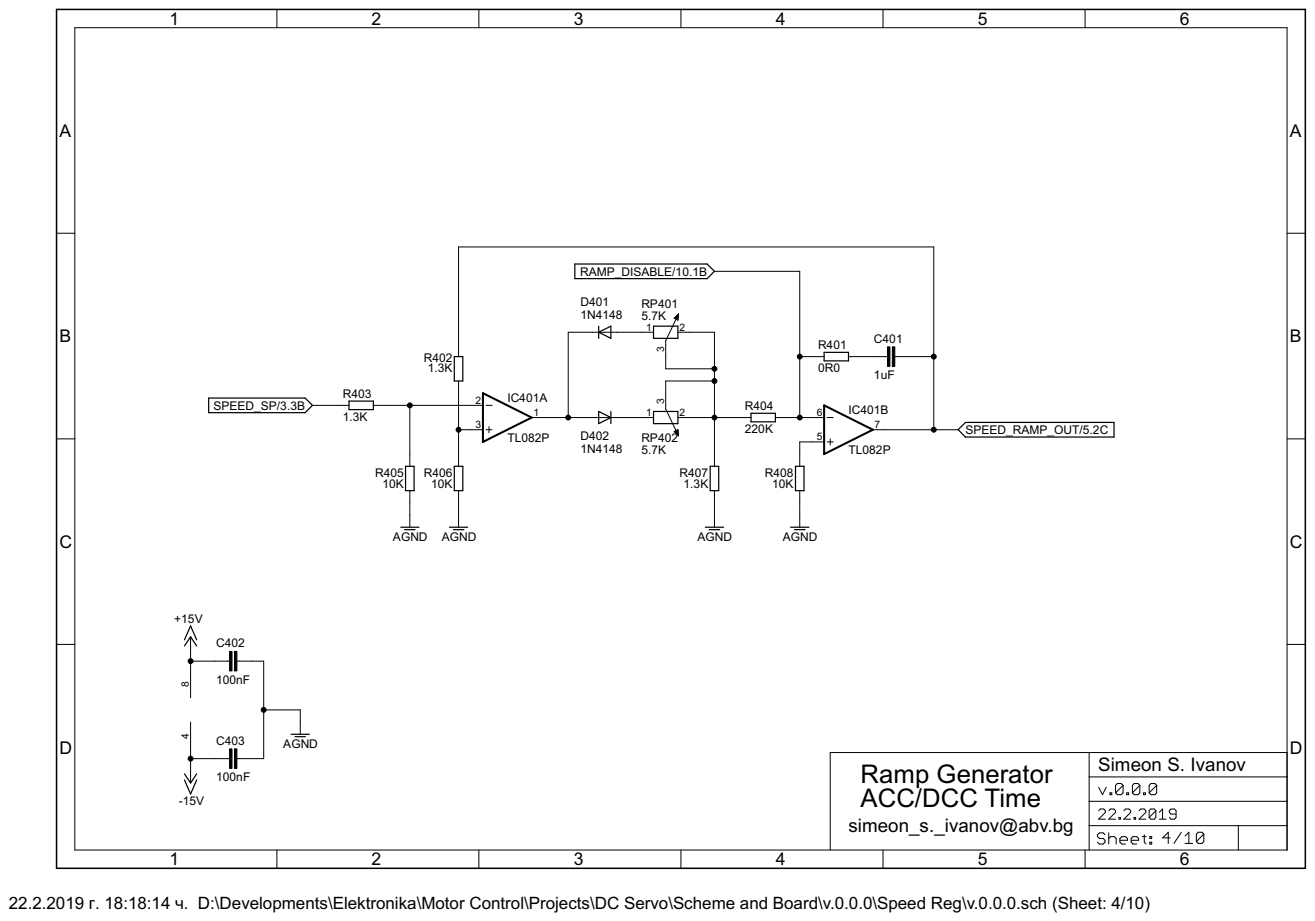
[picture p73: page 4]

Simeon S. Ivanov Ramp Generator
ACC/DCC Time
simeon_s._ivanov@abv.bg

22.2.2019 г. 18:18:14 ч. D:\Developments\Elektronika\Motor Control\Projects\DC Servo\Scheme and Board\v.0.0.0\Speed Reg\v.0.0.0.sch (Sheet: 4/10)

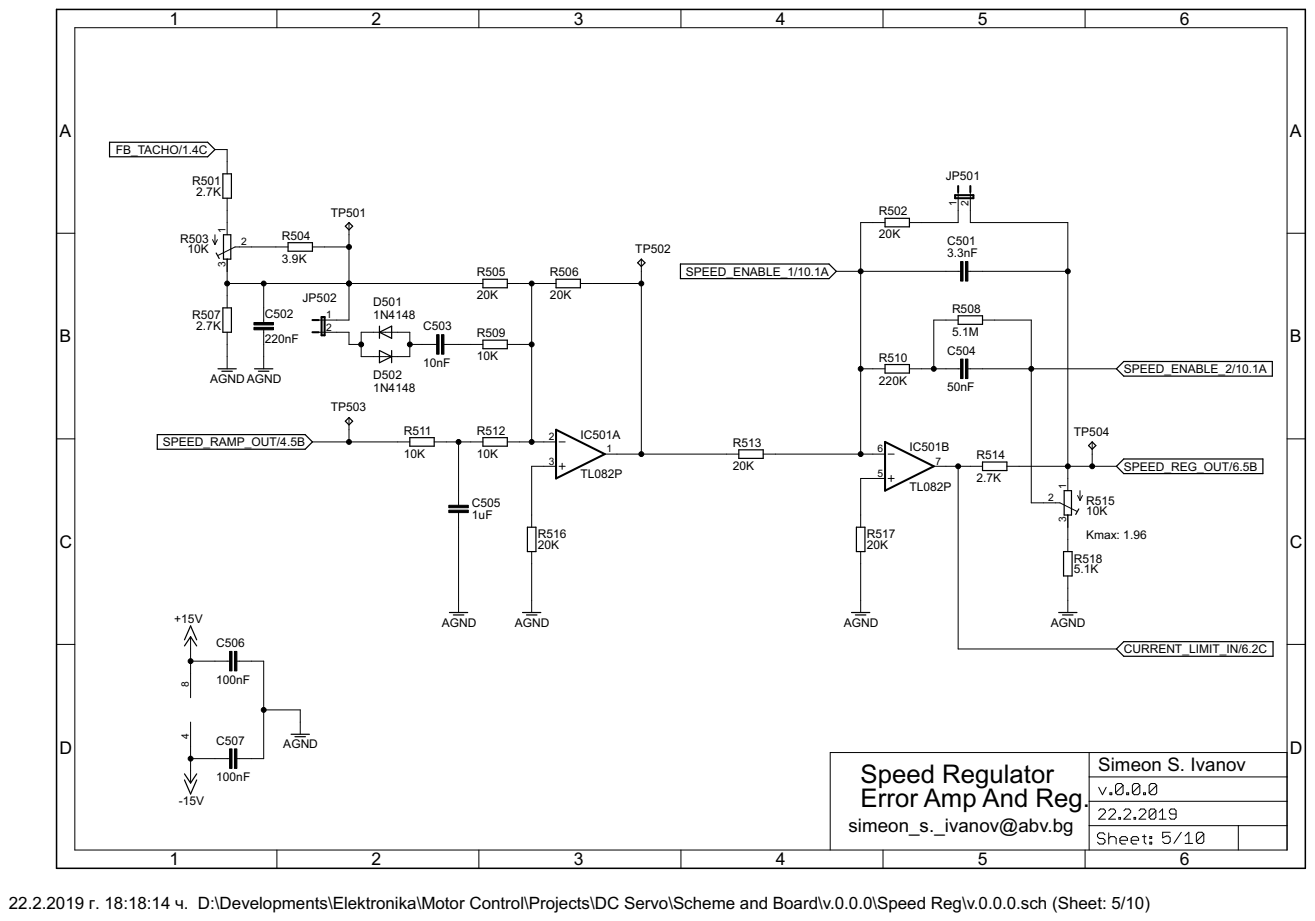
[picture p74: page 5]

Simeon S. Ivanov Speed Regulator
Error Amp And Reg. simeon_s._ivanov@abv.bg

22.2.2019 г. 18:18:14 ч. D:\Developments\Elektronika\Motor Control\Projects\DC Servo\Scheme and Board\v.0.0.0\Speed Reg\v.0.0.0.sch (Sheet: 5/10)

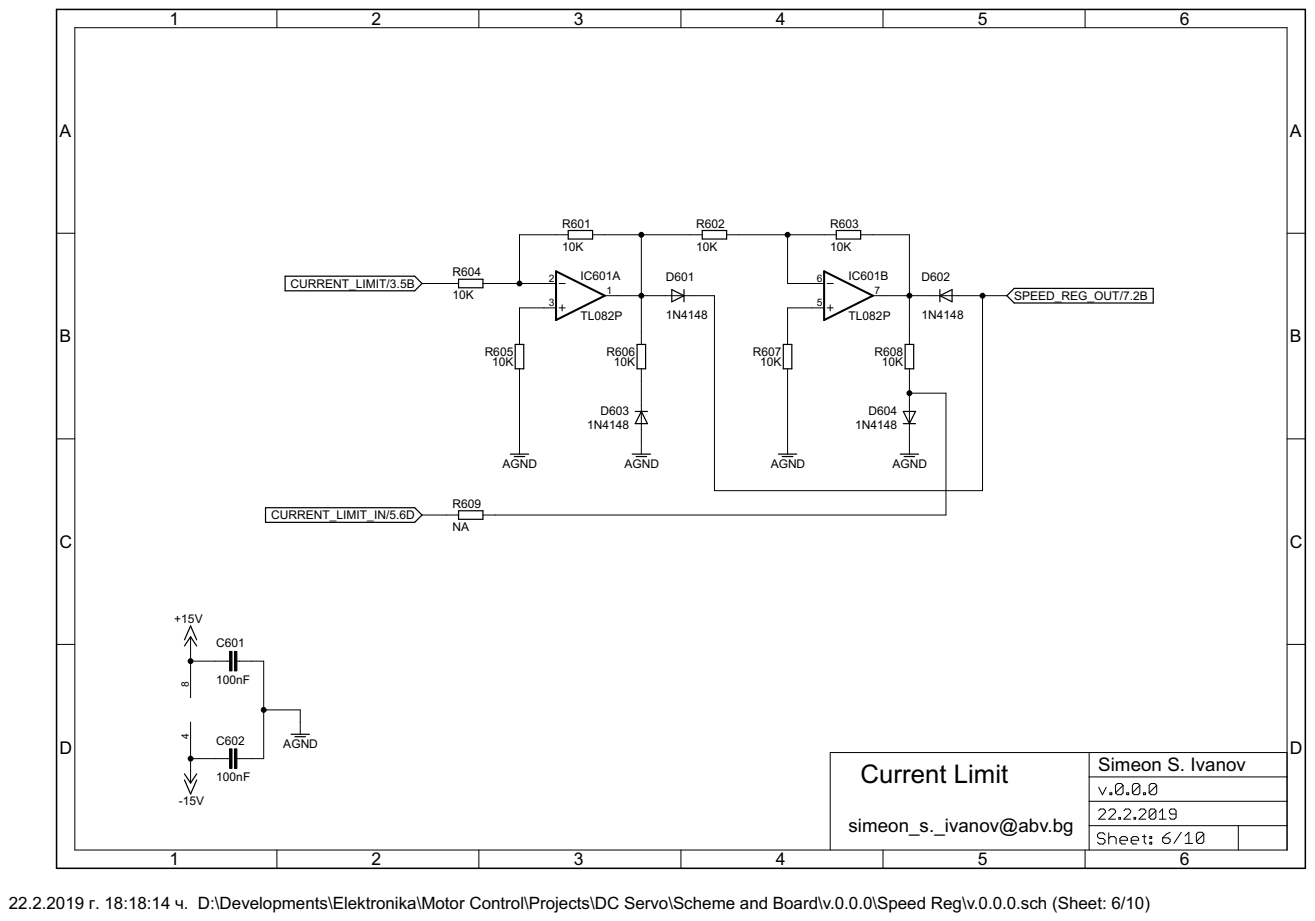
[picture p75: page 6]

Simeon S. Ivanov Current Limit

22.2.2019 г. 18:18:14 ч. D:\Developments\Elektronika\Motor Control\Projects\DC Servo\Scheme and Board\v.0.0.0\Speed Reg\v.0.0.0.sch (Sheet: 6/10)

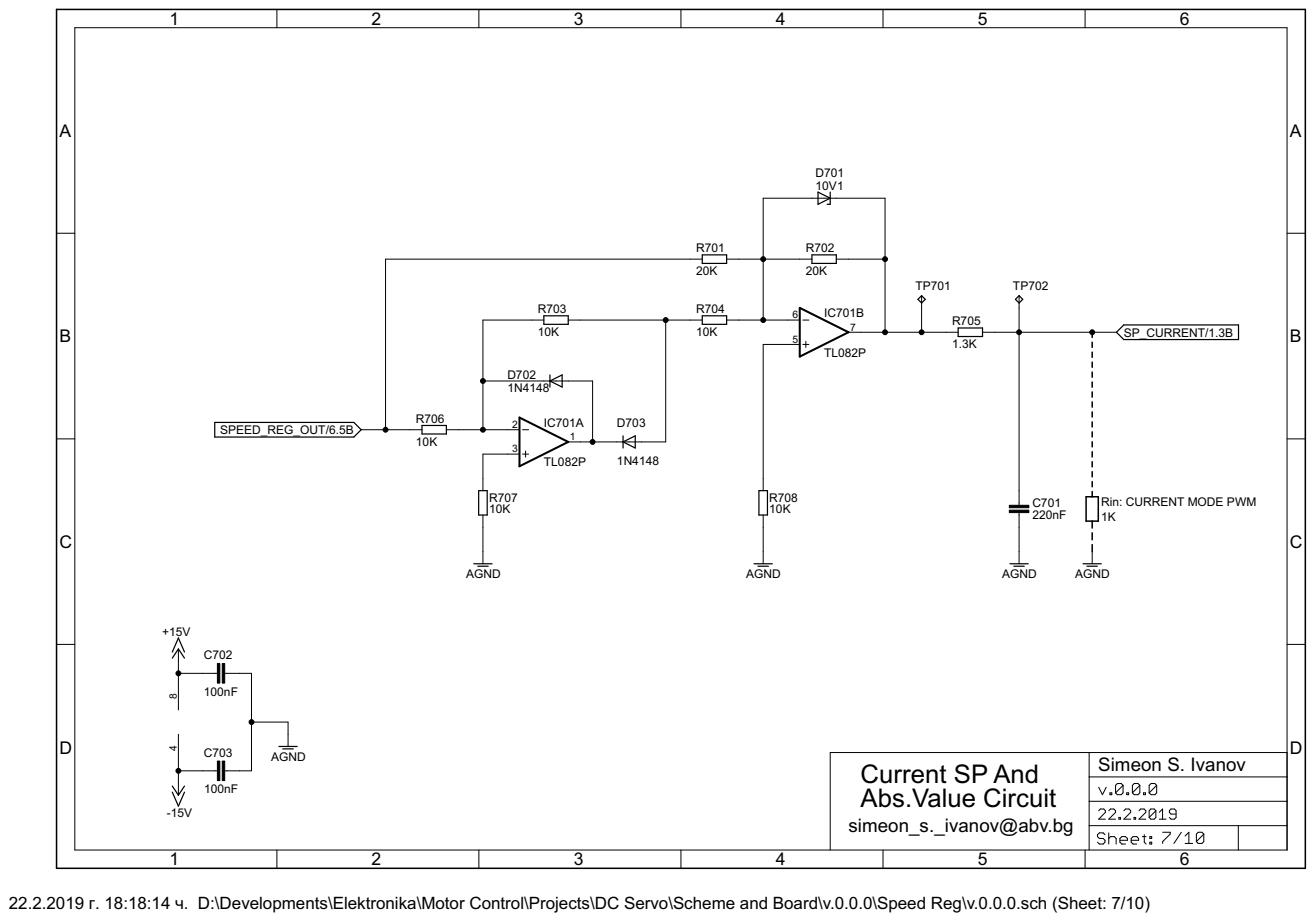
[picture p76: page 7]

Rin: CURRENT MODE PWM

Simeon S. Ivanov Current SP And
Abs.Value Circuit
simeon_s._ivanov@abv.bg

22.2.2019 г. 18:18:14 ч. D:\Developments\Elektronika\Motor Control\Projects\DC Servo\Scheme and Board\v.0.0.0\Speed Reg\v.0.0.0.sch (Sheet: 7/10)

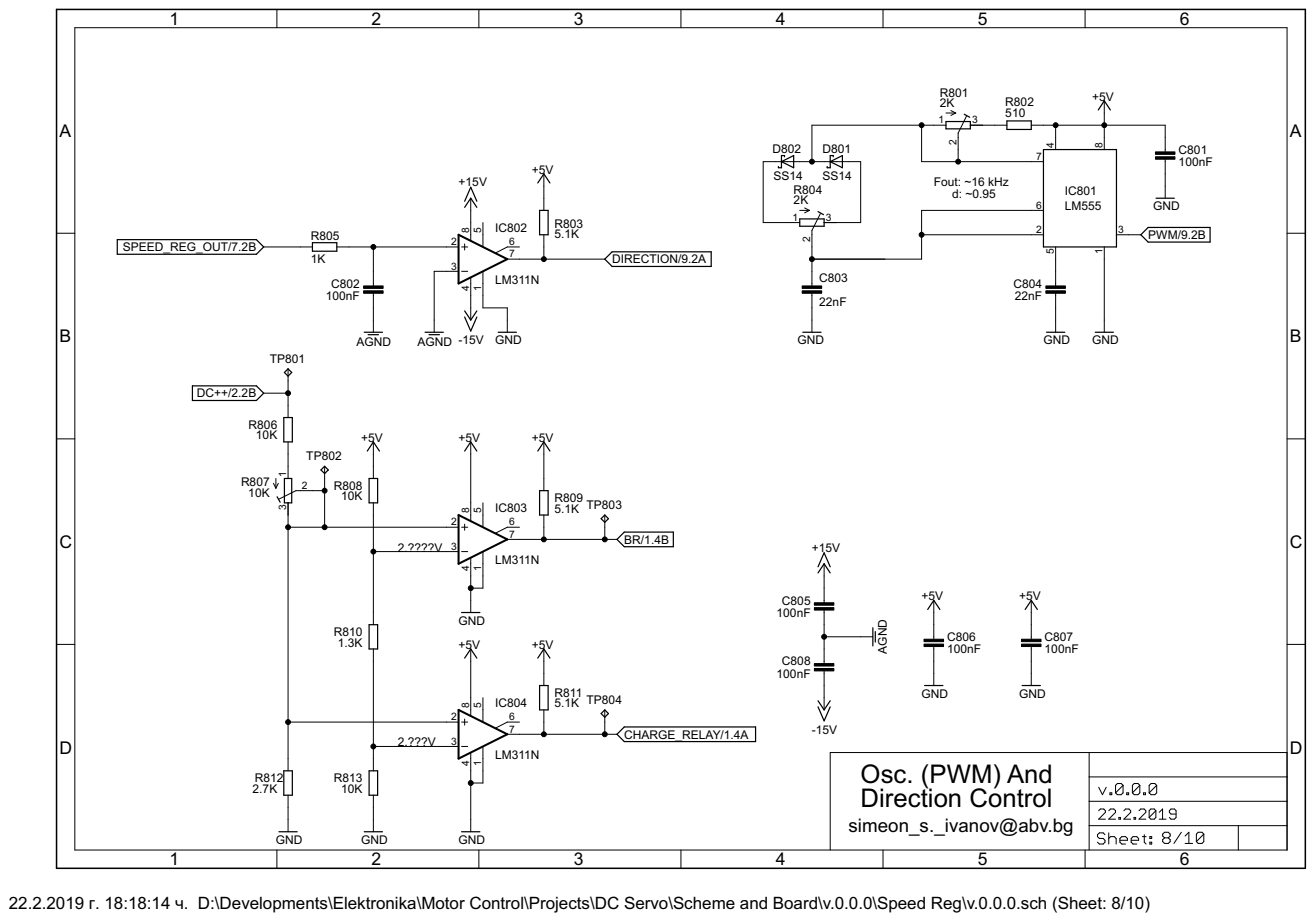
[picture p77: page 8]

Osc. (PWM) And Direction Control simeon_s._ivanov@abv.bg

22.2.2019 г. 18:18:14 ч. D:\Developments\Elektronika\Motor Control\Projects\DC Servo\Scheme and Board\v.0.0.0\Speed Reg\v.0.0.0.sch (Sheet: 8/10)

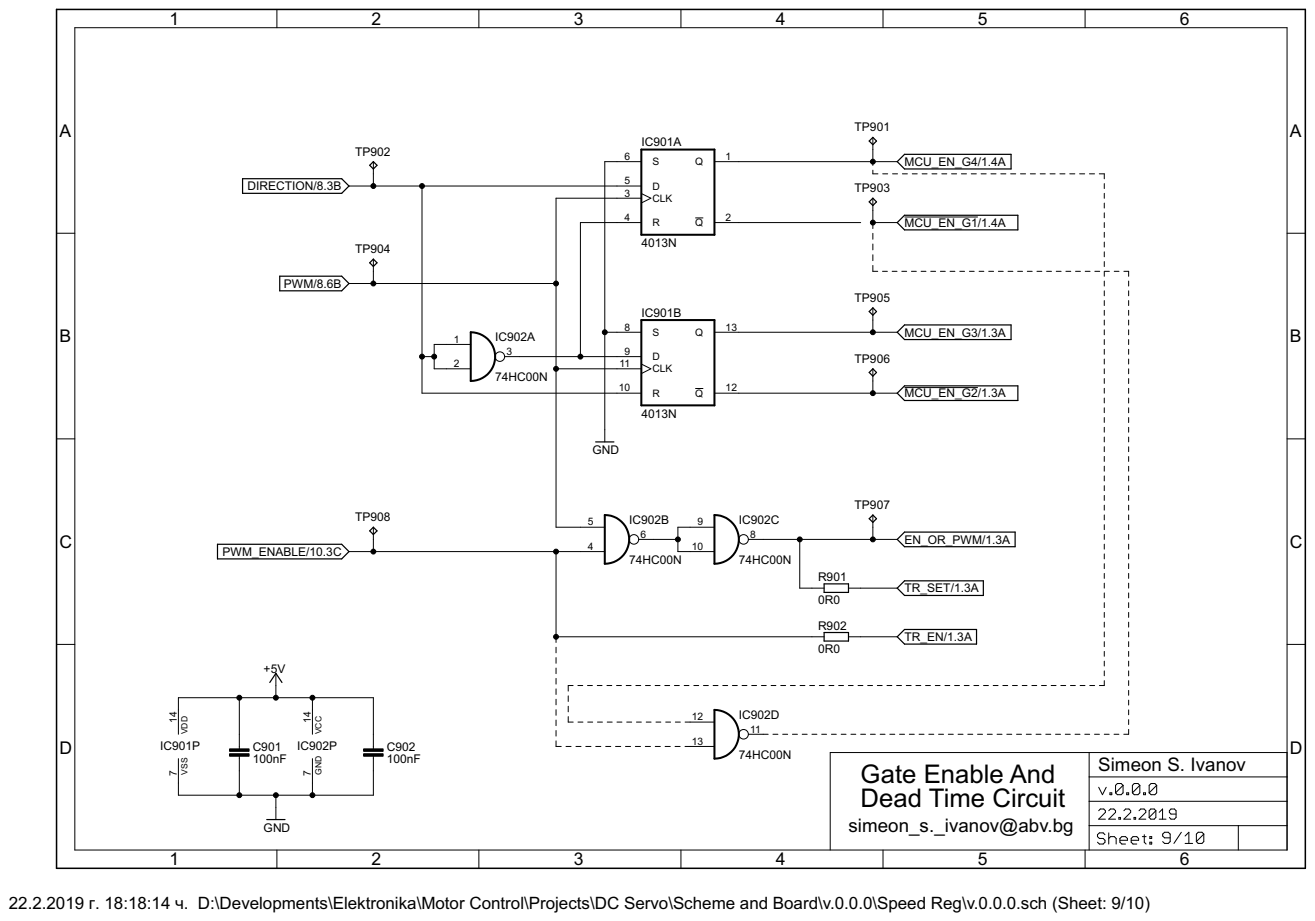
[picture p78: page 9]

22.2.2019 г. 18:18:14 ч. D:\Developments\Elektronika\Motor Control\Projects\DC Servo\Scheme and Board\v.0.0.0\Speed Reg\v.0.0.0.sch (Sheet: 9/10)

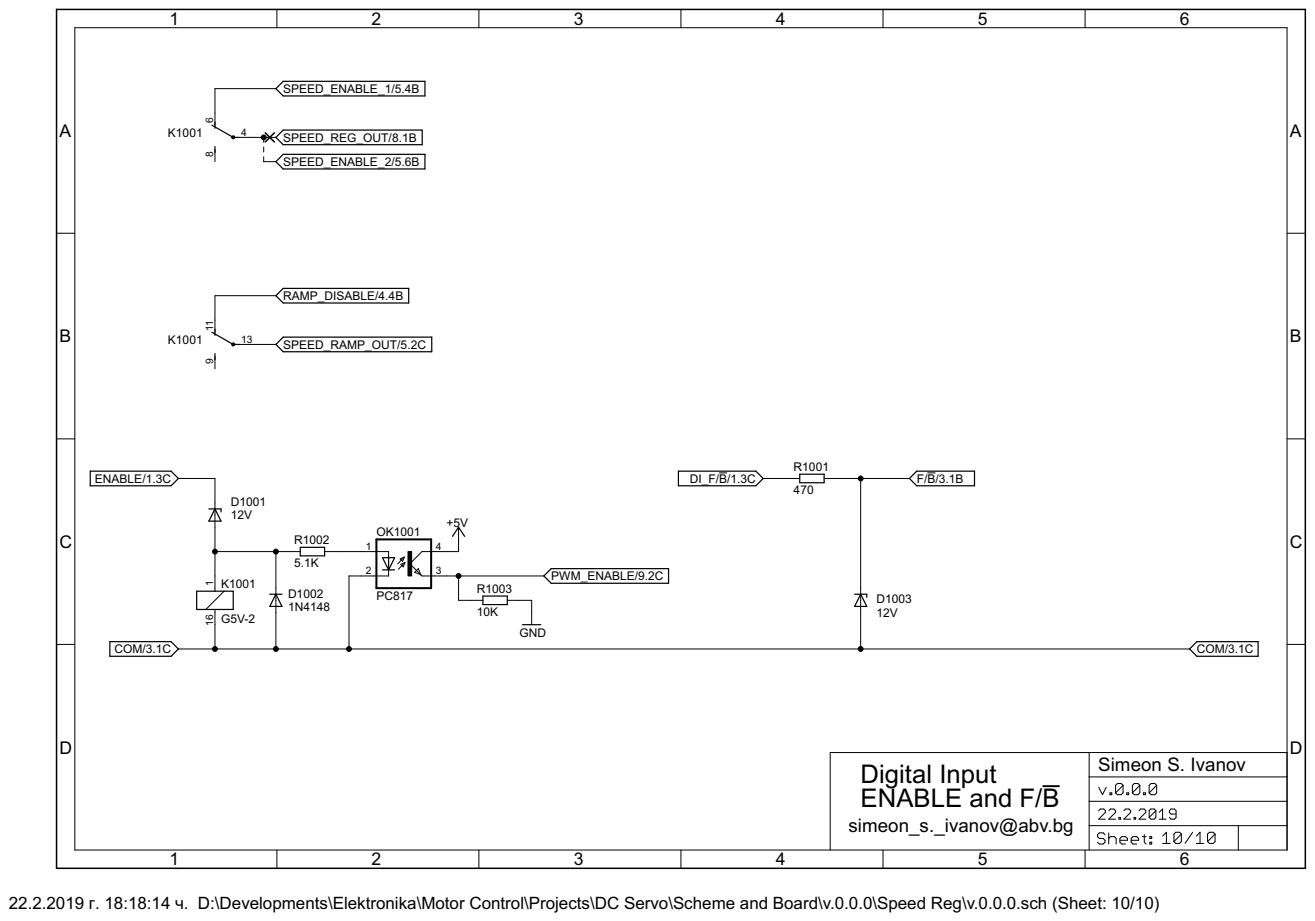
[picture p79: page 10]

Simeon S. Ivanov Digital Input
ENABLE and F/B
simeon_s._ivanov@abv.bg

22.2.2019 г. 18:18:14 ч. D:\Developments\Elektronika\Motor Control\Projects\DC Servo\Scheme and Board\v.0.0.0\Speed Reg\v.0.0.0.sch (Sheet: 10/10)
