SimeonSimeonovIvanov/DC-Servo/Scheme and Board/v.0.0.0/Power Stage/Power Stage.pdf

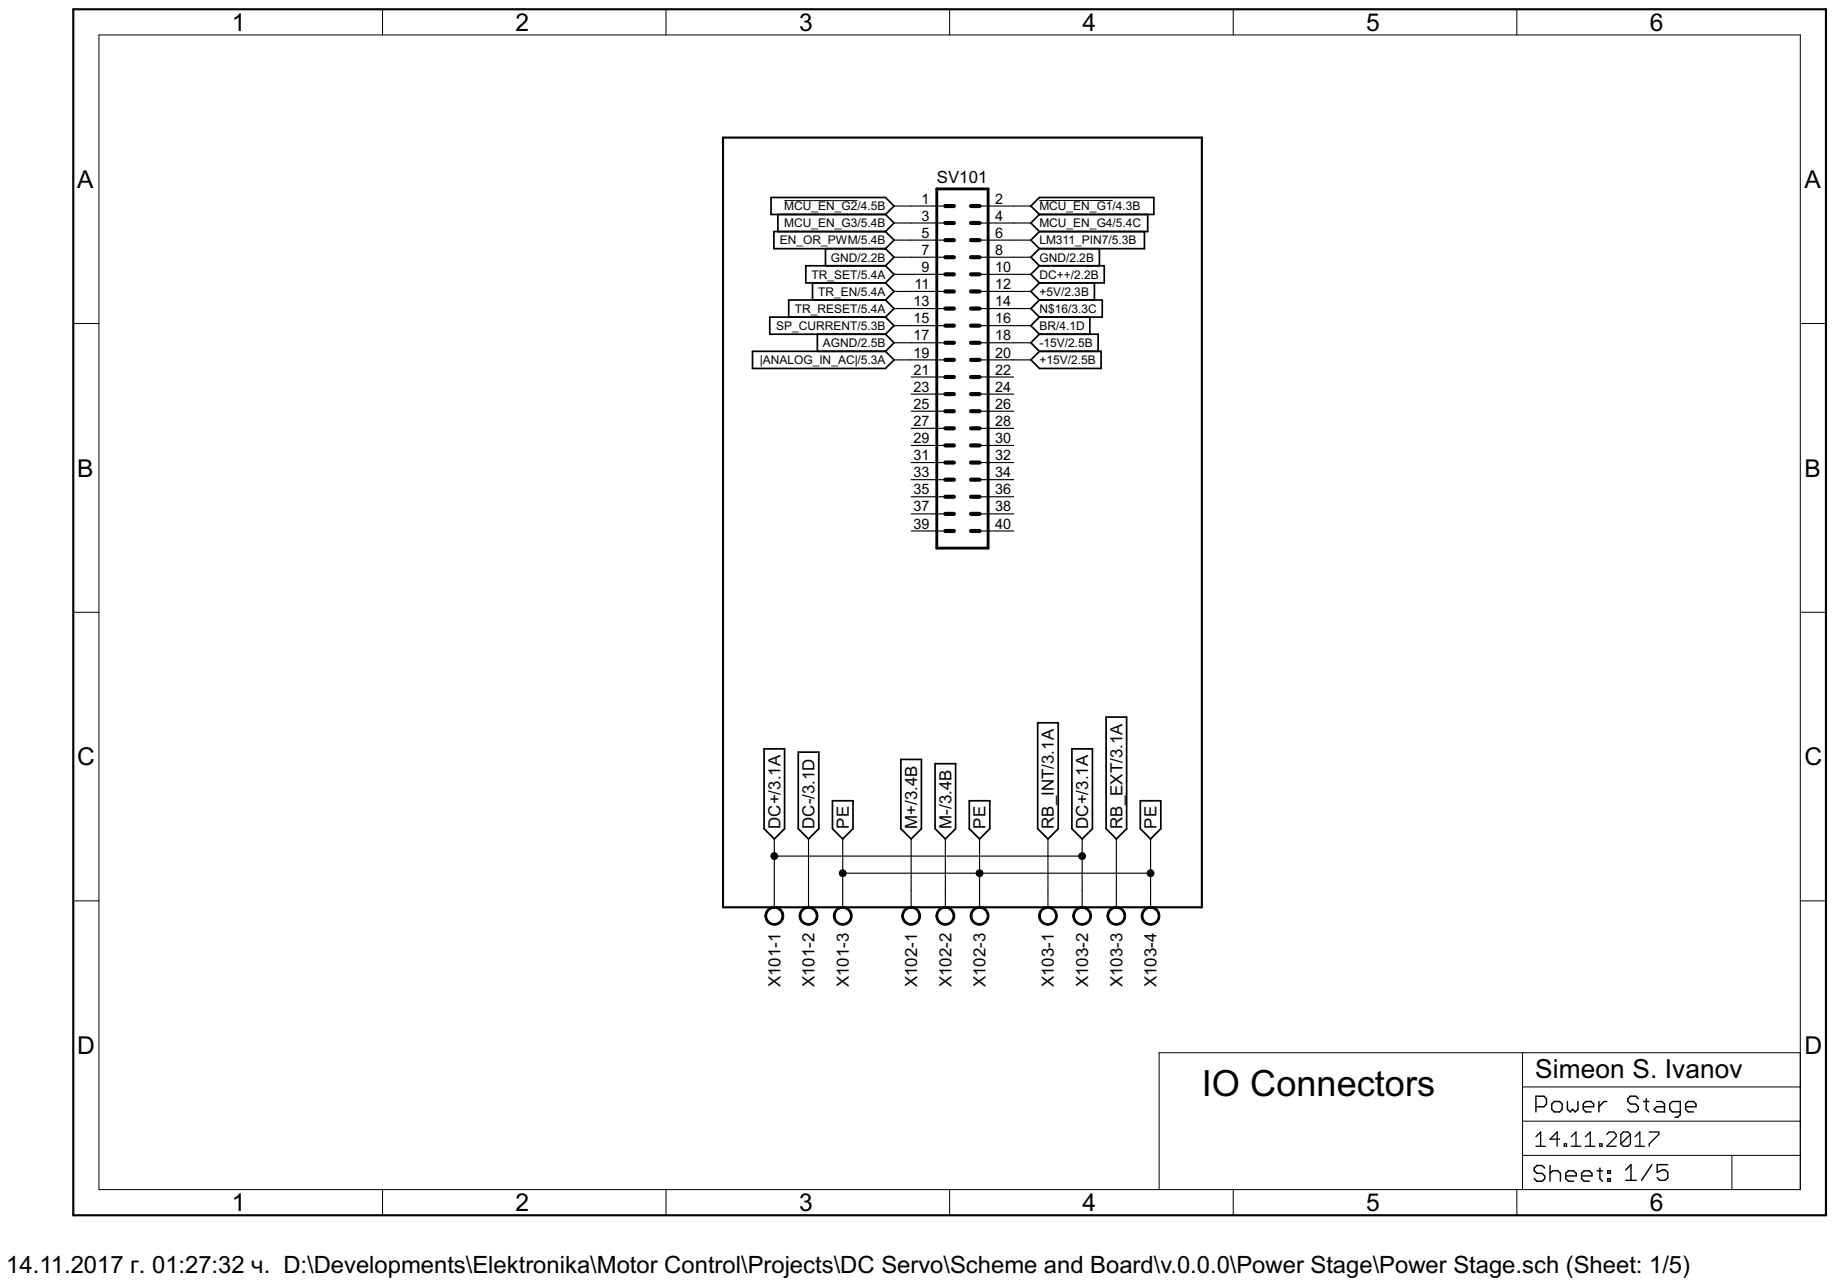
[picture p80: page 1]

14.11.2017 г. 01:27:32 ч. D:\Developments\Elektronika\Motor Control\Projects\DC Servo\Scheme and Board\v.0.0.0\Power Stage\Power Stage.sch (Sheet: 1/5)

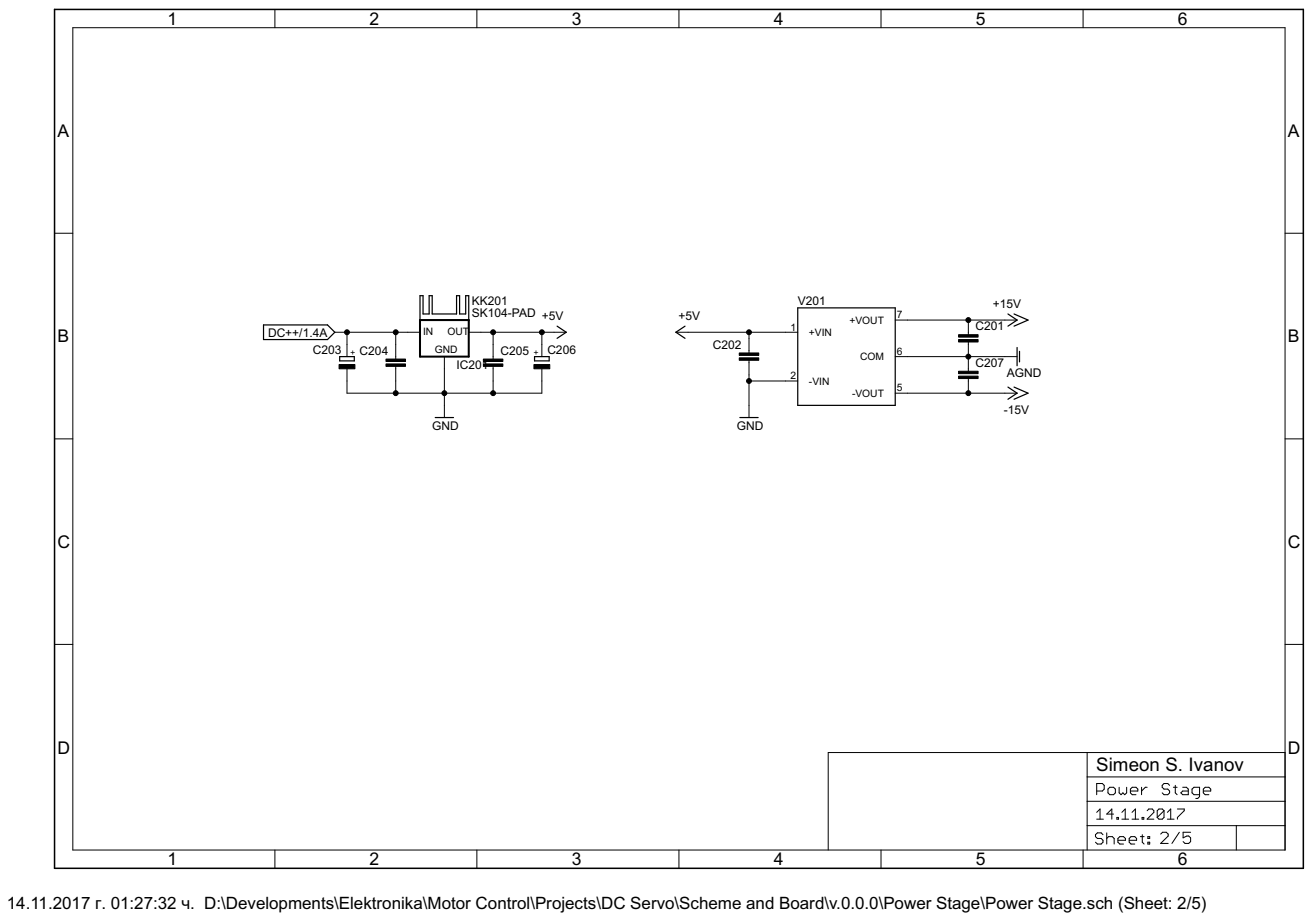
[picture p81: page 2]

14.11.2017 г. 01:27:32 ч. D:\Developments\Elektronika\Motor Control\Projects\DC Servo\Scheme and Board\v.0.0.0\Power Stage\Power Stage.sch (Sheet: 2/5)

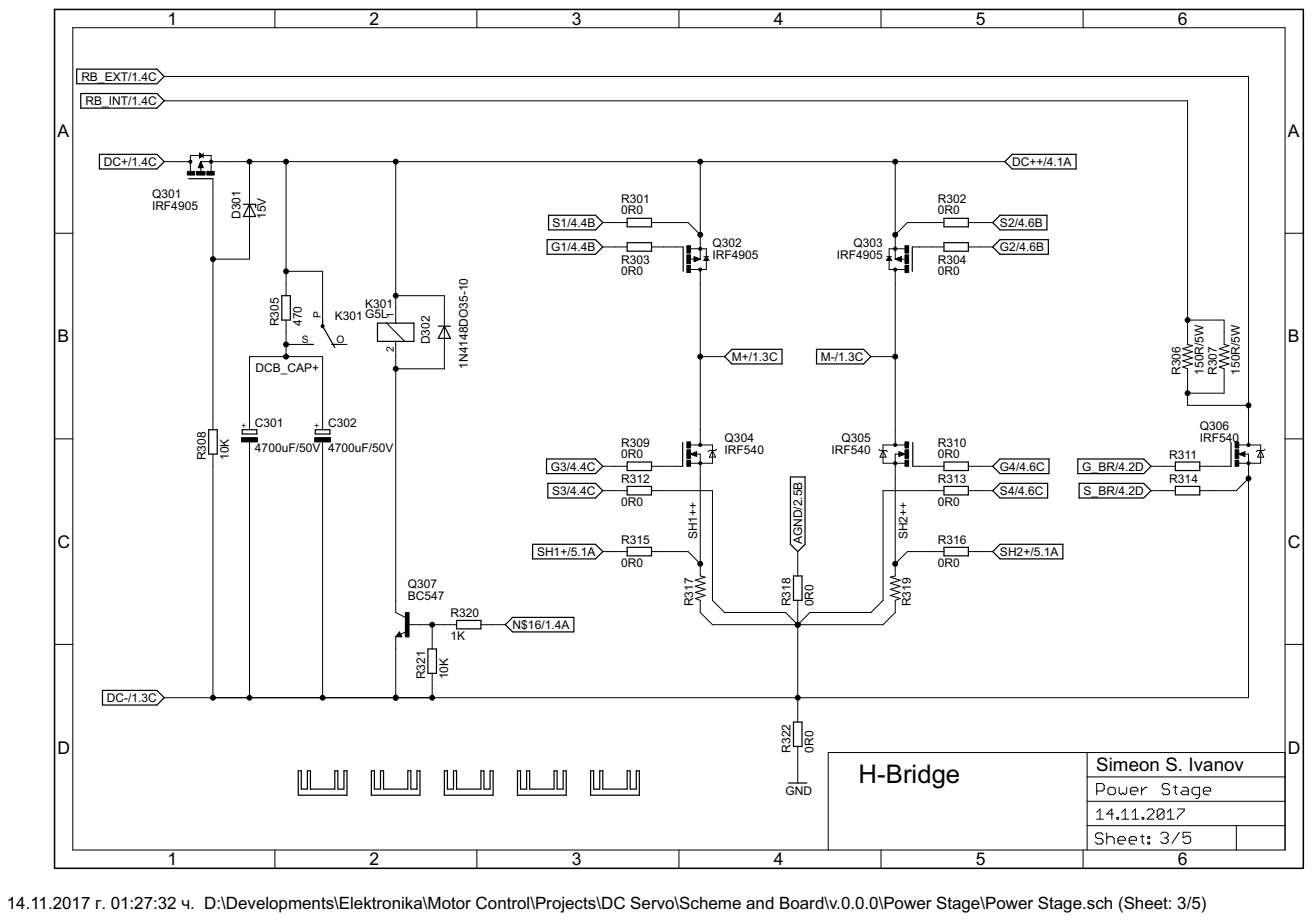
[picture p82: page 3]

14.11.2017 г. 01:27:32 ч. D:\Developments\Elektronika\Motor Control\Projects\DC Servo\Scheme and Board\v.0.0.0\Power Stage\Power Stage.sch (Sheet: 3/5)

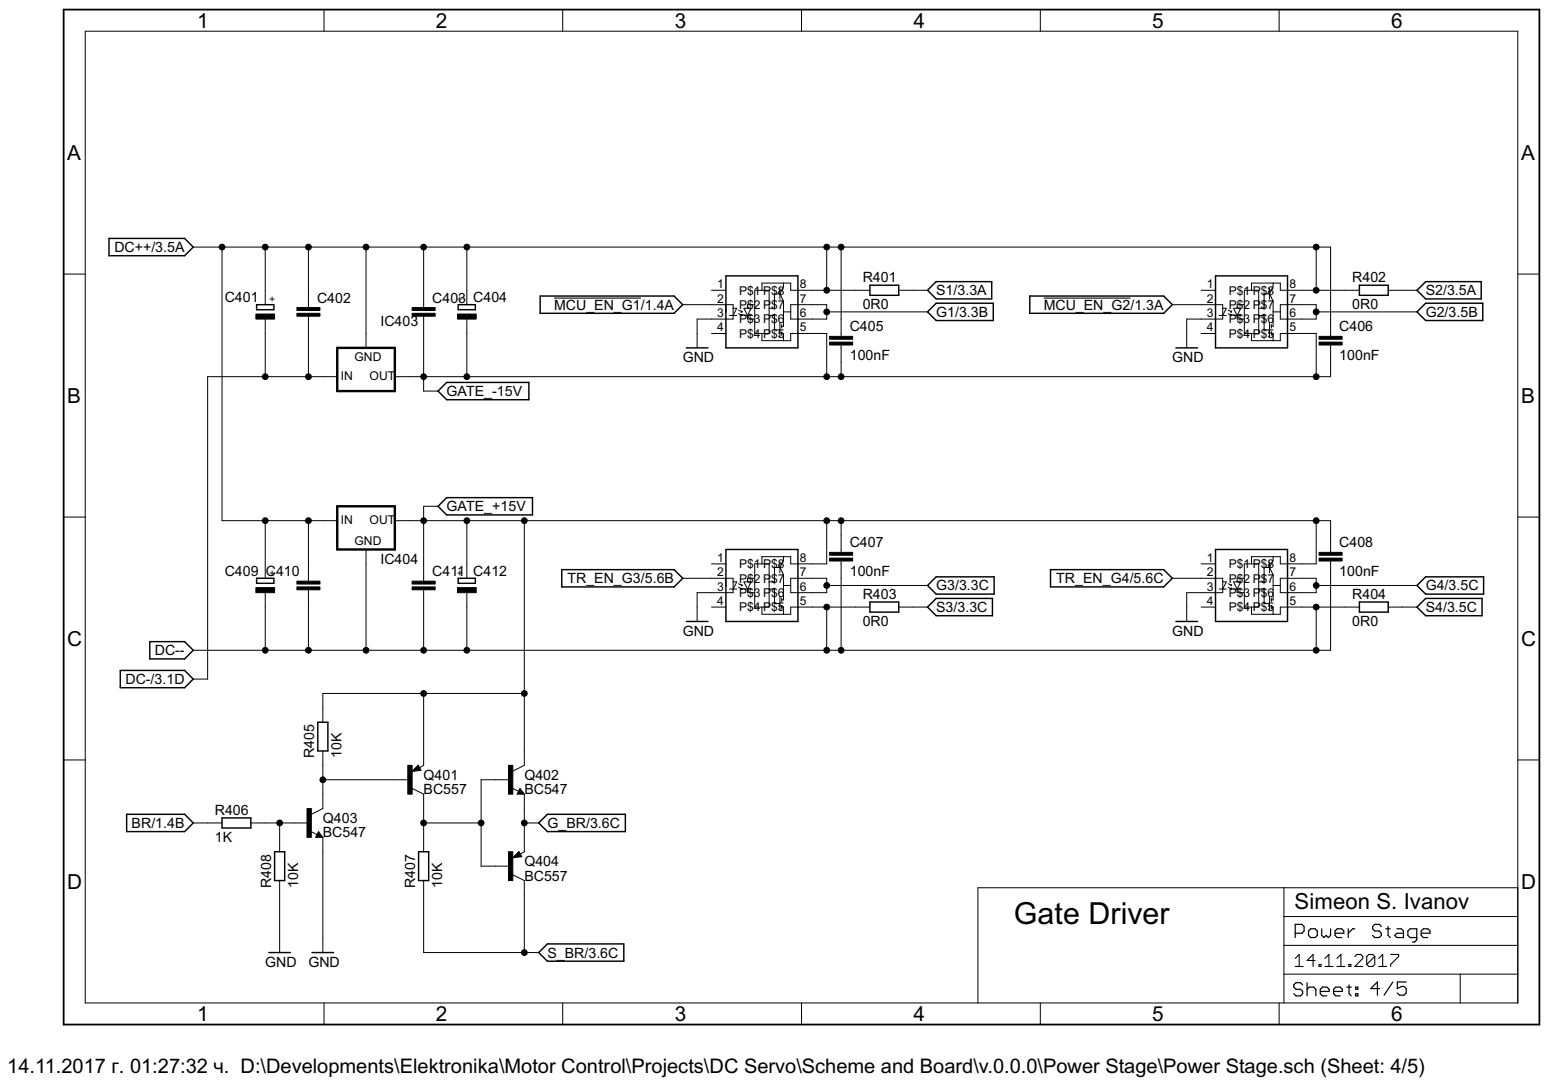
[picture p83: page 4]

14.11.2017 г. 01:27:32 ч. D:\Developments\Elektronika\Motor Control\Projects\DC Servo\Scheme and Board\v.0.0.0\Power Stage\Power Stage.sch (Sheet: 4/5)

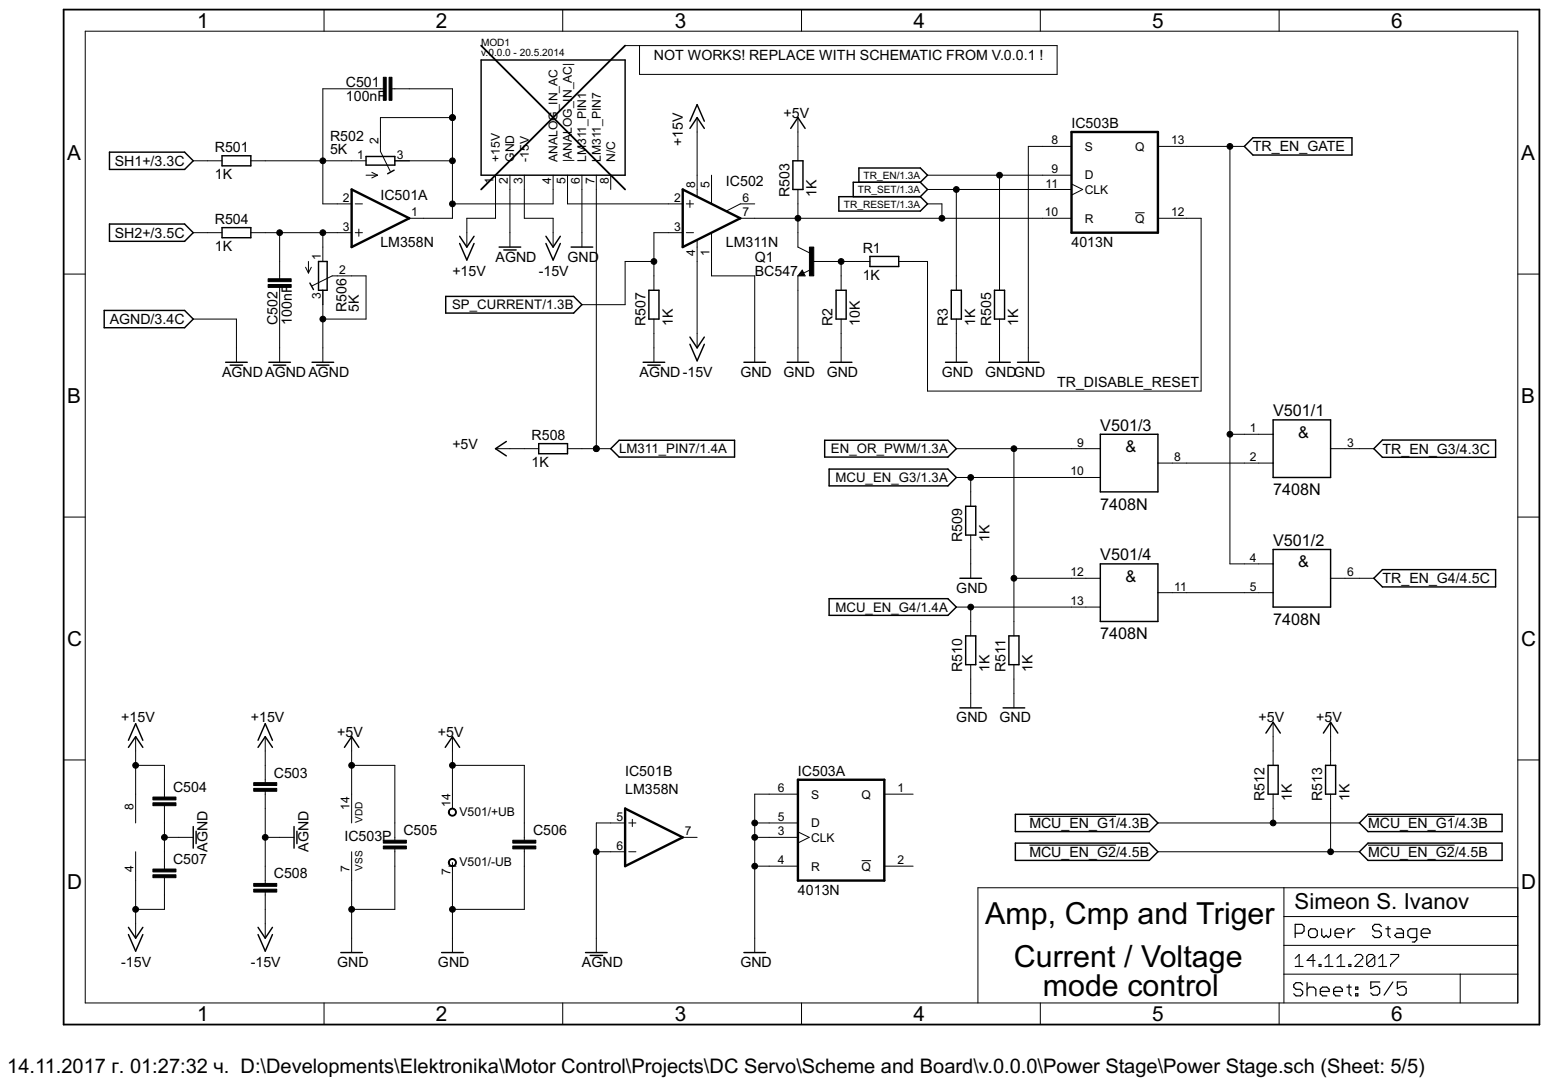
[picture p84: page 5]

NOT WORKS! REPLACE WITH SCHEMATIC FROM V.0.0.1 !

Amp, Cmp and Triger
Current / Voltage
mode control

14.11.2017 г. 01:27:32 ч. D:\Developments\Elektronika\Motor Control\Projects\DC Servo\Scheme and Board\v.0.0.0\Power Stage\Power Stage.sch (Sheet: 5/5)
