SimeonSimeonovIvanov/DC-Servo/Scheme and Board/v.0.0.0/Precision Rectifier/v.0.0.0/Precision Rectifier (All Side).pdf

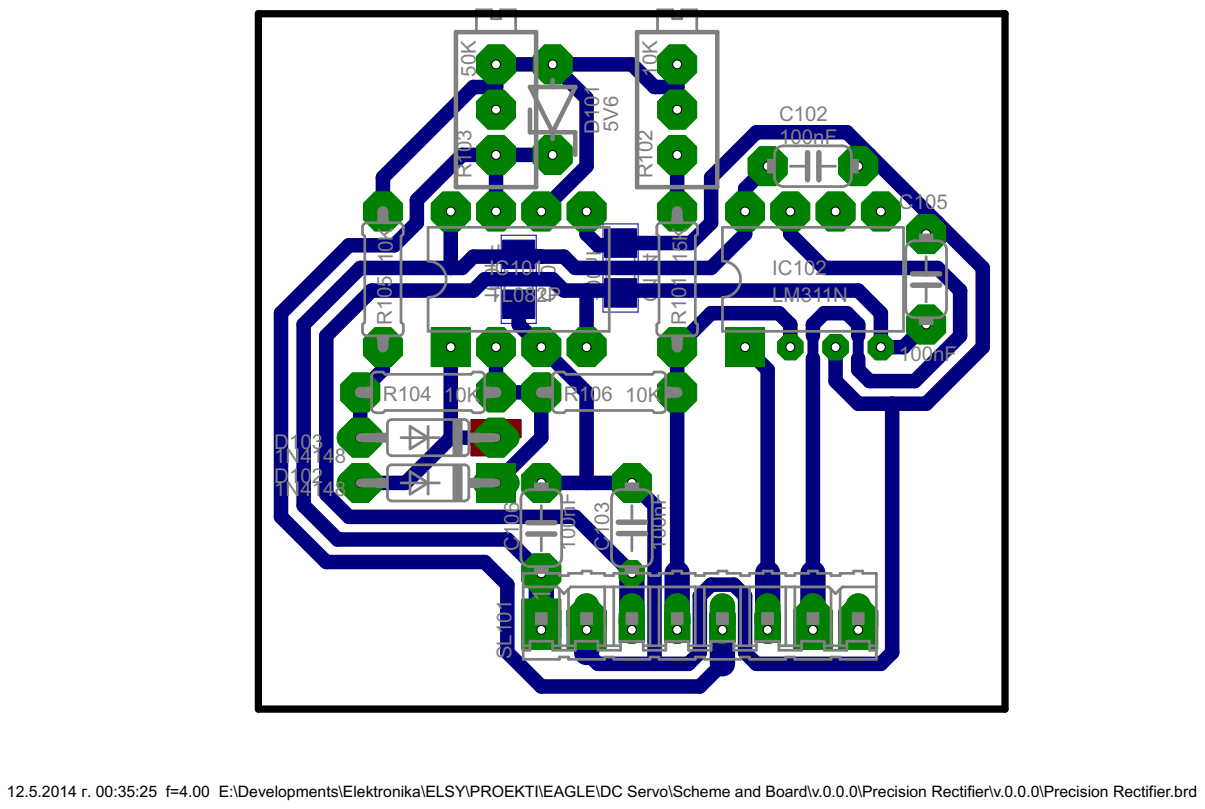
[picture p85: page 1]

12.5.2014 г. 00:35:25 f=4.00 E:\Developments\Elektronika\ELSY\PROEKTI\EAGLE\DC Servo\Scheme and Board\v.0.0.0\Precision Rectifier\v.0.0.0\Precision Rectifier.brd
