SimeonSimeonovIvanov/DC-Servo/Scheme and Board/Work/ENCODER/UP And DOWN Counter Signals/v.0.0.0/main (All Side).pdf

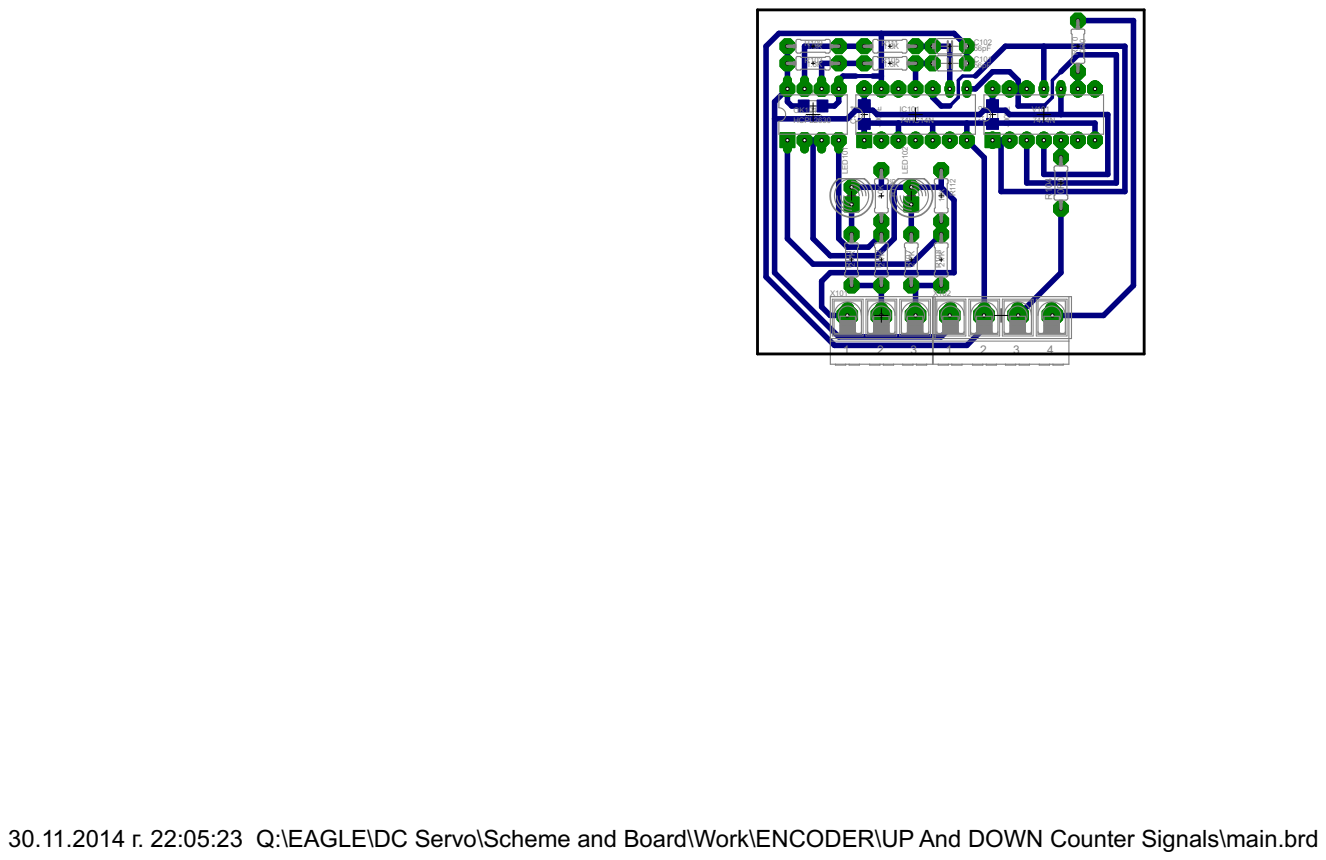
[picture p86: page 1]

30.11.2014 г. 22:05:23 Q:\EAGLE\DC Servo\Scheme and Board\Work\ENCODER\UP And DOWN Counter Signals\main.brd
