SimeonSimeonovIvanov/DC-Servo/Work/Simulation/CURRENT PWM/CURRENT PWM and DC Motor.asc

A1: dflop; 5
A2: and
C1: polcap; 9400µ; V=63 Irms=10 Rser=0.032 Lser=0
C2: cap; 88pF
D1: schottky; MBR20100CT
D2: schottky; MBR20100CT
R1: res; 0.1
R2: res; 1k
R3: res; 1k
R4: res; 1k
R5: res; 9k
R6: res; 10
S1: sw; SW1
U1: LT1215
U2: LT1018
V1: voltage; 45; Rser=0.5
V2: voltage; PULSE(0 5 0 0 0 19uS 20uS)
V3: voltage; 6
V5: voltage; 15
V7: voltage; SINE(2.5 2.5 100 0 0 0 2)
X2: DC_Motor
Named nets: 0, U1_OUT, U1_FB, U2_SP, Omega
.tran 15mS
.model SW1 SW(Ron=0.1 Roff=1Meg Vt=0.5 Vh=-.4)
