SimeonSimeonovIvanov/DC-Servo/Work/Simulation/CURRENT PWM/CURRENT PWM.asc

A1: dflop; 5
A2: and
C1: polcap; 9400µ; V=63 Irms=10 Rser=0.032 Lser=0
C2: cap; 100pF
D1: schottky; MBR20100CT
D2: schottky; MBR20100CT
L1: ind; 450µH; Rser=0.68
R1: res; 0.1
R2: res; 1k
R3: res; 1k
R4: res; 1k
R5: res; 9k
S1: sw; SW1
U1: LT1215
U2: LT1018
V1: voltage; 55; Rser=0.5
V2: voltage; PULSE(0 5 0 0 0 19.9uS 20uS)
V3: voltage; 6
V5: voltage; 15
V6: voltage; 20
V7: voltage; SINE(2.5 2.5 100 0 0 0 2)
Named nets: 0
.tran 15mS
.model SW1 SW(Ron=0.1 Roff=1Meg Vt=0.5 Vh=-.4)
