SimeonSimeonovIvanov/DC-Servo/Work/Simulation/CURRENT PWM/DC_Motor.asc

B1: bi2; I=k*I(Bemf)
Bemf: bv; V=k*V(omega)
C_Jinertia: cap; {J}
I_load_torque_int: bi; I=sgn(v(omega))*min(Tint,0.1*abs(v(omega)))
Larm: ind; {LM}
R_Bfriction: res; {1/B}
Rarm: res; {RM}
Named nets: +, -, omega, omega_gnd
.param RM = 0.608
.param k = 0.9
.param J = 0.5m
.param B = 3.33m
.param Tint = 150mA
.param LM = 450uH
