SimeonSimeonovIvanov/DC-Servo/(commit log)

2016-12-30 D:\Developments\Elektronika\Motor Control\Projects\DC Servo
    [Power Stage.brd, Power Stage.sch, Precision Rectifier.brd, Precision Rectifier.sch, Speed Reg.brd, Speed Reg.sch, main.brd, main.sch]
2020-05-08 Fix potential Stack/Memory corruption
    [enc424j600.c]
