SimeonSimeonovIvanov/DC-Servo/(notices)

Notices in the files:
src/v.0.0.1/ServoController/main_servo.c:
it under the terms of the GNU General Public License as published by
the Free Software Foundation, either version 3 of the License, or
any later version.
